WilliamVanRaemdonck/Project_Practise_Enterprise_2_Amplifier/3. Documents/WilliamVanRaemdonck_R0880147_PE2.pptx

## Practice Enterprise Electronics 2

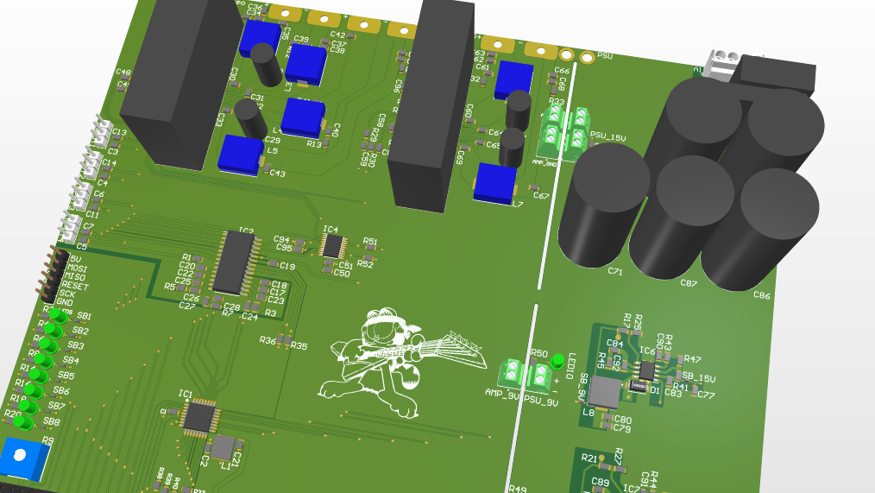
[picture p2: figure]

William Van Raemdonck

## Agenda

- Blokschema
- Componenten
- PCB
- Besluit
- Demo

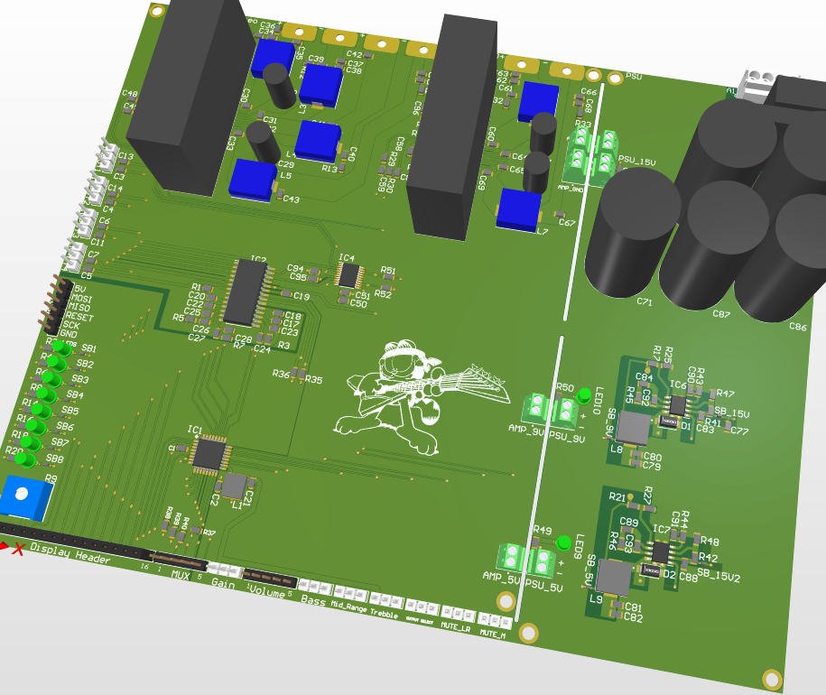
[picture p3: figure]

## Blokschema

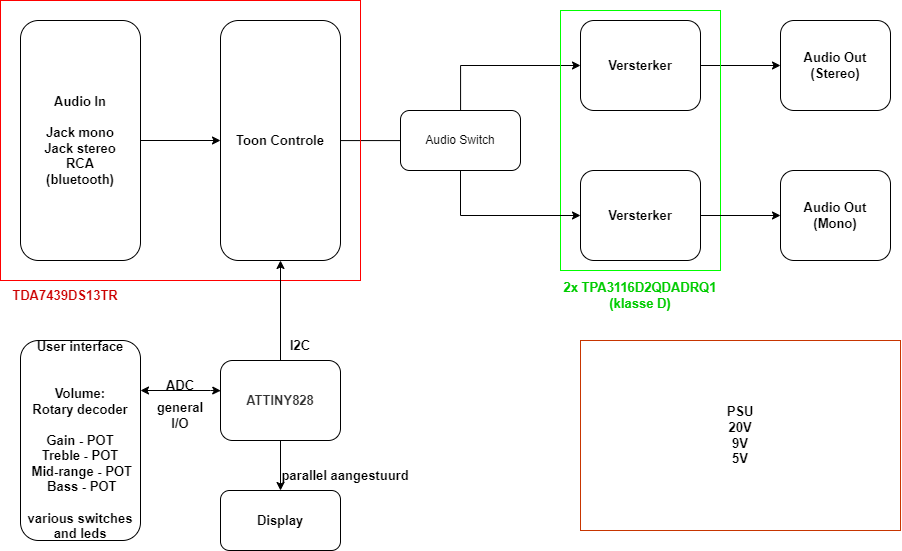
[picture p4: figure]

## Audio controle

- TDA7439DS

- MUX
- Filters
- I2C

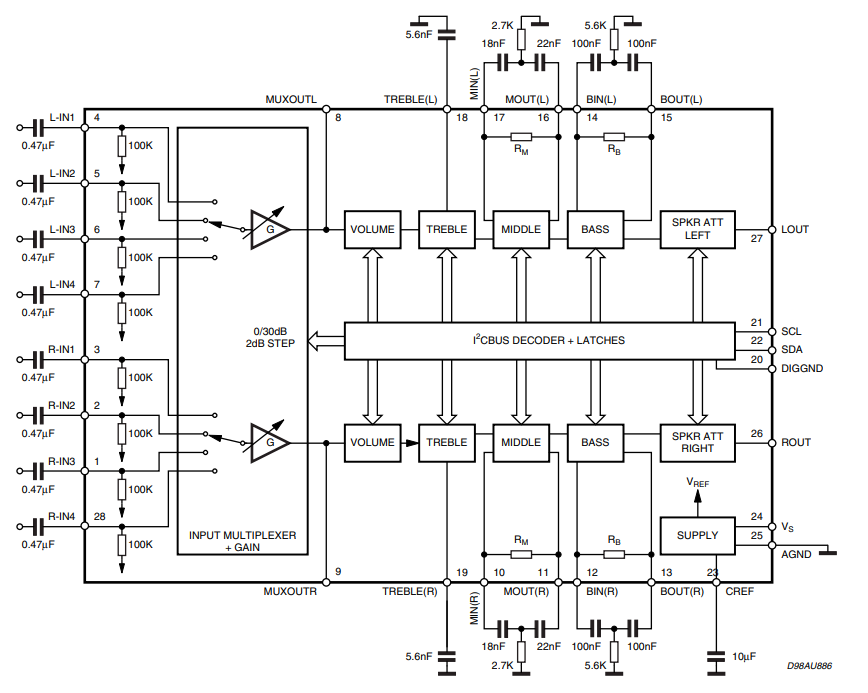
[picture p5: figure]
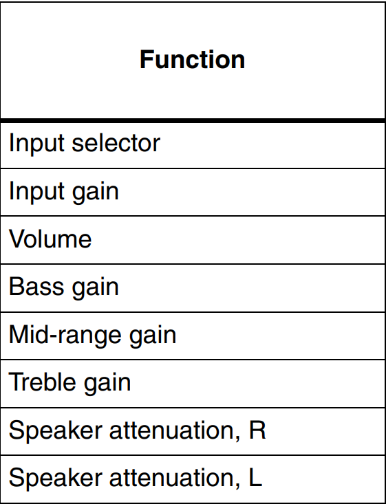
[picture p6: figure]

## Audio switch

- TMUX1134

- Stereo/Mono
- MUTE

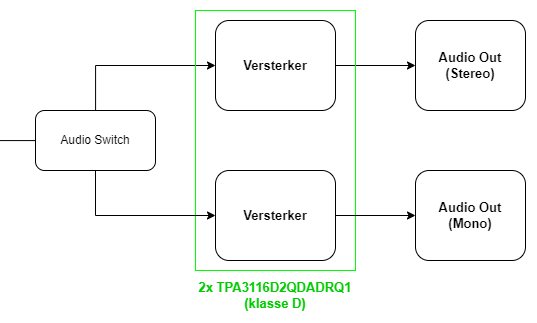
[picture p7: figure]

## Klasse D versterker

- TDA7439DS

- Klasse D
- Stereo/Mono
- Fault system

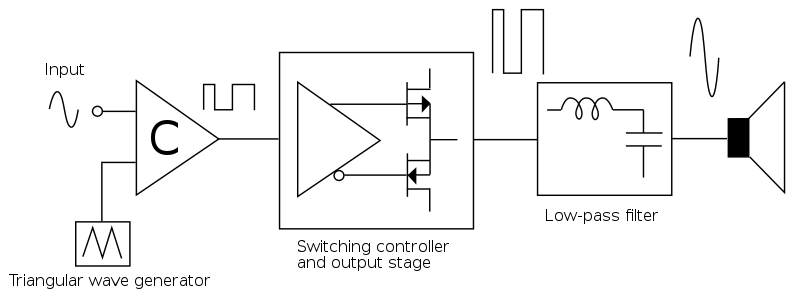
[picture p8: figure]
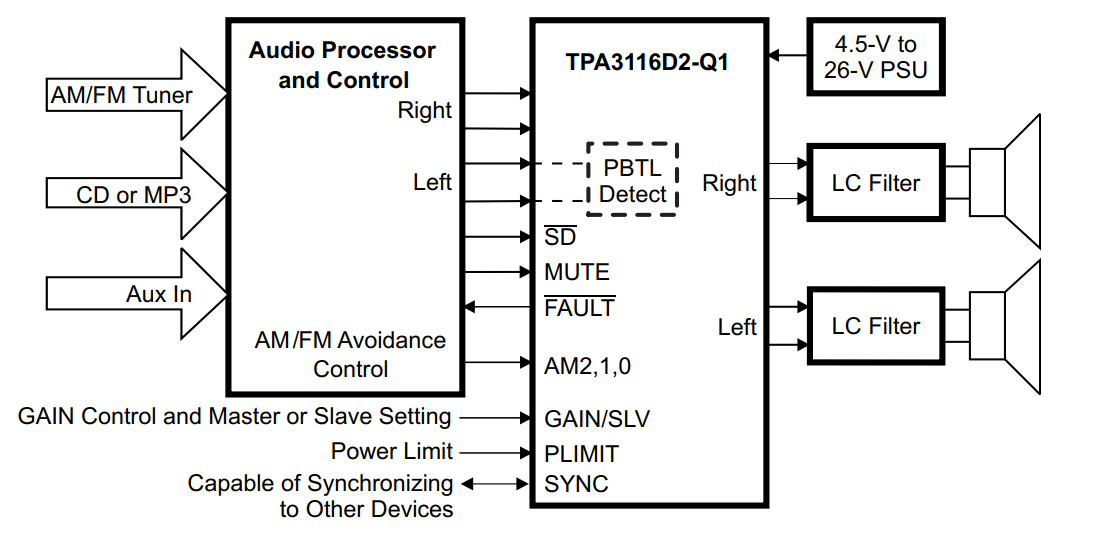
[picture p9: figure]

## Microcontroller

- ATtiny828

- 8Mhz – 8bit
- C
- XC888

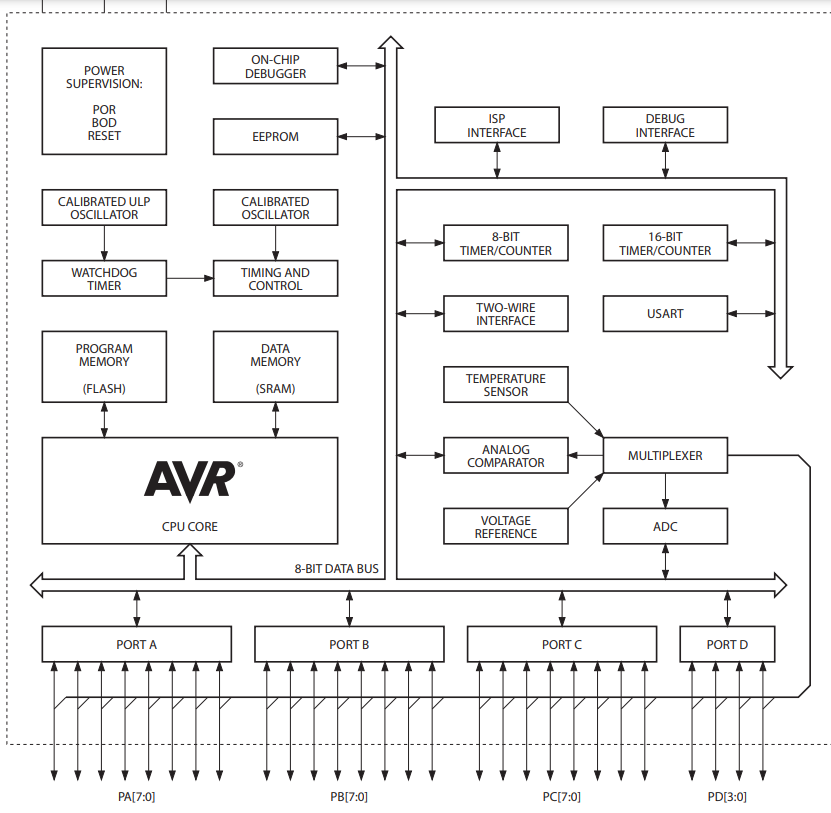
[picture p10: figure]

## Microcontroller

- Programmeren

- ICSP

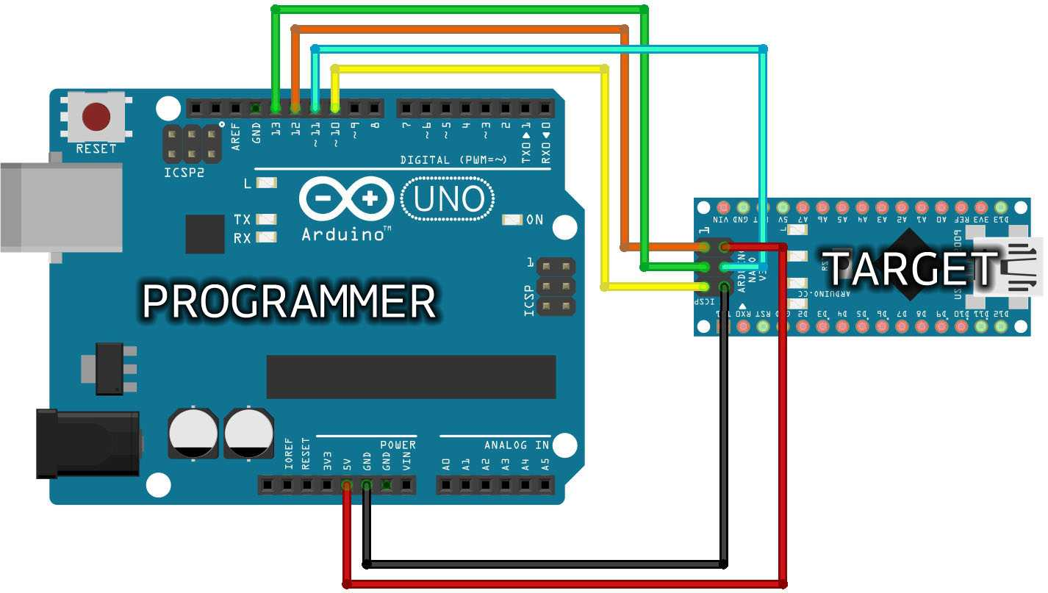
[picture p11: figure]
Arduino as ISP and Arduino Bootloaders | Arduino Documentation

## Display

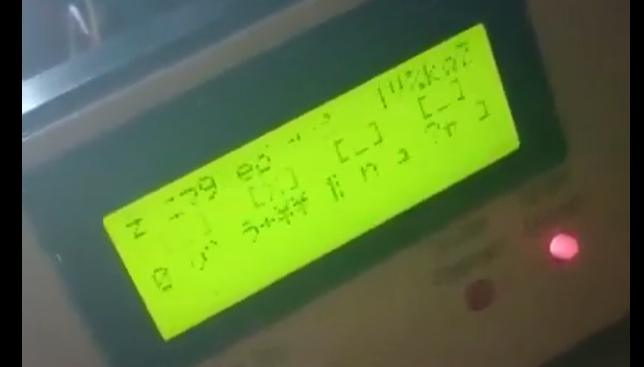
[picture p12: figure]
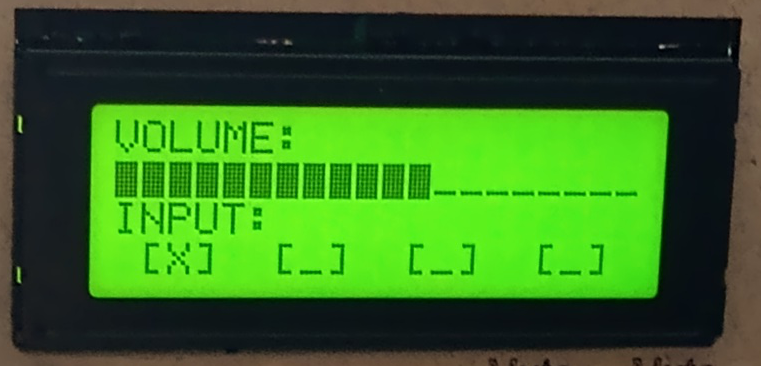
[picture p13: figure]

- 4 bit mode - Parallel
- Anomalie

## PCB

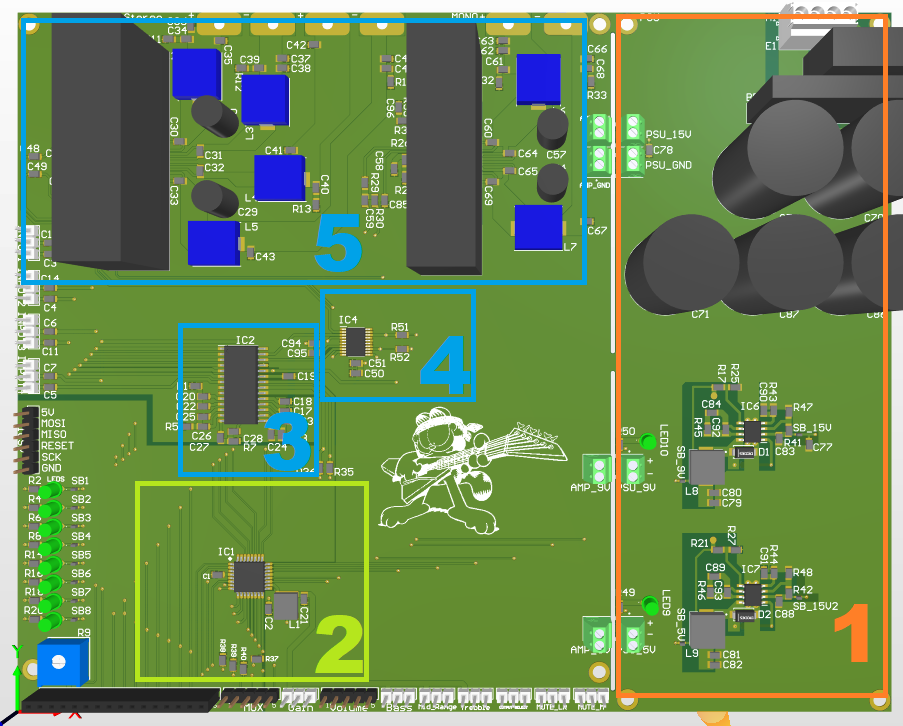
[picture p14: figure]

## Besluit

PCB redelijk groot
DSP
Nameten (want meten is weten)

## Vragen en demo moment
