WilliamVanRaemdonck/Project_Practise_Enterprise_2_Amplifier/3. Documents/Project Practise Enterprise 2 R0880147.docx

# Practice Enterprise Electronics 2

2022 – 2023

Thomas More

William Van Raemdonck

# Inleiding

Voor Project Practice Enterprise 2 heb ik een audio versterker gemaakt. Deze versterker is zodanig opgebouwd dat hij zowel een mono en stereo signaal kan versterken. Er zit ook een IC in dat tooncontrole doet. Deze wordt aangestuurd door een ATtiny828.

“I have a dream.”

Martin Luther King 1963

# Dankwoord

Dankuwel Dams.

# Blokschema

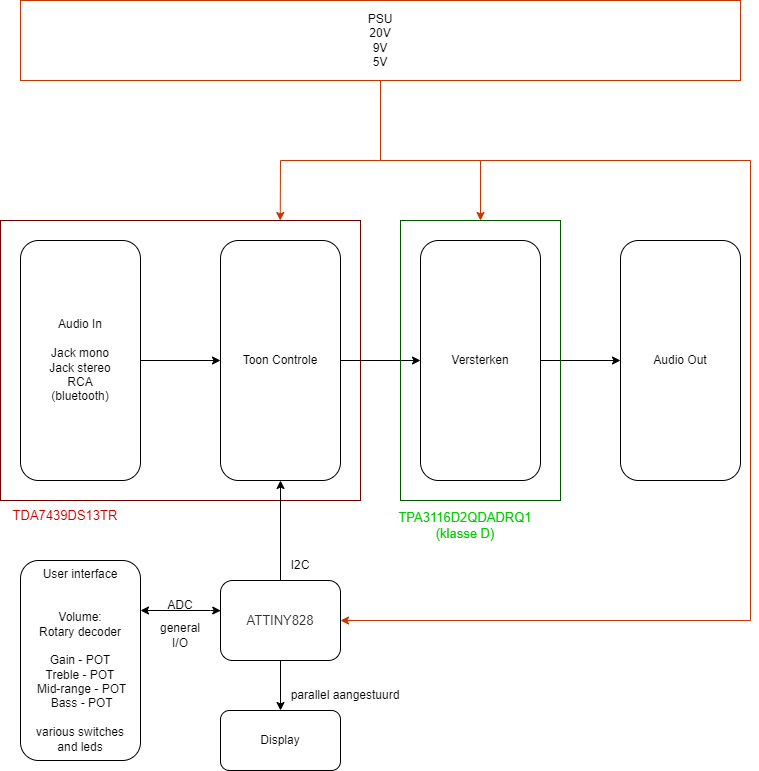
[picture p15: figure]

## Uitleg Blokschema

De power supply gaat 20V leveren voor de versterker IC’s, 9V voor de tooncontrole IC en 5V voor de microcontroller en lcd-paneel.

De tooncontrole IC wordt aangestuurd via een I2C verbinding tussen de microcontroller en deze IC.

De microcontroller gaat zijn ADC en I/O pinnen gebruiken om de gain, bass, midrange, treble, volume waardes in te lezen en door te sturen.

De display is aangestuurd via een 4 bit parallelle verbinding met de microcontroller.

# Componenten

## ATtiny828:

Dit is een 8 Bit controller die tegen 8MHz draait.

Deze IC is vergelijkbaar met de XC888 dat we vorig jaar moesten gebruiken met het belangrijk verschil dat deze gemakkelijk in C kan geprogrammeerd kan worden.

Datasheet: https://ww1.microchip.com/downloads/en/DeviceDoc/doc8371.pdf


## TDA7439DS:

Figuur 1: Registers

Deze IC gaat de audiocontrole doen, hij is aangestuurd via de ATtiny controller via een software I2C verbinding.

Er bestaan registers waarbij de waardes in de figuur hiernaast kunnen worden aangepast.

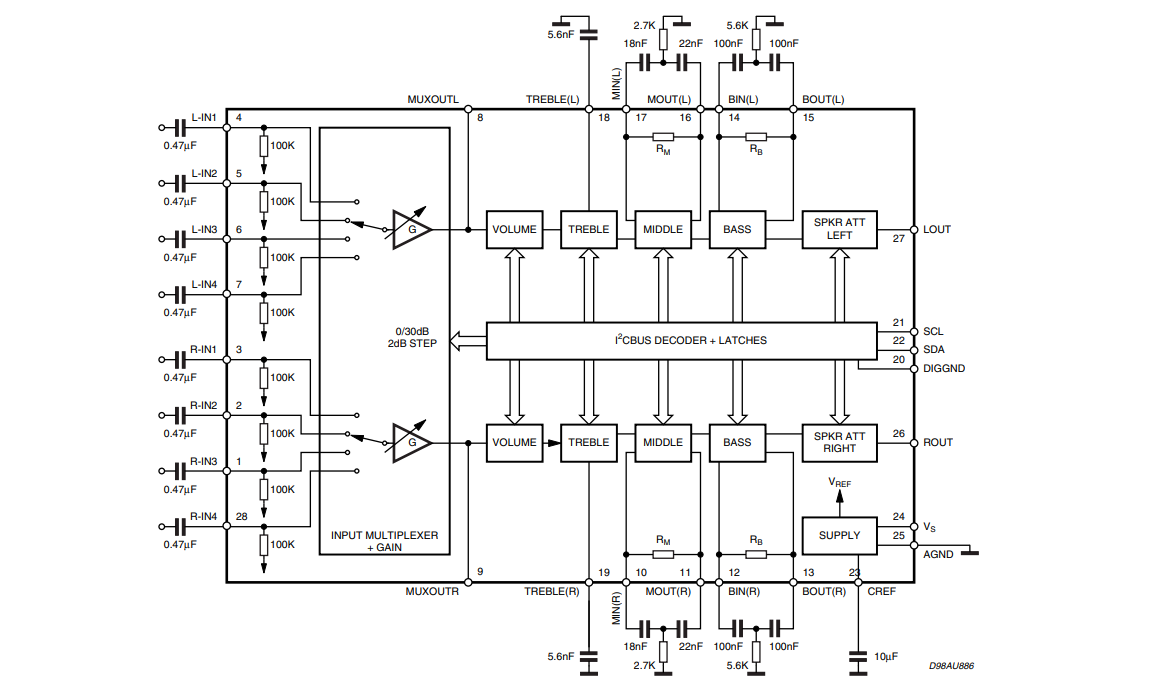
[picture p16: figure]

Figuur 2: Waardes uit datasheet

## TPA3116D2-Q1:

Twee van deze IC’s zitten in deze versterker. Één als stereo en één als mono versterker.

Deze IC heeft een systeem dat fouten detecteert. Het is aangesloten zodat fouten gecleared worden wanneer de fout verdwijnt.

Datasheet:

https://www.ti.com/lit/ds/symlink/tpa3118d2-q1.pdf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

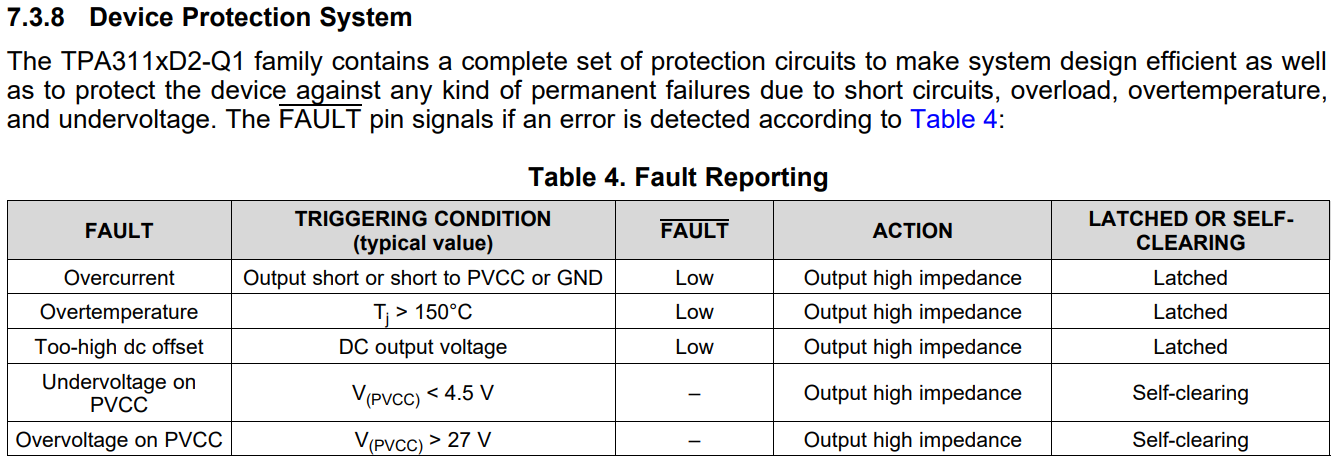
[picture p17: figure]

Gekozen instelling:

PVCC = 20V => output voltage van ongeveer 14,916V. ?? check dees

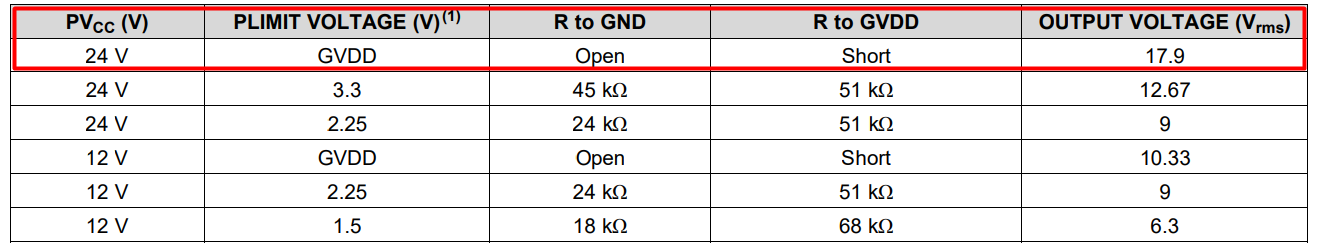
[picture p18: figure]

Gain = 26dB.

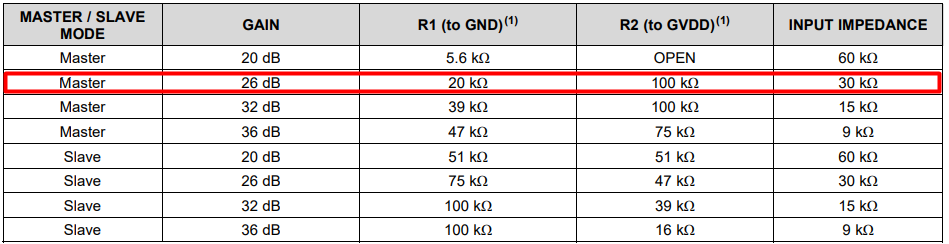
[picture p19: figure]

Input condensatoren.

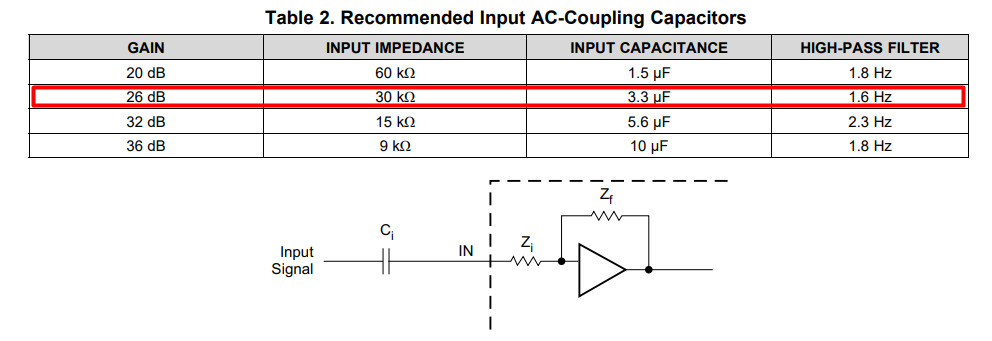
[picture p20: figure]

Oscillator frequentie.

Stroom.

Vout max = 14,916V

Rspeaker = 4Ω

Imax = 3,729A

Koeling.

De datasheet zegt dat deze koelvin moet gebruikt worden.

Datasheet:

https://www.mouser.be/ProductDetail/984-ATS-TI1OP521C1R1

## TMUX1134:

Deze IC schakelt van tussen de stereo en mono versterker door het audiosignaal van de ene versterker naar de andere te sturen. Tegelijkertijd wordt de versterker IC dat niet gebruikt wordt ook gemute zodat de uitgang tevens ook hoog impedant gaat.

Het audiosignaal heeft een 3,8V dc-offset en het mute signaal zit tussen de 0 en 5V. Dit is omdat ik zo geen extra transistor of FET moest bijplaatsen om het MUTE-signaal te kunnen regelen.

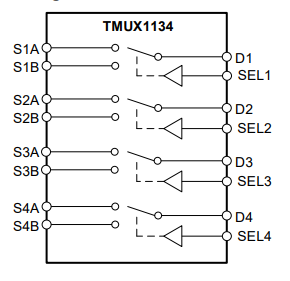
[picture p21: figure]

Figuur 3: Audio switch

## Display:

Deze display is parallel aangesloten aan de microcontroller. De 1e en 3e lijn zijn constante strings die tijdens initialisatie worden doorgestuurd.

De lijn indicator die het volume aanduidt wordt op runtime gemaakt. De string die de input aangeeft wordt geselecteerd met een look up table.

Voor de display in te stellen zijn de volgende instellingen gebruikt.

Function Set:

- 4 bit interface
- 2 lines
- Font size 8 x 5

De display heeft ook 2 andere lijnen: de enable en RS-lijn. De enable wordt gebruikt als een klok lijn om nieuwe data binnen te klokken. De RS-lijn bepaalt of je naar een data of instructie register schrijft. Verder is er ook nog de R/W lijn maar in dit geval hangt deze aan ground omdat er alleen maar geschreven moet worden.

Om bij te houden naar welke welke plaats op de display er geschreven moet worden wordt gebruik gemaakt van het DDRAM-adres. Startende van 0x80 tot 0xe7.

VOLUME: adres: 0x80

█████____________ adres: 0xc0

INPUT: adres: 0x94

[_] [_] [X] [_] adres: 0xd4


Figuur 4: Display

# PCB


Figuur 5: pcb-voorkant

Zone 1: Power Supply.

Zone 2: Microcontroller

Zone 3: Audiocontrole IC.

Zone 4: Audio switch

Zone 5: Mono/Stereo versterker.

# Schema’s

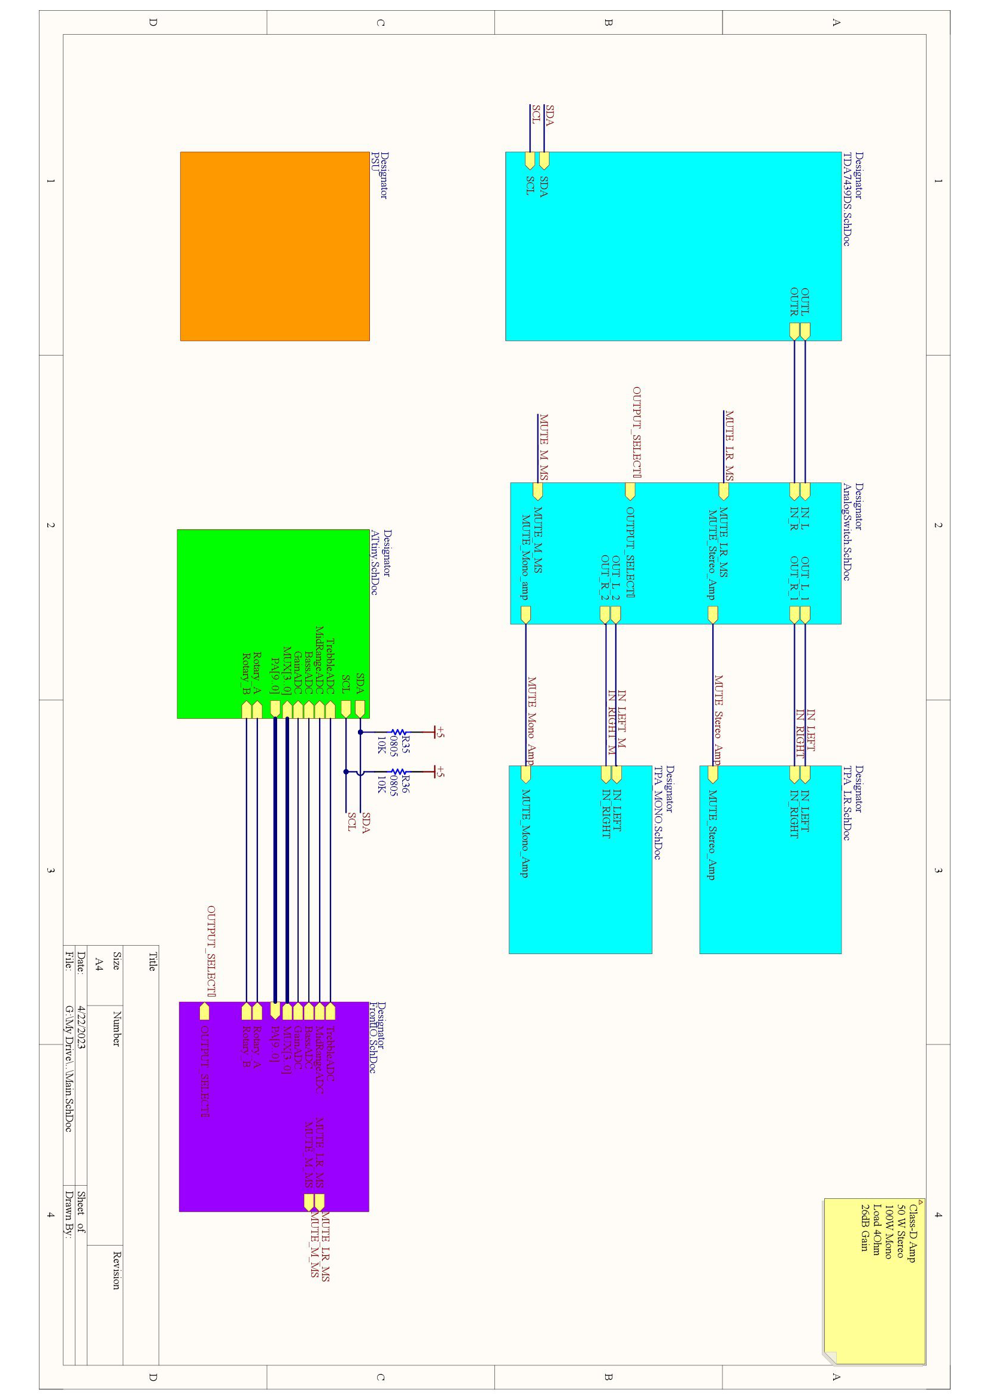
[picture p22: figure]
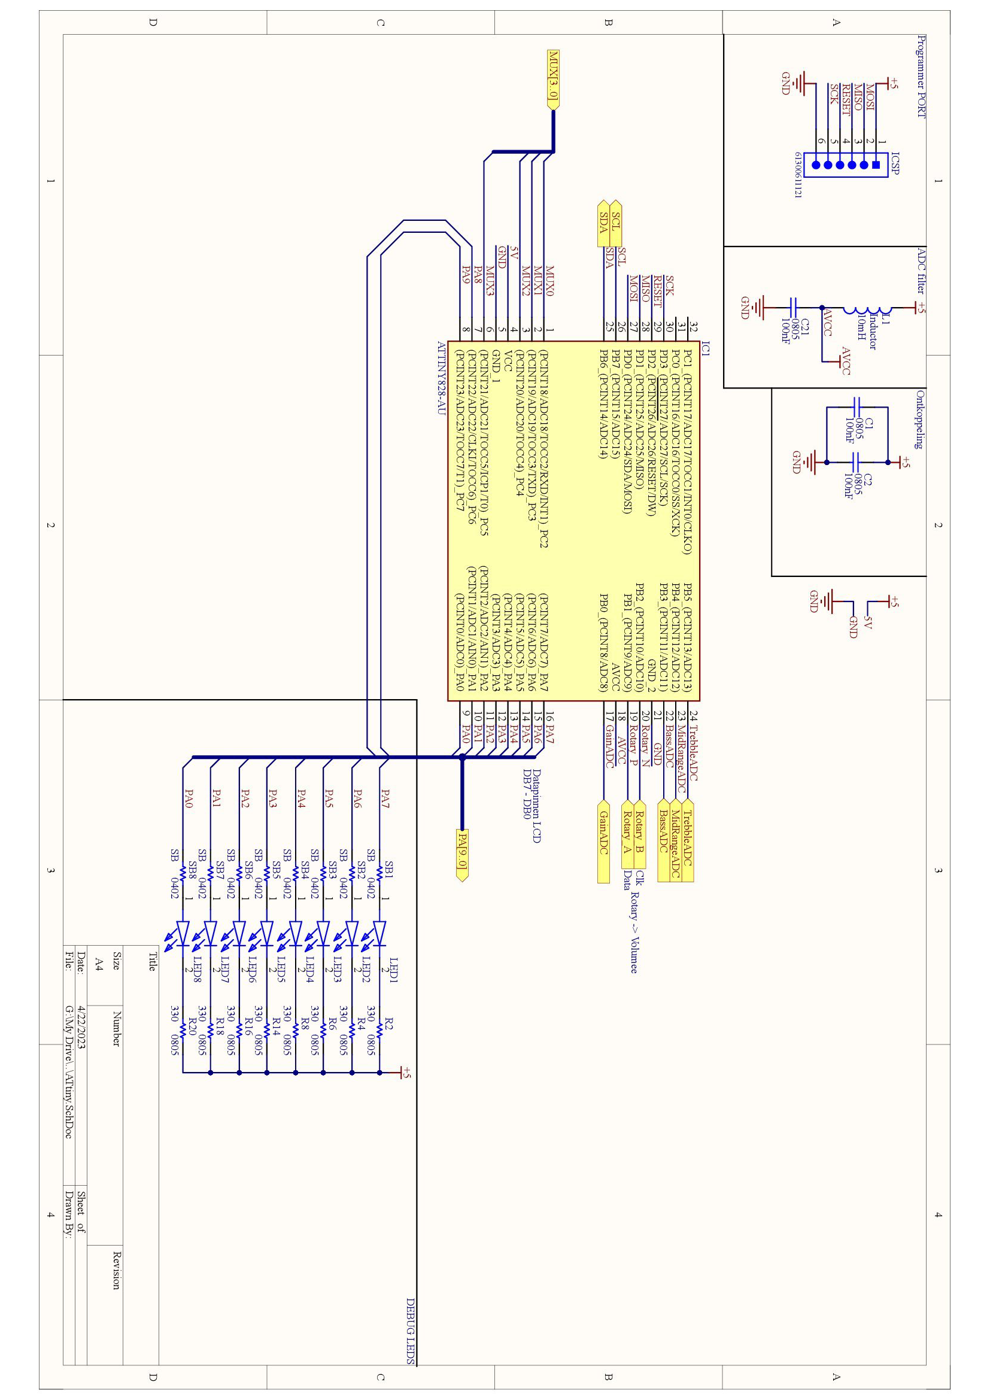
[picture p23: figure]
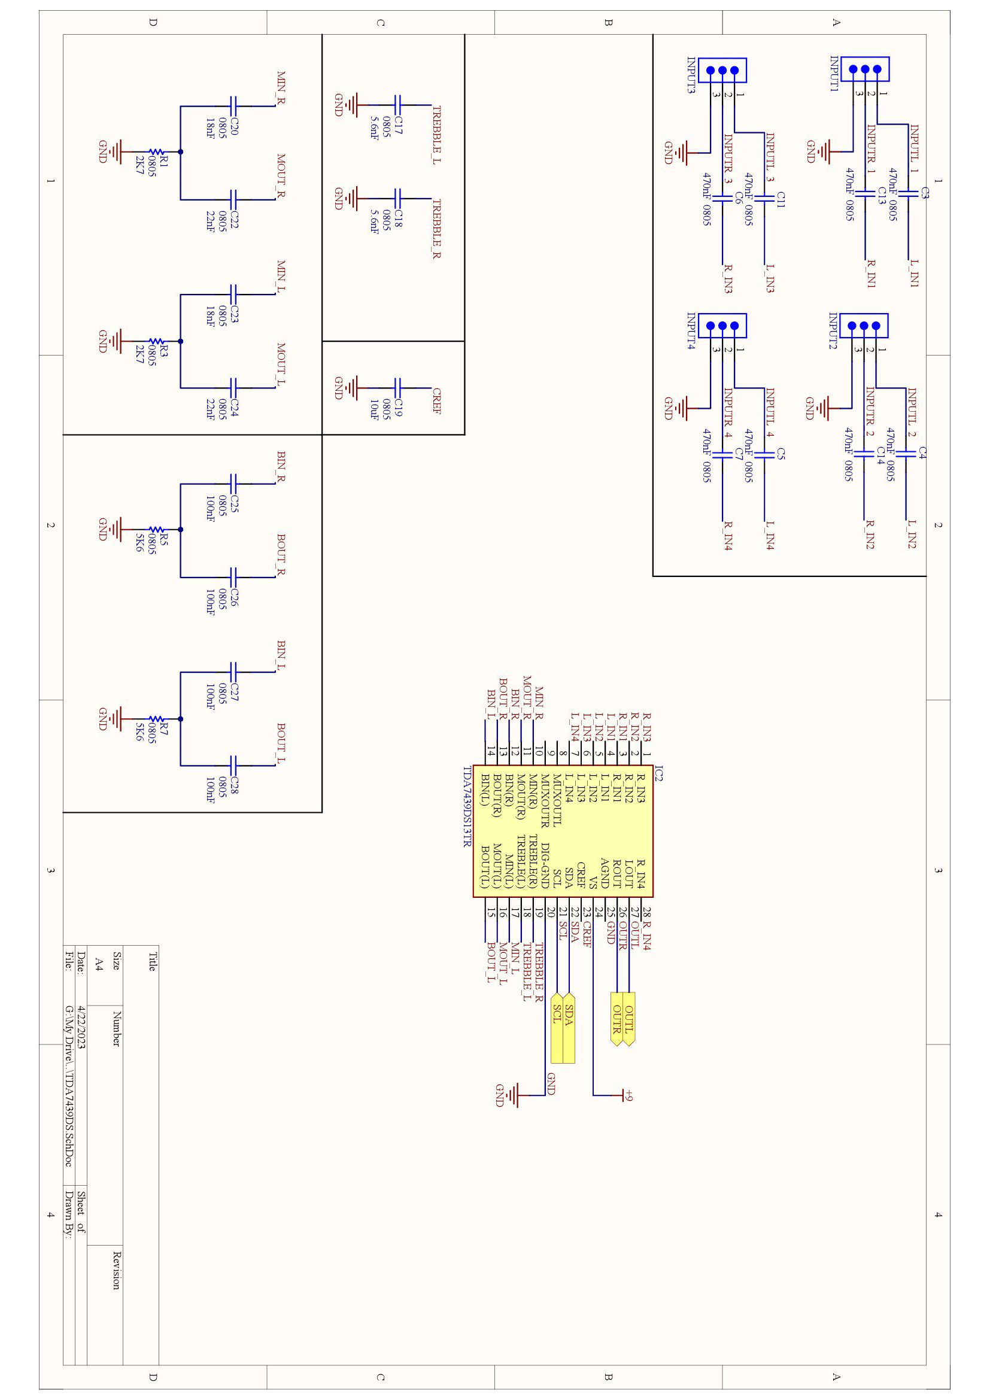
[picture p24: figure]
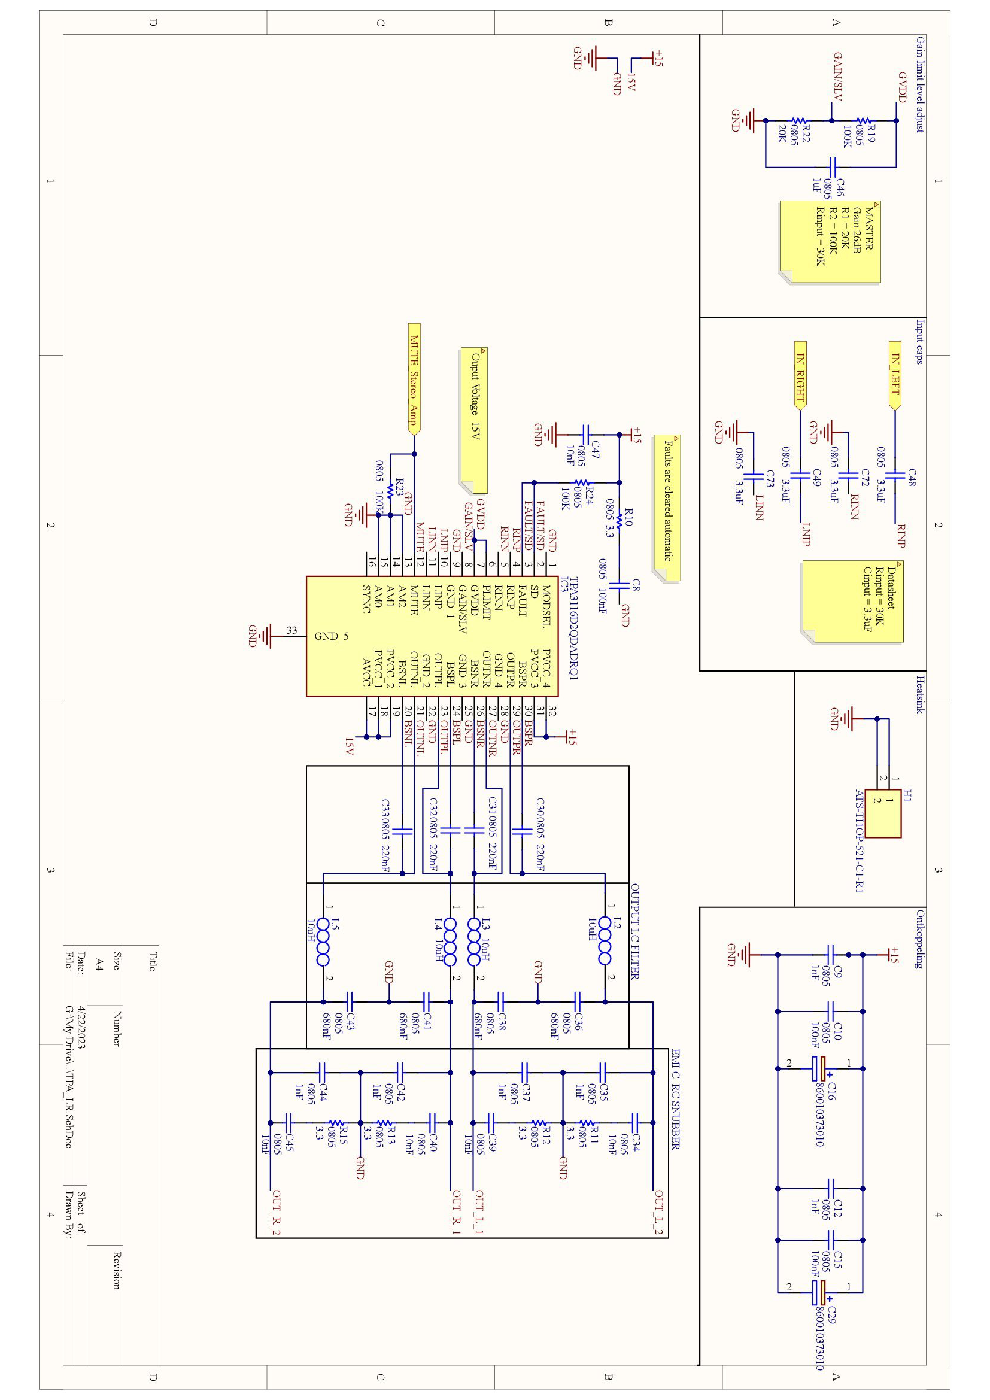
[picture p25: figure]
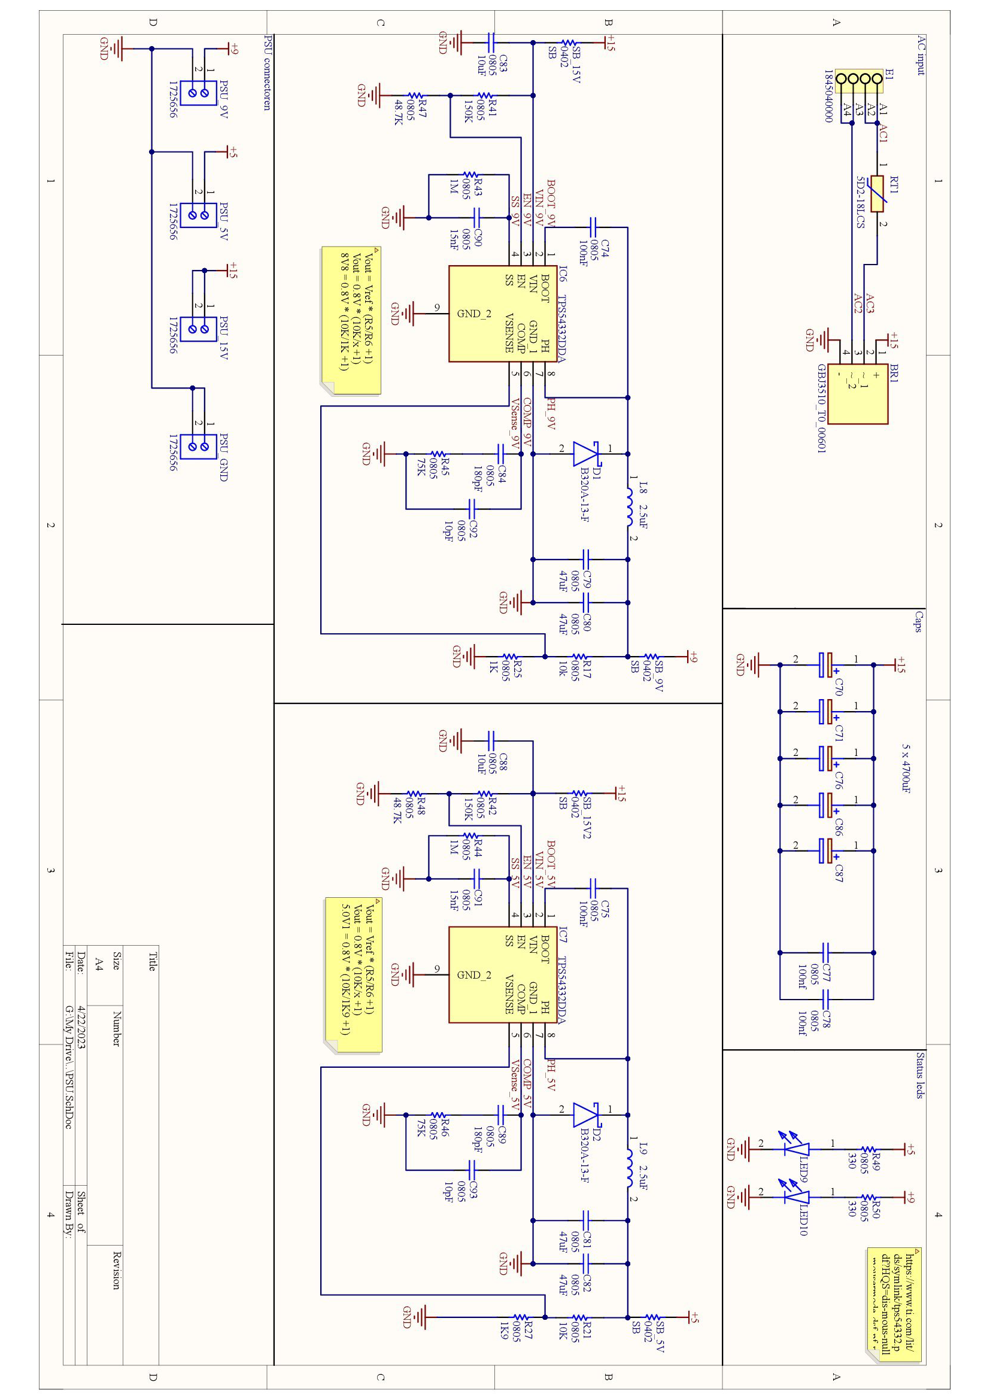
[picture p26: figure]
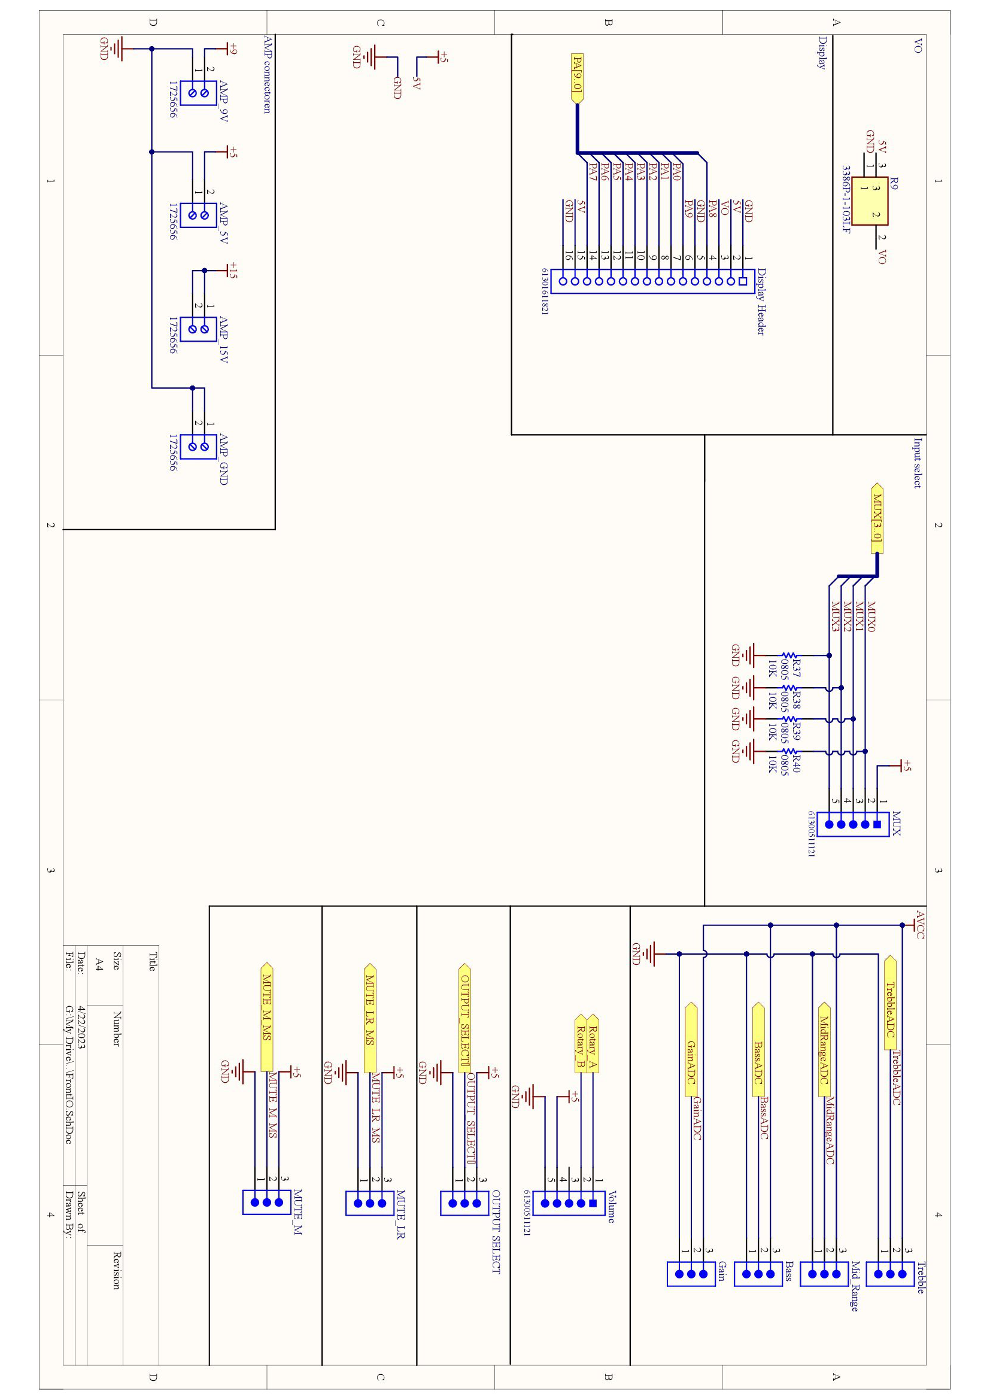
[picture p27: figure]
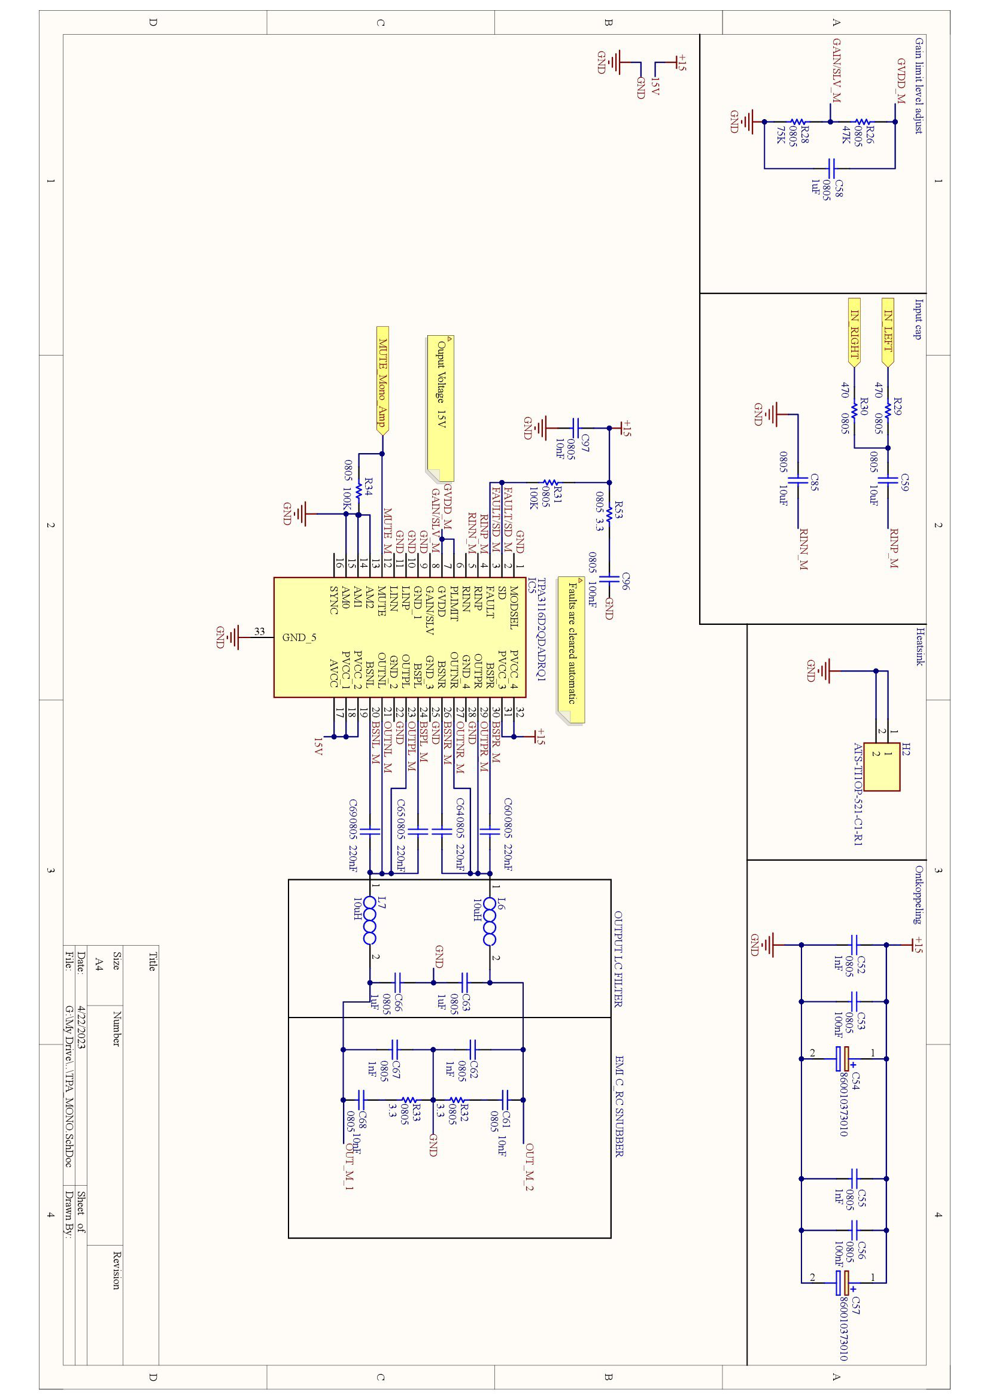
[picture p28: figure]
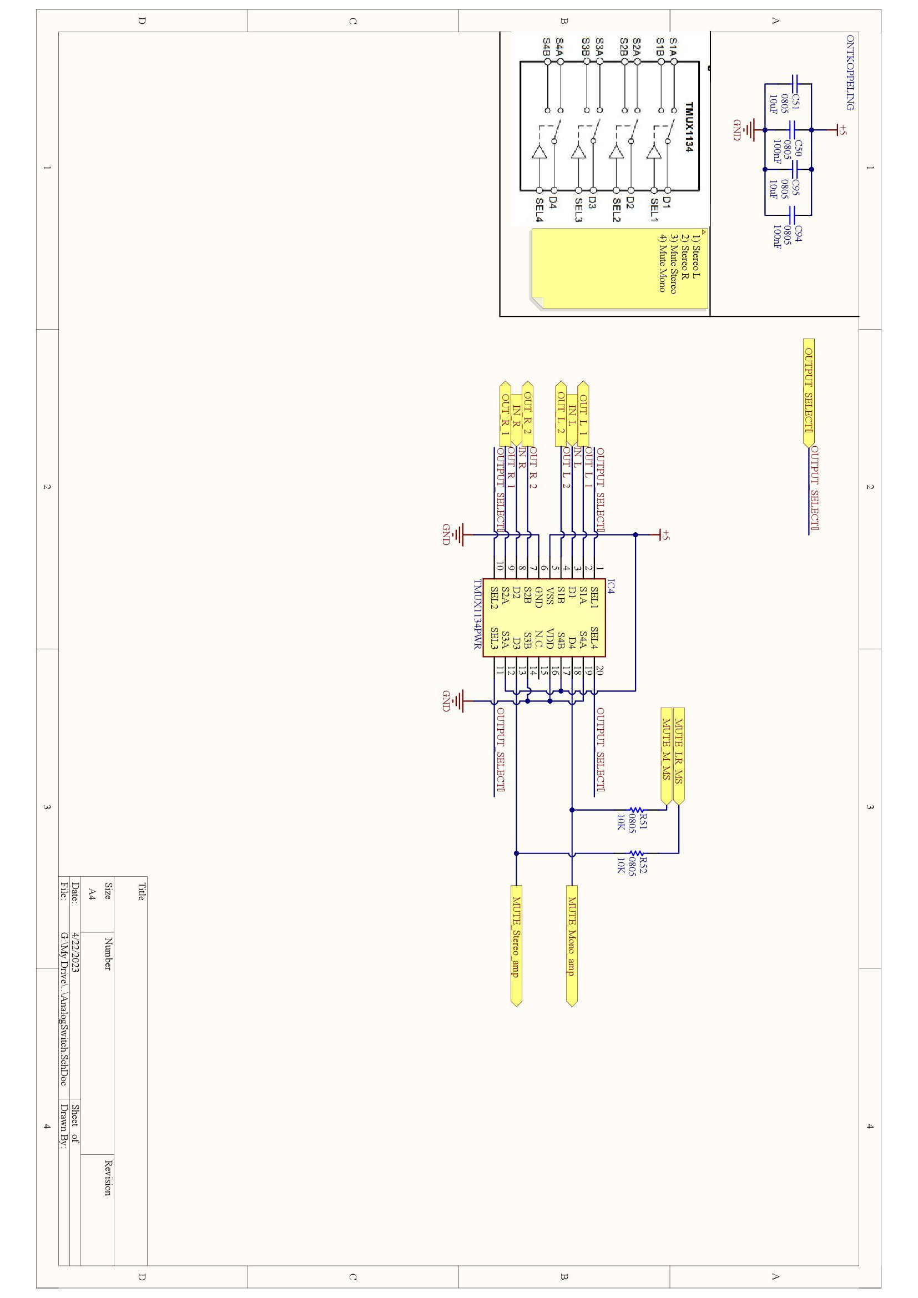
[picture p29: figure]

# Code

# BOM

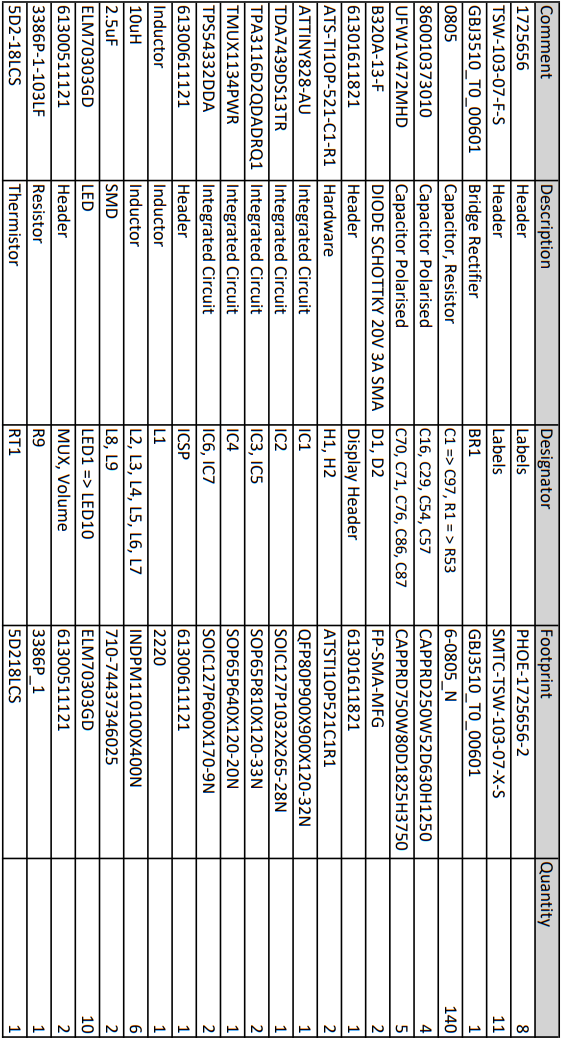
[picture p30: figure]

Figuur 6: Bom lijst

# Bibliografie

Datasheets:

ATtiny828:

https://ww1.microchip.com/downloads/en/DeviceDoc/doc8371.pdf

TPA3118d2:

https://www.ti.com/lit/ds/symlink/tpa3118d2-q1.pdf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

TDA7439DS:

https://www.mouser.be/datasheet/2/389/cd00010668-1796242.pdf

Display:

https://uk.beta-layout.com/download/rk/RK-10290_410.pdf

Code:

Reverse Bits in Byte:

https://stackoverflow.com/questions/2602823/in-c-c-whats-the-simplest-way-to-reverse-the-order-of-bits-in-a-byte

Chat.gpt:

General code optimalisatie.
