WilliamVanRaemdonck/Project_Practise_Enterprise_2_Amplifier/3. Documents/Project Practise Enterprise 2 R0880147 William Van Raemdonck.pdf

1

2022 – 2023

Thomas More
William Van Raemdonck

# Practice Enterprise Electronics 2

2

# Inleiding

Voor Project Practice Enterprise 2 heb ik een audioversterker gemaakt. Deze versterker is zodanig opgebouwd dat hij zowel een mono-en stereosignaal kan versterken. Er zit ook een IC in die tooncontrole doet, die op zijn beurt wordt aangestuurd door een microcontroller.

Verder ben ik in de zomervakantie van vorig jaar al gestart aan dit project door een development bordje te maken voor de ATtiny828. Dit heb ik vooral gedaan omdat ik niet meer met de XC888 van vorig jaar wou werken. Dit bordje heeft mij ook toegelaten om al code te schrijven voor de PCB geleverd was. De details hierover staan ook in de bijlage.

Bijlage in aparte documenten: https://github.com/WilliamVanRaemdonck/Project_Practise_Enterprise_2_Amplifier

## “Do or do not. There is no try.” Yoda - The Empire Strikes Back

3

# Dankwoord

Het maken van deze versterker tijdens het afgelopen academiejaar was een leerrijke periode. Ik had deze taak nooit zo goed afgerond zonder de hulp van een paar mensen.

Een bijzonder woord van dank gaat uit naar meneer Dams, die de tijd nam om constructieve feedback te geven. Zijn wijze raad als mentor heeft me geholpen om problemen te analyseren. Hij stelde me goeie vragen die ervoor gezorgd hebben dat ik oplossingsgericht kon werken.

Ik wil eveneens meneer De Weerdt en meneer Pelgrims bedanken voor het delen van hun kennis.

Ook mijn vrienden en familie hebben me steeds aangemoedigd zodat ik me gesteund voelde om dit project tot een goed einde te brengen.

William Van Raemdonck

4

Contents


5

# Blokschema

6

## Uitleg Blokschema

De power supply levert 20V voor de versterker IC’s, 9V voor de tooncontrole IC en 5V voor de microcontroller en het lcd-paneel.

De tooncontrole IC wordt aangestuurd door een microcontroller via een software I2C verbinding.

De microcontroller gebruikt zijn ADC en I/O pinnen om de gain, bass, midrange, treble, volume waardes in te lezen. Hij gaat hier dan omzettingen op doen om daarna door te sturen naar de audiocontrole IC.

De display is aangestuurd via een 4 bit parallelle verbinding met de microcontroller.

7

# Componenten

## ATtiny828:

Dit is een 8 Bit controller die met een klok frequentie van 8Mhz.

Deze IC is vergelijkbaar met de XC888 dat we vorig jaar moesten gebruiken met het belangrijk verschil dat deze gemakkelijk in C geprogrammeerd kan worden en iets minder I/O pinnen heeft.

De belangrijkste delen van deze microcontroller zijn:
Hardware SPI.
Hardware I2C slave.
Full Duplex USART
2 timers waarvan één 16 bit.
32 ADC kanalen (10 bit resolutie).
20MHz kloksnelheid.

De IC wordt geprogrammeerd via de ICSP pinnen van een Arduino, je kan ook een AVR programmer kopen. Ik heb deze optie gekozen omdat deze gratis was.

Om code in deze controller te krijgen staat er een condensator op de reset pin van een Arduino nadat deze zelf geprogrammeerd is als ISP programmer. Hierna zal Microchip studio zijn code sturen naar AVRDUDE om de code naar de Arduino en dus ook de ATtiny te sturen. AVRDUDE kent de ATtiny828 niet maar er is een override optie zodat deze de code toch uploadt.

## TDA7439DS:

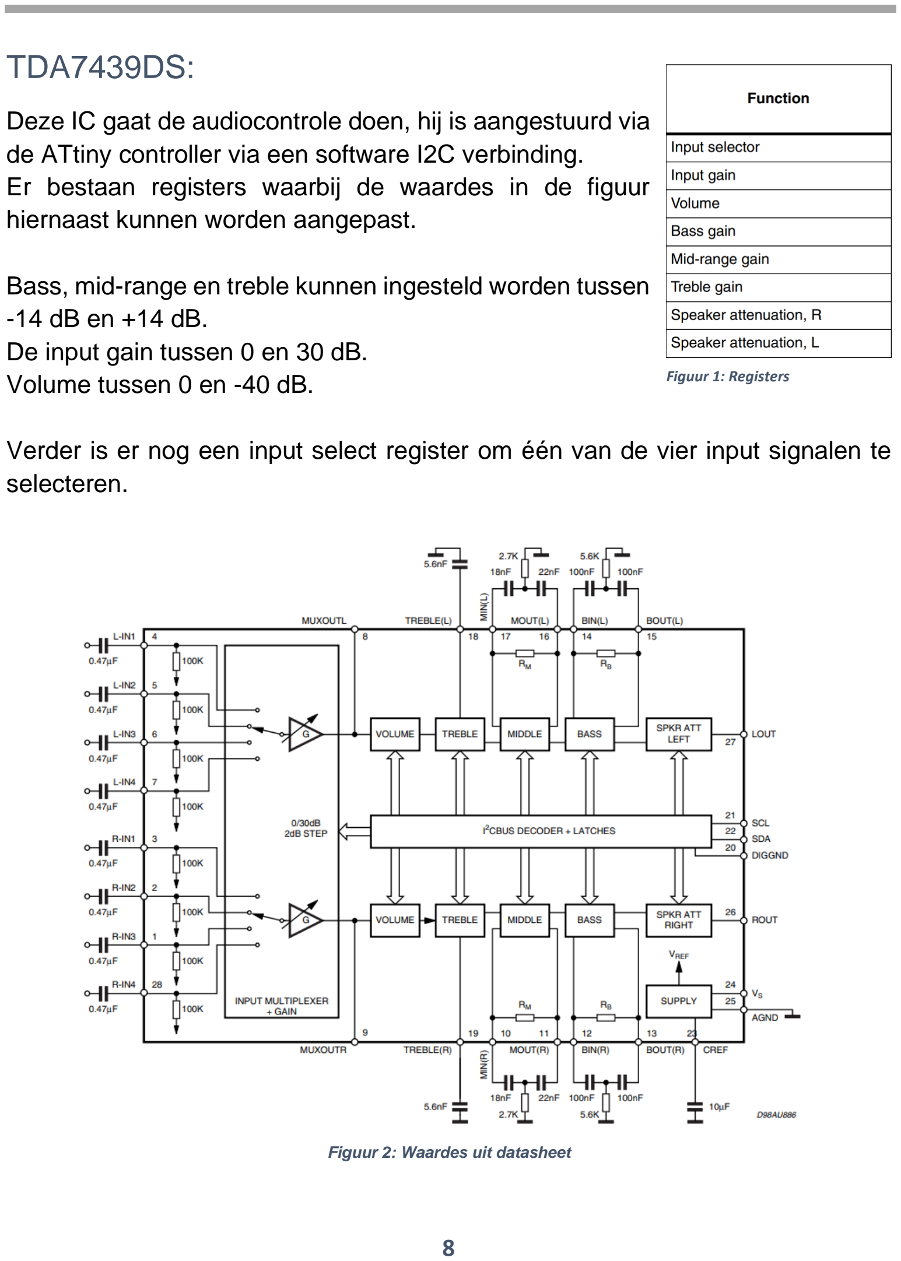
[picture p31: page 8]

8

Deze IC gaat de audiocontrole doen, hij is aangestuurd via de ATtiny controller via een software I2C verbinding.
Er bestaan registers waarbij de waardes in de figuur hiernaast kunnen worden aangepast.

Bass, mid-range en treble kunnen ingesteld worden tussen -14 dB en +14 dB.
De input gain tussen 0 en 30 dB.
Volume tussen 0 en -40 dB.

Verder is er nog een input select register om één van de vier input signalen te selecteren.

Figuur 2: Waardes uit datasheet

Figuur 1: Registers

## TPA3116D2-Q1:

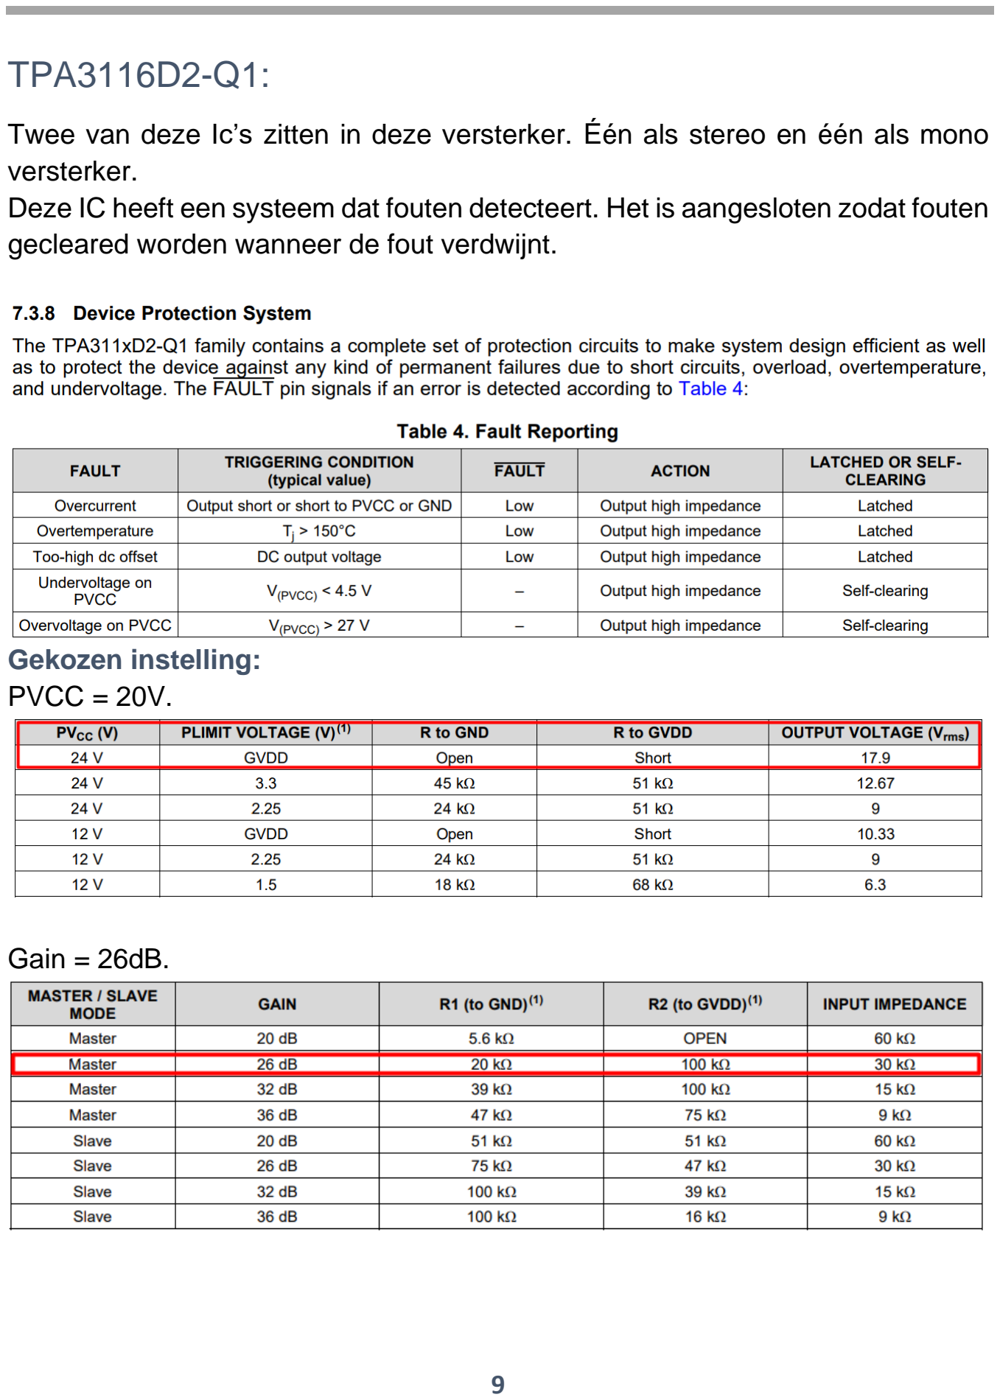
[picture p32: page 9]

9

Twee van deze Ic’s zitten in deze versterker. Één als stereo en één als mono versterker.
Deze IC heeft een systeem dat fouten detecteert. Het is aangesloten zodat fouten gecleared worden wanneer de fout verdwijnt.

Gekozen instelling:
PVCC = 20V.

Gain = 26dB.

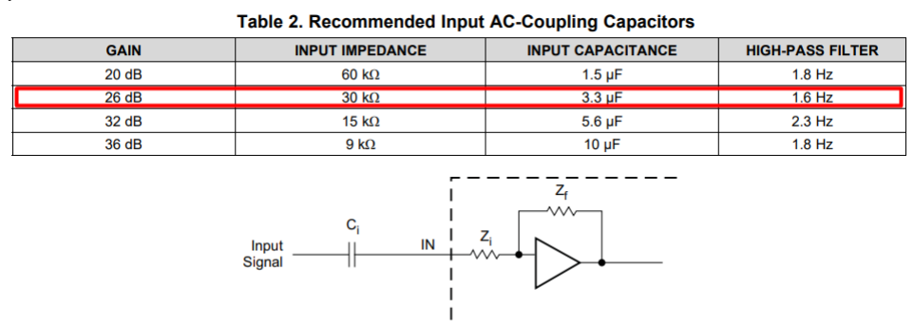
[picture p33: figure]

10

Input condensatoren.

Oscillator frequentie.

Belangrijke waardes.

Vout ~ = 14,916V.
Rspeaker = 4Ω.
Imax = 3,729A.
Gain = 26dB.

Koeling.

De datasheet zegt dat deze koelvin moet gebruikt worden. Datasheet:
https://www.mouser.be/ProductDetail/984-ATS-TI1OP521C1R1

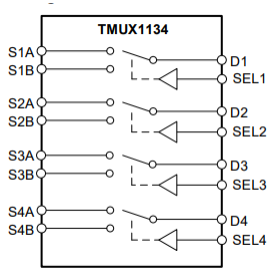
[picture p34: figure]

11

## TMUX1134:

Deze IC schakelt van tussen de stereo-en mono versterker door het audiosignaal van de ene versterker naar de andere te sturen. Tegelijkertijd wordt de versterker IC die niet gebruikt wordt ook gemuted zodat de uitgang tevens ook hoog impedant gaat.

Het audiosignaal heeft een 3,8V dc-offset en het mute signaal zit tussen de 0 en 5V. Dus deze IC kan dit perfect aan. Verder gebruik ik deze IC ook omdat ik zo geen extra transistor of FET moest bijplaatsen om het MUTE-signaal te kunnen regelen.

Figuur 3: Audio switch

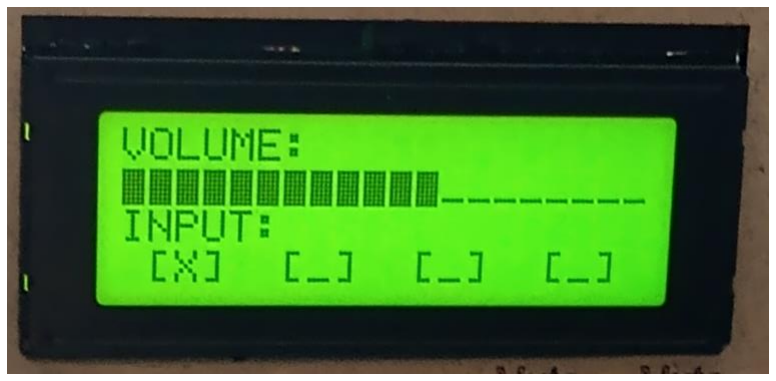
[picture p35: figure]

12

## Display:

Deze display is parallel aangesloten aan de microcontroller. De 1e en 3e lijn zijn constante strings die tijdens initialisatie worden doorgestuurd.
De lijnindicator die het volume aanduidt wordt op runtime gemaakt. De string die de input aangeeft wordt geselecteerd met een look up table.
Voor de display in te stellen zijn de volgende instellingen gebruikt.
Function Set:
- 4 bit interface
- 2 lines
- Font size 8 x 5

De display heeft ook 2 andere lijnen: de enable en RS-lijn. De enable wordt gebruikt als een kloklijn om nieuwe data binnen te klokken. De RS-lijn bepaalt of je naar een data-of instructieregister schrijft. Verder is er ook nog de R/W lijn maar in dit geval hangt deze aan ground omdat er alleen maar geschreven moet worden.

Om bij te houden naar welke plaats op de display er geschreven moet worden wordt gebruik gemaakt van het DDRAM-adres. Startende van 0x80 tot 0xe7.

Figuur 4: Display

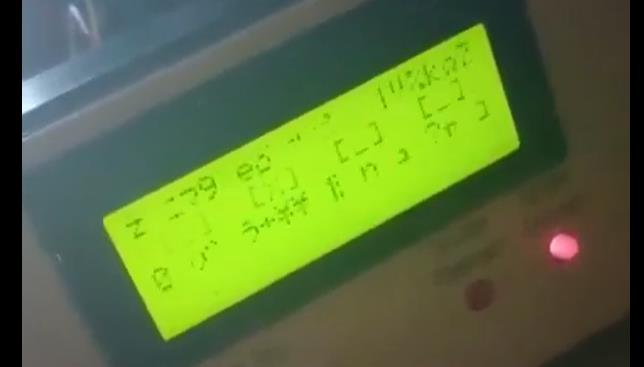
[picture p36: figure]

13

Problemen Display:
Tijdens het testen van de versterker is deze display wat onverklaarbaar gedrag beginnen vertonen. Hij begint willekeurige karakters op het scherm te tonen. Dit gebeurt soms als de spanning heel snel op en afgezet wordt. Verder heb ik dit ook één keer zien gebeuren wanneer ik een audio input aansloot.

Om dit te verhelpen heb ik meer condensatoren bijgezet op de voedingslijnen van de display en power supply.

Verder dacht ik ook dat het misschien te maken had met de power supply die niet snel genoeg zijn spanning liet wegvallen. Ik had een extra load weerstand bijgezet op de 5V maar dit hielp niet. Verder zou dit ook willen zeggen dat de schakelende voeding ook geen nut meer heeft aangezien er toch vermogen verloren wordt door deze weerstand.

De laatste hypothese die ik heb is dat ik deze display in mijn eerste jaar elke dag mee naar school heb genomen. Ik fiets elke dag 1u over soms niet ideale wegen. Misschien is de display ergens kapot vanbinnen door deze constante schokken. Dit lijkt mij wel een beetje vergezocht.

Figuur 5: Foto anomalie

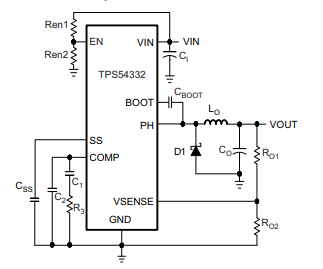
[picture p37: figure]

14

## Power supply:

De power supply voorziet 20V, 9V en 5V voorzien. Voor de 5V en 9V zijn er schakelende spanningsregelaars.
Deze voeding is zodanig ontworpen dat deze ook andere spanningen kan leveren. De spanningsregelaars werken met een feedbacksysteem waarmee de uitgangsspanning kan worden ingesteld.
Verder kan de print ook afgebroken worden van de versterker PCB zodat deze in andere projecten kan worden gestoken.
De schakelende regelaar is de TPS54332DDA.

Figuur 6: Schema regelaar

15

# Besluit

Dit was een zeer leerzaam project, vooral omdat ik niet veel van audioversterkers afwist voor ik aan dit project begon. Verder heb ik wel een paar puntjes dat ik anders zou doen naar de toekomst toe.

De PCB is redelijk groot en ik denk dat de Pcb’s nog steeds modulair hadden kunnen zijn op een kleinere oppervlakte. De 8 debug-leds waren ook een beetje overbodig en zijn tijdens het maken van het project eigenlijk nooit gebruikt.

Voor de microcontroller en audiocontrole denk ik dat het ook handiger had geweest mocht er gebruikt zijn gemaakt van een DSP en een STM-controller. Dit had ook geholpen met een kleinere PCB en had uploaden van code iets gemakkelijker gemaakt.
De audiocontrole IC die ik gebruik is namelijk al 16 jaar oud.

Bij het begin van dit project had ik ook de beslissing gemaakt om thuis eerst eens te kijken wat ik nog had liggen zodat ik niet alles nieuw moest bestellen. Wat ik hieruit ook geleerd heb is dat je best alle componenten die je hergebruikt eens nameet en test voordat je ze in een project steekt. Dit helpt ook om mogelijke fouten in het debug stadium van het project rapper op te sporen.

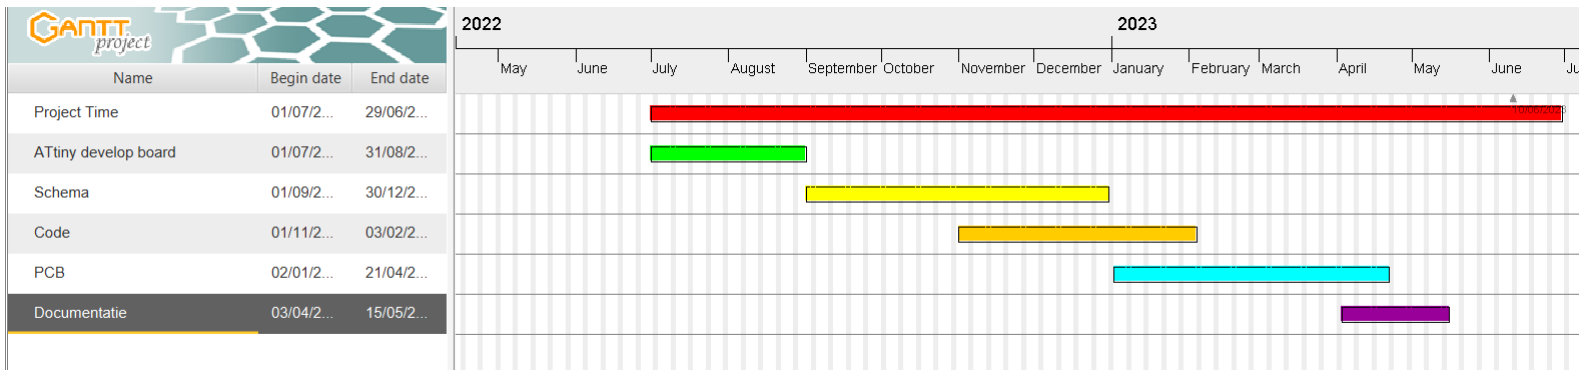
[picture p38: figure]

16

# Gantt Chart

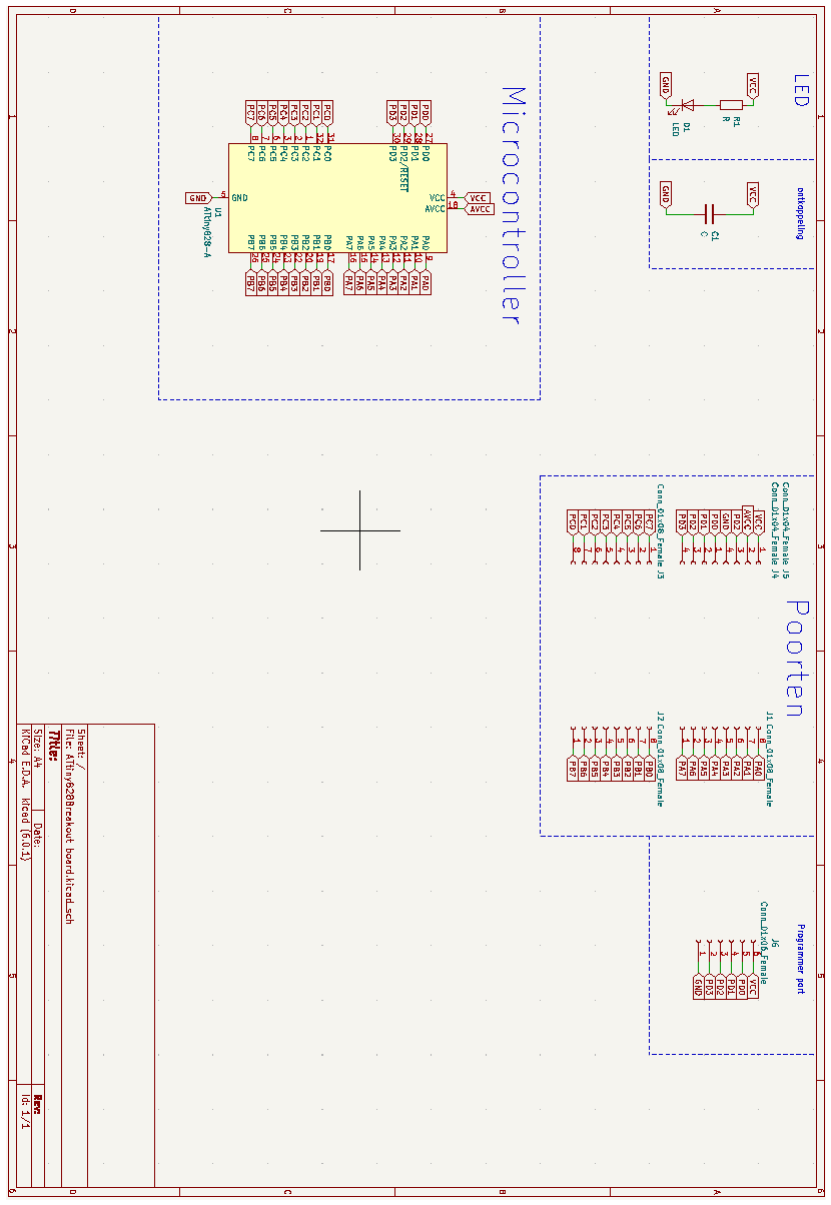
[picture p39: figure]

17

# Test bord

## Schema:

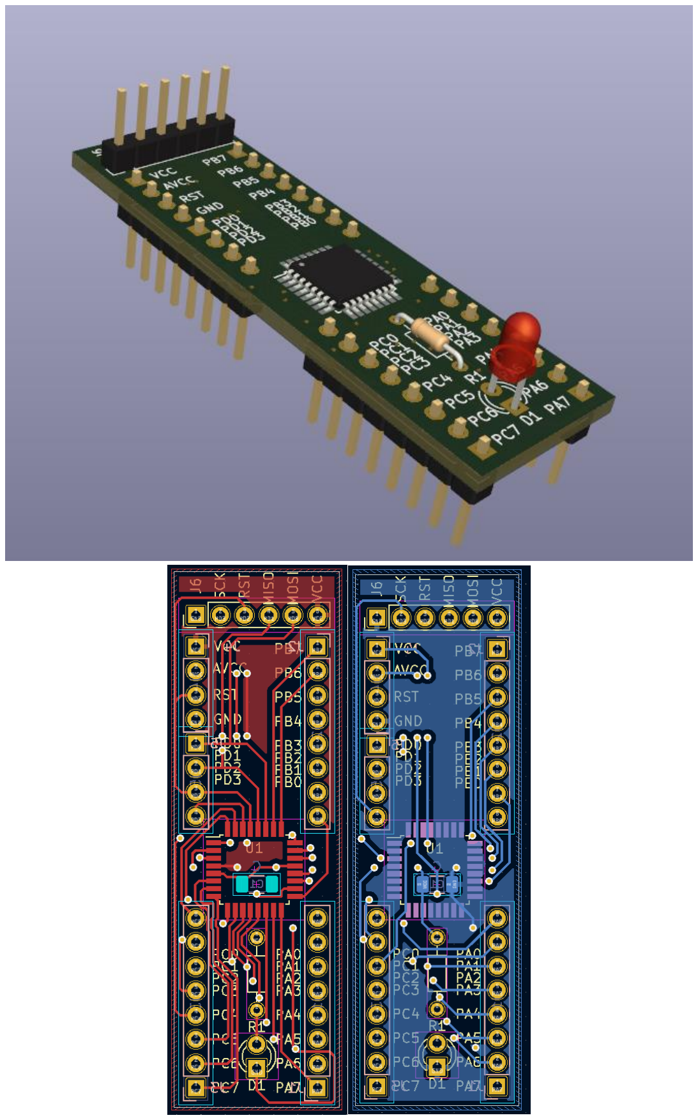
[picture p40: figure]

18

## Pcb:

19

# Code

## Main.c

/*
* Created: 25/10/2022 11:19:27 * Author : William VR
*/
/*includes*/
#include "main.h"

#include <avr/io.h>

#include <util/delay.h>

#include <avr/interrupt.h> #include <avr/wdt.h>

#include <math.h>

#include "I2C/I2C.h"

#include "TDA/TDA.h"

#include "Display/Display.h" #include "EEPROM/EEPROM.h"

//variables | input values
volatile uint8_t volume = 0x00; uint8_t mux = 0x00;
uint8_t gain = 0x00;
uint8_t bass = 0x00;
uint8_t midRange = 0x00;
uint8_t treble = 0x00;
uint8_t muteLeds = 0x00;

int main(void)
{
//clk
initclk();

//IO
initIO();

//ADC
initADC();

//TIMER1
initTimer1();

//I2C
initI2C();

//DISPLAY
initDisplay();

//ENABLE INTERRUPTS
sei();

//read volume value
volume = EEPROM_read(0x00);

//unmute TDA IC
setTDAValue(CHIP_ADDRESS, SubAdr_Speaker_attenuation_L, 0x00); setTDAValue(CHIP_ADDRESS, SubAdr_Speaker_attenuation_R, 0x00);

20

setTDAValue(CHIP_ADDRESS, SubAdr_Volume, 0x00);

loadingScreen();

while (1)
{
//read inputs
gain = ReadADCPinValue(0b00001000); | //PB0
bass = ReadADCPinValue(0b00001011); | //PB3
midRange = ReadADCPinValue(0b00001100); | //PB4
treble = 255 - ReadADCPinValue(0b00001101); | //PB5

//mux PC2 PC3 PC4 PC5
mux = 0;
if (PINC & (1 << PINC3)) mux = 1; if (PINC & (1 << PINC4)) mux = 2; if (PINC & (1 << PINC5)) mux = 3;

//TDA update
setTDAValue(CHIP_ADDRESS, SubAdr_Input_selector, mux); setTDAValue(CHIP_ADDRESS, SubAdr_Input_gain, ((gain >> 4) & 0b00001111)); setTDAValue(CHIP_ADDRESS, SubAdr_Volume, convert6bits((255 - volume))); setTDAValue(CHIP_ADDRESS, SubAdr_Bass_gain, convert4bits(bass)); setTDAValue(CHIP_ADDRESS, SubAdr_Mid_range_gain, convert4bits(midRange)); setTDAValue(CHIP_ADDRESS, SubAdr_Treble_gain, convert4bits(treble));

//Display update -> parallel
updateDisplay(volume, mux);

//write to EEPROM
EEPROM_write(0x00, volume); }
}

//----------------------------------------------------------------------------------------- IO void initIO(){
//PORT A
DDRA = 0xff; | //output
PUEA = 0xff; | //Set pull ups
PORTA = 0x00; | //write zero
//PORT B
DDRB = 0b11000000; | //output
PUEB = 0xff; | //Set pull ups
PORTB = 0b00000000; | //write zero
//PORT C
DDRC = 0b11000000; | //output
PUEC = 0xff; | //Set pull ups
PORTC = 0b00000000; | //write zero
}

//----------------------------------------------------------------------------------------- ADC
void initADC(){
PRR | &= 0b11111110; | //turn power saving off
ADCSRA |= 0b10000000; | //turn ADEN on
ADMUXB &= 0b00000000; | //Voltage reference VCC
ADCSRA |= 0b00000100; | //set Scaler 0100 => /16
ADCSRB |= 0b00001000; | //left adjusted
}

uint8_t ReadADCPinValue(uint8_t ADCReadPin){
ADMUXA = ADCReadPin;

21

// Start ADC conversion
ADCSRA |= (1 << ADSC);

// Wait for ADC conversion to complete while (ADCSRA & (1 << ADSC));

// Return ADC result
return ADCH;
}

//----------------------------------------------------------------------------------------- Timer1
void initTimer1(void){
PRR | &= 0b11110111; | //power saving off
TCCR1B |= (1 << WGM12 ); | // Configure timer 1 for CTC mode
OCR1A = 0;
TIMSK1 |= (1 << OCIE1A ); | // Enable CTC interrupt
TCCR1B |= (1 << CS11 ) | (1 << CS10 ); | // prescaler of 64
//TCCR1B |= (1 << CS00 ); | // no prescaling
}

//----------------------------------------------------------------------------------------- MISC
// src: https://stackoverflow.com/questions/2602823/in-c-c-whats-the-simplest-way-to-reverse-the-order-of-bits-in-a-byteuint8_t reverse(uint8_t b) {
b = (b & 0xF0) >> 4 | (b & 0x0F) << 4;
b = (b & 0xCC) >> 2 | (b & 0x33) << 2;
b = (b & 0xAA) >> 1 | (b & 0x55) << 1;
return b;
}

void initclk(void){
//Set prescaler to 1;
CCP = 0xD8;
CLKPR = 0x00;
}

//----------------------------------------------------------------------------------------- ISR ISR(TIMER1_COMPA_vect, ISR_BLOCK){
static uint8_t volumeSwitchState = 0x00;

/*
0x00 | READ
0x01 | IDLE | */

//rotary encoder
switch (volumeSwitchState)
{
case 0x00:
if(PINB & (1<<PINB2)){ | // clk = 0?
if(PINB & (1<<PINB1)){ | // data = 0
if(volume >= 5){
volume -= 5;
}
volumeSwitchState = 0x01;
}
else{ | // data = 1
if(volume <= 250){
volume += 5;
}

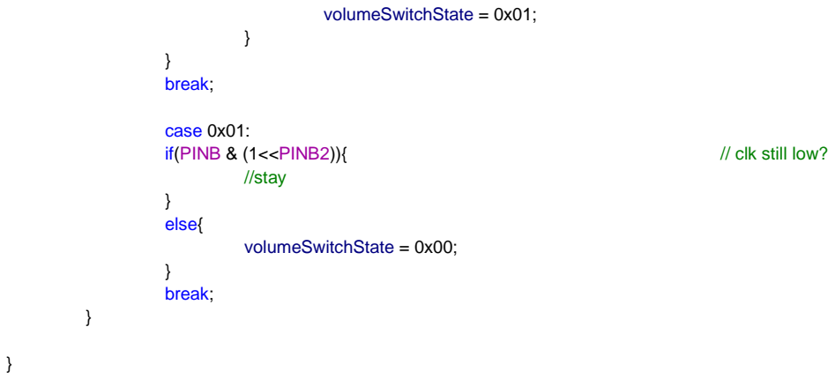
[picture p41: figure]
volumeSwitchState = 0x01;; } break;; case 0x01:; //stay; } else{; volumeSwitchState = 0x00;

22

if(PINB & (1<<PINB2)){ | // clk still low?

23

## Main.h

/*
* Main.h
* Created: 03/03/2023 12:22:17 * Author: William VR
*/

#ifndef MAIN_H_

#define MAIN_H_

/*defines*/
#define F_CPU 8000000UL

#define CHIP_ADDRESS 0x88

#include <avr/io.h>

#include <util/delay.h>

/*functions*/

//MISC
void initIO();
void initclk(void);
uint8_t reverse(uint8_t);

//ADC
void initADC();
uint8_t ReadADCPinValue(uint8_t);

//TIMER0
void initTimer1(void);

#endif /* MAIN_H_ */

24

## Display.c

/*
* Display.c
*
* Created: 03/03/2023 12:40:01
* Author: William VR
* | https://www.farnell.com/datasheets/50586.pdf
* | pg 48
*
* pin 4 RS | - | PINC6
* 0 instruction register
* 1 data register
*
* pin 5 always 0
* 0 writing
*
* pin 6 enable | - | PINC7
* X/0 enable writing
* X/1 enable reading
*/

#include "../main.h"

#include "Display.h"

#include <string.h>

#include <stdio.h>

//vars
char inpStrText[] = "INPUT: | ";
char volStrText[] = "VOLUME:";
char loadingStrText[] = " | Loading | ";
char emptyStrText[] = " | ";
char fullbarStrText[] = "YYYYYYYYYYYYYYYYYYY_";

char* muxTable[4] = {
" [X] [_] [_] [_] ",
" [_] [X] [_] [_] ",
" [_] [_] [X] [_] ",
" [_] [_] [_] [X] "
};

char barStr[20];
char* muxStr;

uint8_t bars = 0x00;
uint8_t blanks = 0x00;
uint8_t first = 0x00;

void initDisplay(void){
//init
setRS();
setEnable();
PORTA = 0x00;
//power on delay
_delay_ms(500);

clearEnable();
clearRS();
_delay_ms(500);

25

//send function set 3 times
sendByteByNibble(FUNCTION_SET); | //Function set
_delay_ms(15); | //>4.1
sendByteByNibble(FUNCTION_SET); | //Function set
_delay_ms(5); | //>1.67ms
sendByteByNibble(FUNCTION_SET); | //Function set
_delay_ms(2); | //>1.67ms
sendByteByNibble(FUNCTION_SET_4BIT); | //Function set | - 4bit mode
_delay_ms(2); | //>1.67ms
sendByteByNibble(CURSOR_ON_BLINK); | // display on, cursor on, blink on
_delay_ms(2); | //>1.67ms
sendByteByNibble(ENTRY_MODE); | // ready to write
_delay_ms(2); | //>1.67ms

sendByteByNibble(RETURN_HOME); // return home _delay_ms(2); //>1.67ms

clearLCD();
}

void updateDisplay(uint8_t displayValueF, uint8_t mux){
//1 VOLUME: | address: 0x80
//2 ??????_______________ address: 0xc0
//3 INPUT: | address: 0x94
//4 [] [] [?] [] | address: 0xd4

// volume string
bars = displayValueF / 12; // 0 - 255 => 0 - 20 => / 12.75 ~ 12 blanks = 20 - bars;

//assemble string
strcpy(barStr, "");
for(uint8_t i = 0; i < bars; i++){ strcat(barStr, "Y");
}
for(uint8_t i = 0; i < blanks; i++){ strcat(barStr, "_");
}

//mux string
muxStr = muxTable[mux];

cursorHome();

writeToDisplay(volStrText, strlen(volStrText), 0x80);

// write entire bar on reset
if(first == 0x00){
writeToDisplay(fullbarStrText, strlen(fullbarStrText), 0xc0); first = 0x01;
}
else{
writeToDisplay(barStr, strlen(barStr), 0xc0); }

writeToDisplay(inpStrText, strlen(inpStrText), 0x94); writeToDisplay(muxStr, strlen(muxStr), 0xd4);
}

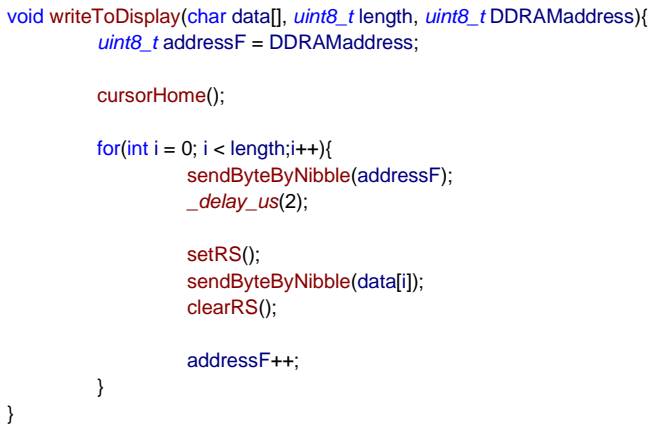
[picture p42: figure]
uint8_t addressF = DDRAMaddress;; cursorHome();; for(int i = 0; i < length;i++){ sendByteByNibble(addressF); _delay_us(2);; setRS(); sendByteByNibble(data[i]); clearRS();; addressF++;
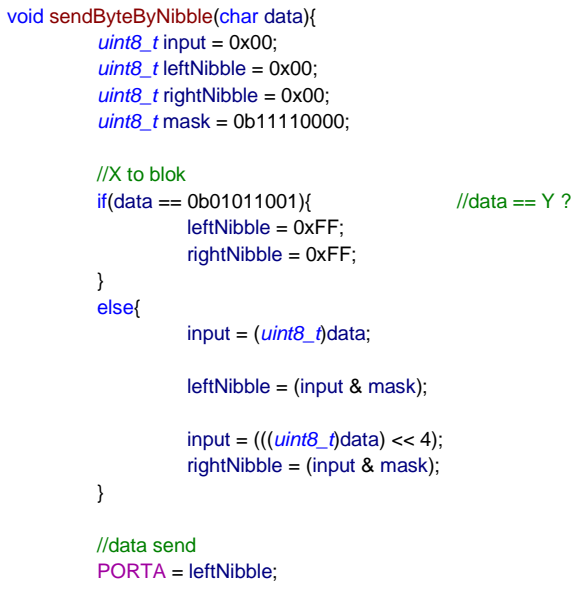
[picture p43: figure]
void sendByteByNibble(char data){ uint8_t input = 0x00; uint8_t leftNibble = 0x00; uint8_t rightNibble = 0x00; uint8_t mask = 0b11110000;; //X to blok; if(data == 0b01011001){; //data == Y ?; leftNibble = 0xFF; rightNibble = 0xFF;; } else{; input = (uint8_t)data;; leftNibble = (input & mask);; input = (((uint8_t)data) << 4); rightNibble = (input & mask);; //data send PORTA = leftNibble;

26

void writeToDisplay(char data[], uint8_t length, uint8_t DDRAMaddress){

void loadingScreen(void){
sendByteByNibble(CURSOR_ON_BLINK); | // display on, cursor on, blink on
_delay_ms(2); | //>1.67ms
sendByteByNibble(ENTRY_MODE); | // ready to write
_delay_ms(2); | //>1.67ms

clearLCD();
cursorHome();

writeToDisplay(emptyStrText, strlen(emptyStrText), 0x80); writeToDisplay(loadingStrText, strlen(loadingStrText), 0xc0);

for(uint8_t i = 0; i < 20; i++){
strcat(barStr, "Y");
writeToDisplay(barStr, strlen(barStr), 0x94); }

clearLCD();
cursorHome();
}

27

//pulse
setEnable();
_delay_us(50);
clearEnable();
_delay_us(50);

//data send
PORTA = rightNibble;

//pulse
setEnable();
_delay_us(50);
clearEnable();
_delay_us(50);

//default position
clearEnable();
clearRS();
PORTA = 0x00;
}

void clearLCD(void){
sendByteByNibble(CLEAR_DISPLAY); // clear display _delay_ms(2); //>1.67ms
}

void cursorHome(void){
sendByteByNibble(RETURN_HOME); // return home _delay_ms(2); //>1.67ms
}

void setRS(void){
PORTC |= 0b01000000;
}

void clearRS(void){
PORTC &= 0b10111111;
}

void setEnable(void){
PORTC |= 0b10000000;
}

void clearEnable(void){
PORTC &= 0b01111111;
}

28

## Display.h

/*
* display.h
* Created: 03/03/2023 12:40:13 * Author: William VR
*/
#ifndef DISPLAY_H_

#define DISPLAY_H_

//port A DATA pins
//port C
//PA8 pin - 4 PC6 | RS
//PA9 pin -6 PC7 ENABLE
/*
1. Display clear
2. Function set:
DL = 1; 8-bit interface data N = 0; 1-line display
F = 0; 5x8 dot character font
3. Display on/off control:
D = 0; Display off
C = 0; Cursor off
B = 0; Blinking off
4. Entry mode set:
I/D = 1; Increment by 1
S = 0; No shift
*/
#define FUNCTION_SET | 0b00110000

#define FUNCTION_SET_4BIT | 0b00100000

#define CURSOR_ON_BLINK | 0b00001100

#define DISPLAY_ON | 0b00000001

#define ENTRY_MODE | 0b00000110

#define RETURN_HOME | 0b00000010

#define CLEAR_DISPLAY | 0b00000001

#define SET_DDRAM_ADDRESS0b10000000

void initDisplay(void);
void updateDisplay(uint8_t, uint8_t);
void writeToDisplay(char[], uint8_t, uint8_t); // data; length, DDRAM address void loadingScreen(void);
void clearLCD(void);
void cursorHome(void);
void sendByteByNibble(char); void setRS(void);
void clearRS(void);
void setEnable(void);
void clearEnable(void);
#endif /* DISPLAY_H_ */

29

## EEPROM.c

/*
* EEPROM.c
*
* Created: 17/04/2023 11:12:38 * Author: William VR
*/

#include "../main.h"

#include "EEPROM.h"

#include <avr/interrupt.h>

void EEPROM_write(uint8_t ucAddress, uint8_t ucData) {
cli();
/* Wait for completion of previous write */ while(EECR & (1<<EEPE));
/* Set Programming mode */
EECR = (0<<EEPM1)|(0<<EEPM0); /* Set up address and data registers */ EEAR = ucAddress;
EEDR = ucData;
/* Write logical one to EEMPE */
EECR |= (1<<EEMPE);
/* Start eeprom write by setting EEPE */ EECR |= (1<<EEPE);
sei();
}

uint8_t EEPROM_read(uint8_t ucAddress)
{
cli();
/* Wait for completion of previous write */ while(EECR & (1<<EEPE));
/* Set up address register */
EEAR = ucAddress;
/* Start eeprom read by writing EERE */ EECR |= (1<<EERE);
/* Return data from data register */ sei();
return EEDR;
}

30

## EEPROM.h

/*
* EEPROM.h
* Created: 17/04/2023 11:12:51 * Author: William VR
*/
#ifndef EEPROM_H_

#define EEPROM_H_

void EEPROM_write(uint8_t ucAddress, uint8_t ucData); uint8_t EEPROM_read(uint8_t ucAddress);

#endif /* EEPROM_H_ */

## I2C.c

/*
* I2C.c
*
* Created: 03/03/2023 12:39:19 * Author: William VR
*/

#include "../main.h"

#include "I2C.h"

void initI2C(){
sdaHigh();
clkHigh();
_delay_us(I2CSpeed);
}

void setTDAValue(uint8_t chipAddress, uint8_t subAddress, uint8_t data){ startCom();
sendI2C(chipAddress);
sendI2C(subAddress);
sendI2C(data);
finishCom();
}

void sendI2C(uint8_t input){
uint8_t shift = 0x00;
uint8_t mask = 0b00000001; uint8_t result = 0x00;

//send input
shift = reverse(input);
for(uint8_t index = 0; index < 8; index++){ result = shift & mask;
if(result == 0x01){

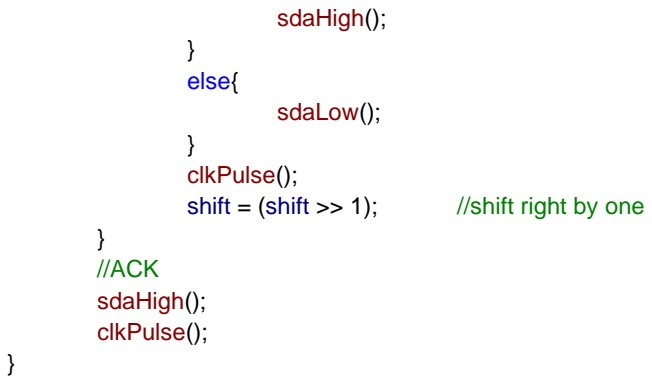
[picture p44: figure]
sdaHigh();; } else{; sdaLow();; } clkPulse();; } //ACK sdaHigh(); clkPulse();

31

shift = (shift >> 1); | //shift right by one

void startCom(void){
//start condition
sdaLow();
_delay_us(I2CSpeed);
clkLow();
_delay_us(I2CSpeed);
}

void finishCom(){
// finish communication
clkHigh();
_delay_us(I2CSpeed);
sdaHigh();
_delay_us(I2CSpeed);
}

void clkPulse(void){
clkHigh();
_delay_us(I2CSpeed);
clkLow();
_delay_us(I2CSpeed);
}

void clkLow(void){
PORTB &= 0b01111111;
}

void clkHigh(void){
PORTB |= 0b10000000;
}

void sdaLow(void){
PORTB &= 0b10111111;
}

void sdaHigh(void){
PORTB |= 0b01000000;
}

32

## I2C.h

/*
* I2C.h
* Created: 09/01/2023 15:32:19 * Author: William VR
*/

#ifndef I2C_H_

#define I2C_H_

#define I2CSpeed 52 //BAUDRATE = 9600

/*function declaration*/
void | initI2C();
void | setTDAValue(uint8_t, uint8_t, uint8_t); //chip address, sub address, data
void | sendI2C(uint8_t);

void startCom(void);
void | finishCom(void);
void | clkLow(void);
void | clkHigh(void);
void | sdaLow(void);
void | sdaHigh(void);
void | clkPulse(void);

#endif /* I2C_H_ */

33

## TDA.c

/*
* TDA.c
* Created: 03/03/2023 12:39:33 * Author: William VR
*/

#include "../main.h"

#include "TDA.h"

/*
input = 0 -> 255

1111 1111 => XXXX 1111 shift 4 1111 1111 => XX11 1111 shift 6

*/

uint8_t steps[15] = { 0b00000000, 0b00000001, 0b00000010, 0b00000011, 0b00000100, 0b00000101, 0b00000110, 0b00000111, 0b00001110, 0b00001101, 0b00001100, 0b00001011, 0b00001010, 0b00001001, 0b00001000};

uint8_t convert4bits(uint8_t input) {
uint8_t shift = ((input >> 4) & 0b00001111);

return steps[shift] ;
}

uint8_t convert6bits(uint8_t input) {
uint8_t shift = ((input >> 2) & 0x3F);

if(shift > 0b00101000){
shift = 0b00111000; //mute }

return shift;
}

34

## TDA.h

/*
* TDA.h
* | Created: 15/12/2022 16:21:01
* Author: William VR
*/

#ifndef TDA_H_

#define TDA_H_

#define CHIP_ADDRESS 0x88

//Sub-address byte
#define SubAdr_Input_selector | 0x00

#define SubAdr_Input_gain | 0x01

#define SubAdr_Volume | 0x02

#define SubAdr_Bass_gain | 0x03

#define SubAdr_Mid_range_gain | 0x04

#define SubAdr_Treble_gain | 0x05

#define SubAdr_Speaker_attenuation_L 0x06

#define SubAdr_Speaker_attenuation_R 0x07

#define AUTO_INCREMENT | 0b00001000

uint8_t convert4bits(uint8_t);
uint8_t convert6bits(uint8_t);

#endif /* TDA_H_ */

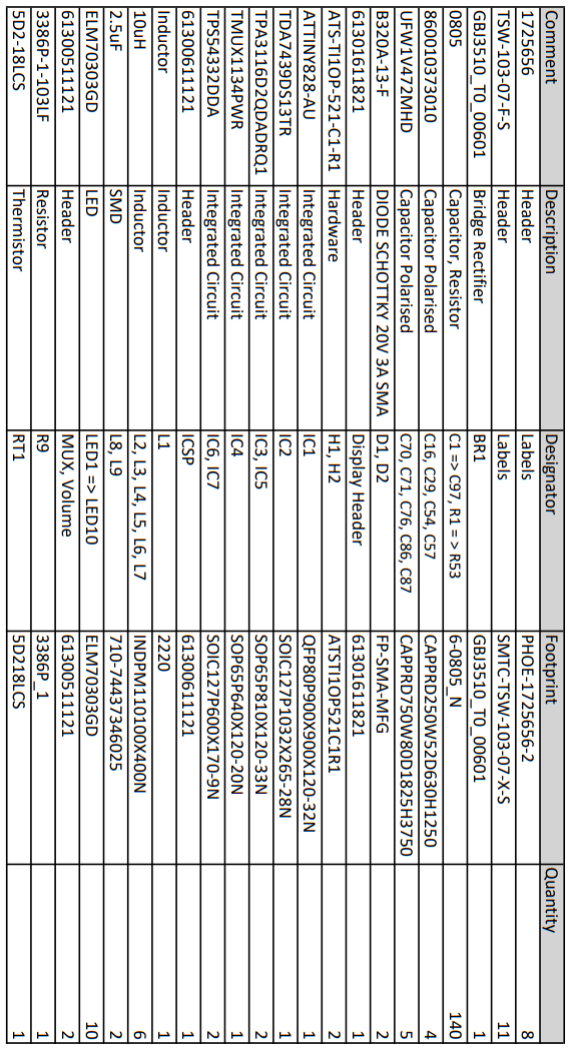
[picture p45: figure]

35

# BOM

Figuur 7: Bom lijst

36

# Bibliografie

Github:
https://github.com/WilliamVanRaemdonck/Project_Practise_Enterprise_2_Ampli fier (https://github.com/WilliamVanRaemdonck/Project_Practise_Enterprise_2_Amplifier)

Datasheets:
ATtiny828:
https://ww1.microchip.com/downloads/en/DeviceDoc/doc8371.pdf

TPA3118d2:
https://www.ti.com/lit/ds/symlink/tpa3118d2-q1.pdf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 (https://www.ti.com/lit/ds/symlink/tpa3118d2-q1.pdf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)

TDA7439DS:
https://www.mouser.be/datasheet/2/389/cd00010668-1796242.pdf

Display:
https://uk.beta-layout.com/download/rk/RK-10290_410.pdf

Spanningsregelaar:
https://www.mouser.be/ProductDetail/595-TPS54332DDA

Code:
Reverse bits in byte:
https://stackoverflow.com/questions/2602823/in-c-c-whats-the-simplest-way-to-reverse-the-order-of-bits-in-a-byte (https://stackoverflow.com/questions/2602823/in-c-c-whats-the-simplest-way-to-reverse-the-order-of-bits-in-a-byte)

Chat.gpt:
Algemene code optimalisatie.


37

# Schema & PCB

Figuur 8: pcb-voorkant
Zone 1: Power Supply.

Zone 2: Microcontroller

Zone 3: Audiocontrole IC.

Zone 4: Audio switch

Zone 5: Mono/Stereo versterker.

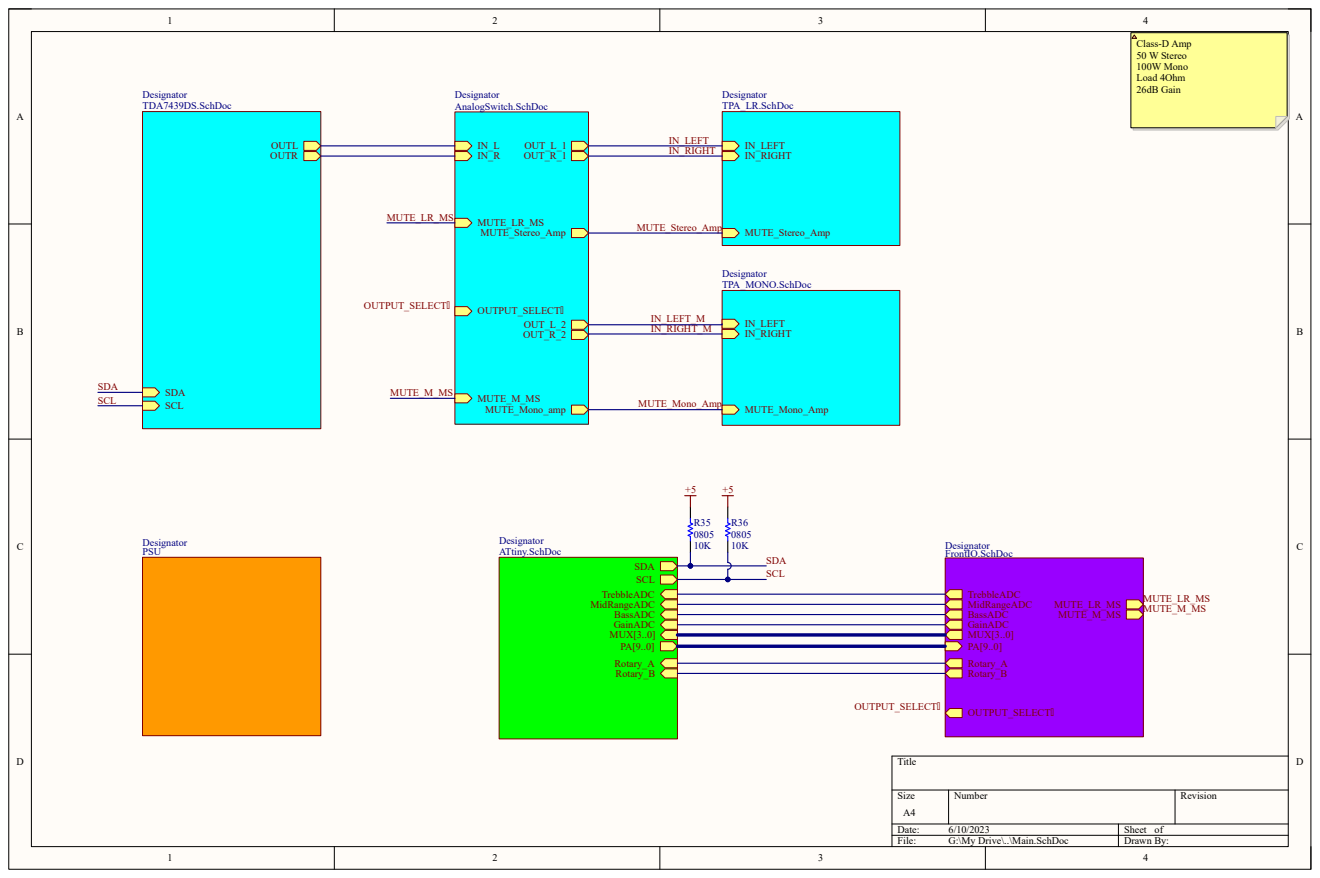
[picture p46: page 38]
Title; Size; Number; Revision; Date:; Sheet of; File:; G:\My Drive\..\Main.SchDoc; Drawn By:; SDA SCL TrebbleADC MidRangeADC BassADC GainADC; Rotary_A Rotary_B; MUX[3..0]; Designator ATtiny.SchDoc; SDA SCL; OUTL OUTR; Designator TDA7439DS.SchDoc; IN_LEFT IN_RIGHT; MUTE_Stereo_Amp; Designator TPA_LR.SchDoc; Designator PSU; MidRangeADC; TrebbleADC; BassADC GainADC; MUTE_LR_MS MUTE_M_MS; OUTPUT_SELECT; Designator FrontIO.SchDoc; MUTE_Mono_Amp; Designator TPA_MONO.SchDoc; OUT_L_1; OUT_L_2; OUT_R_1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

# Microcontroller - ATtiny828

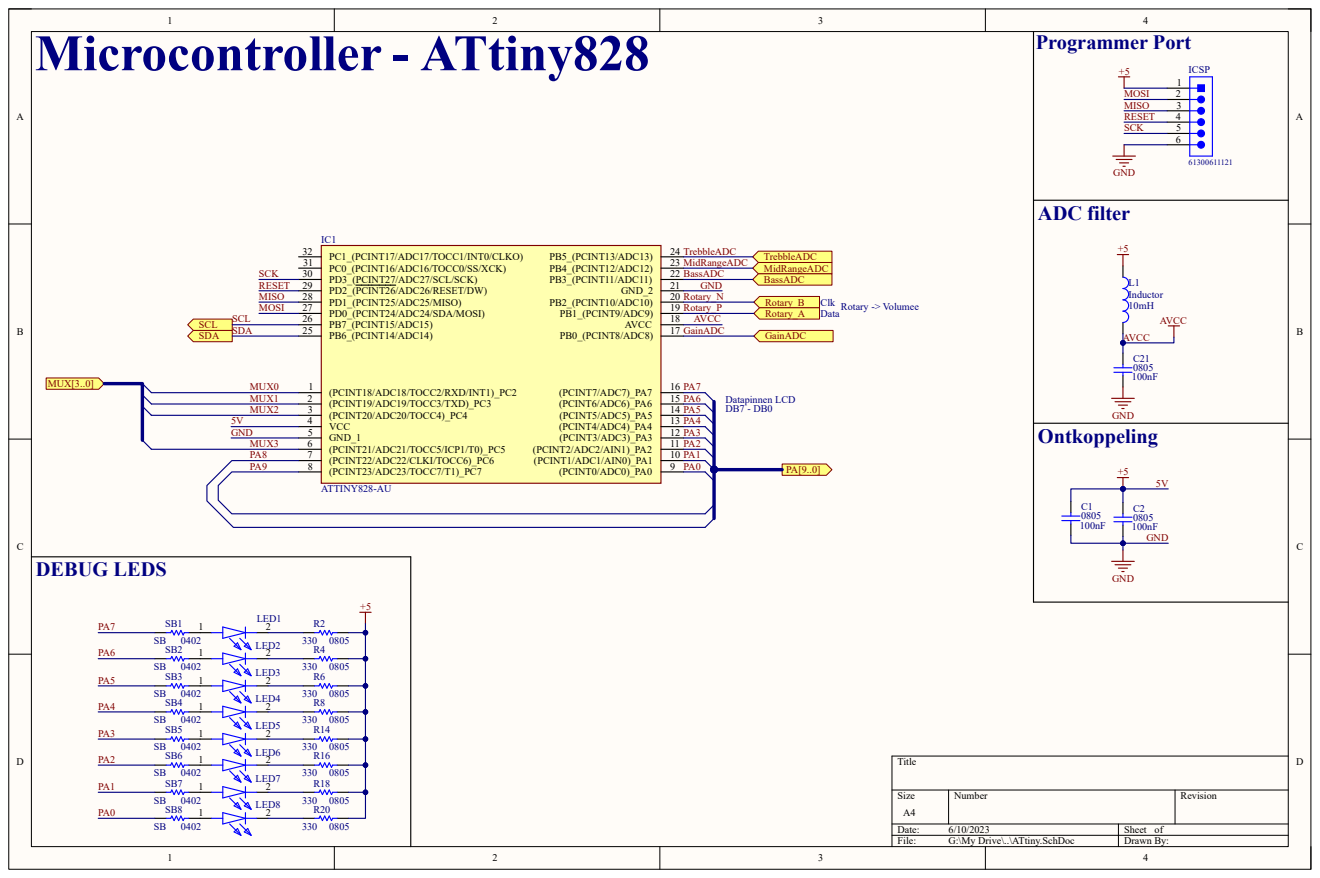
[picture p47: page 39]

Audio controle | Input

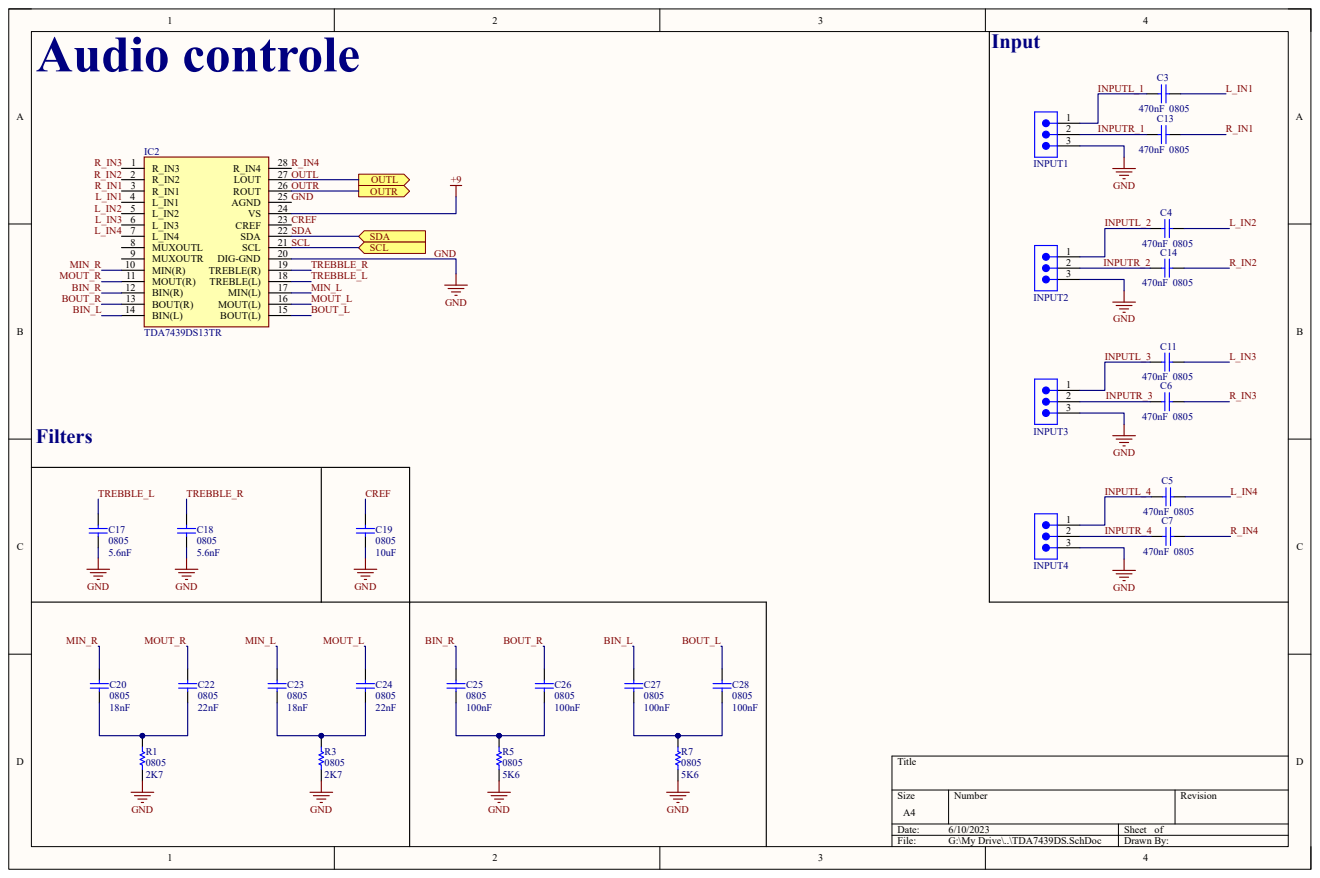
[picture p48: page 40]

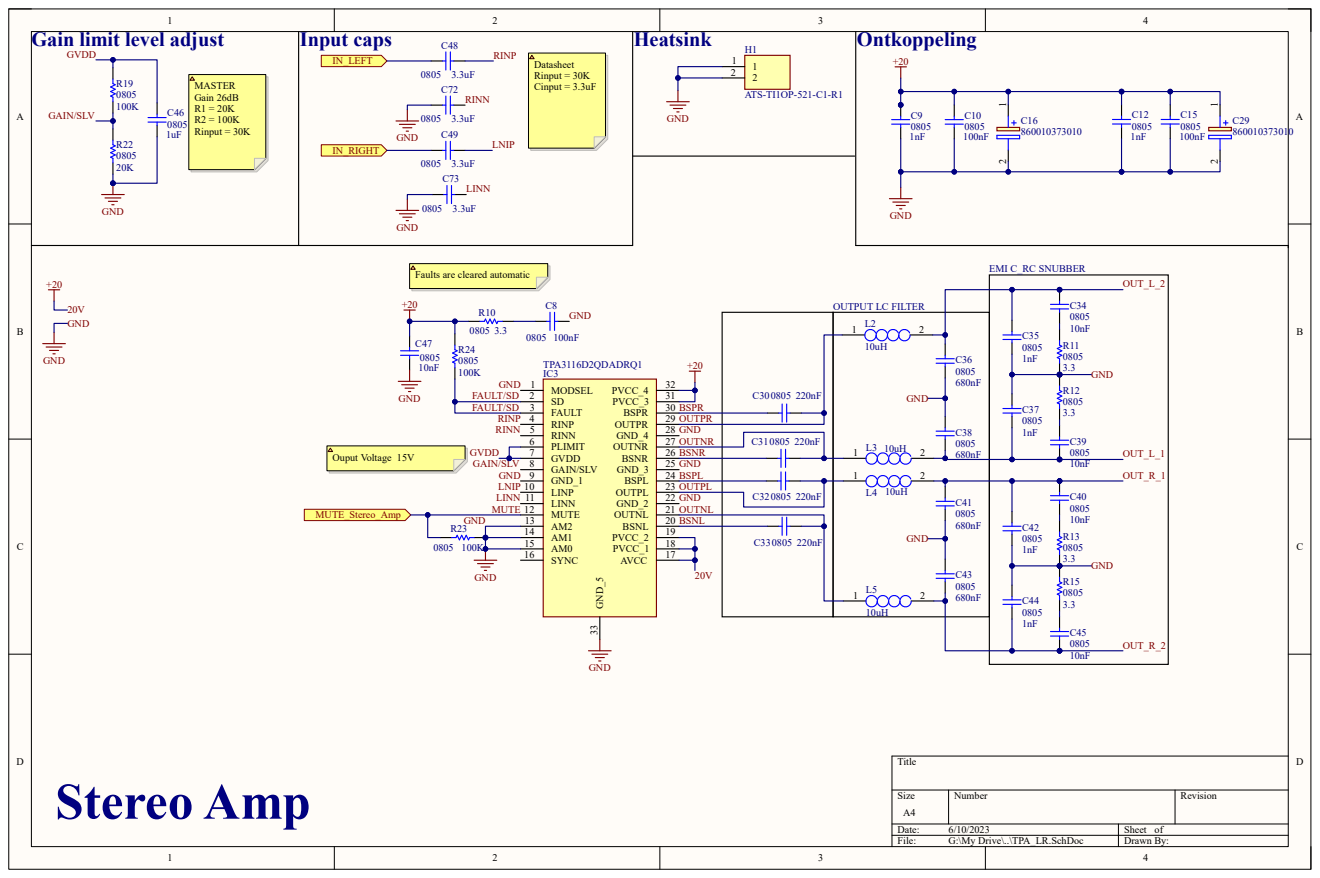
[picture p49: page 41]

Gain limit level adjust

Faults are cleared automatic

C86 ¹ 2

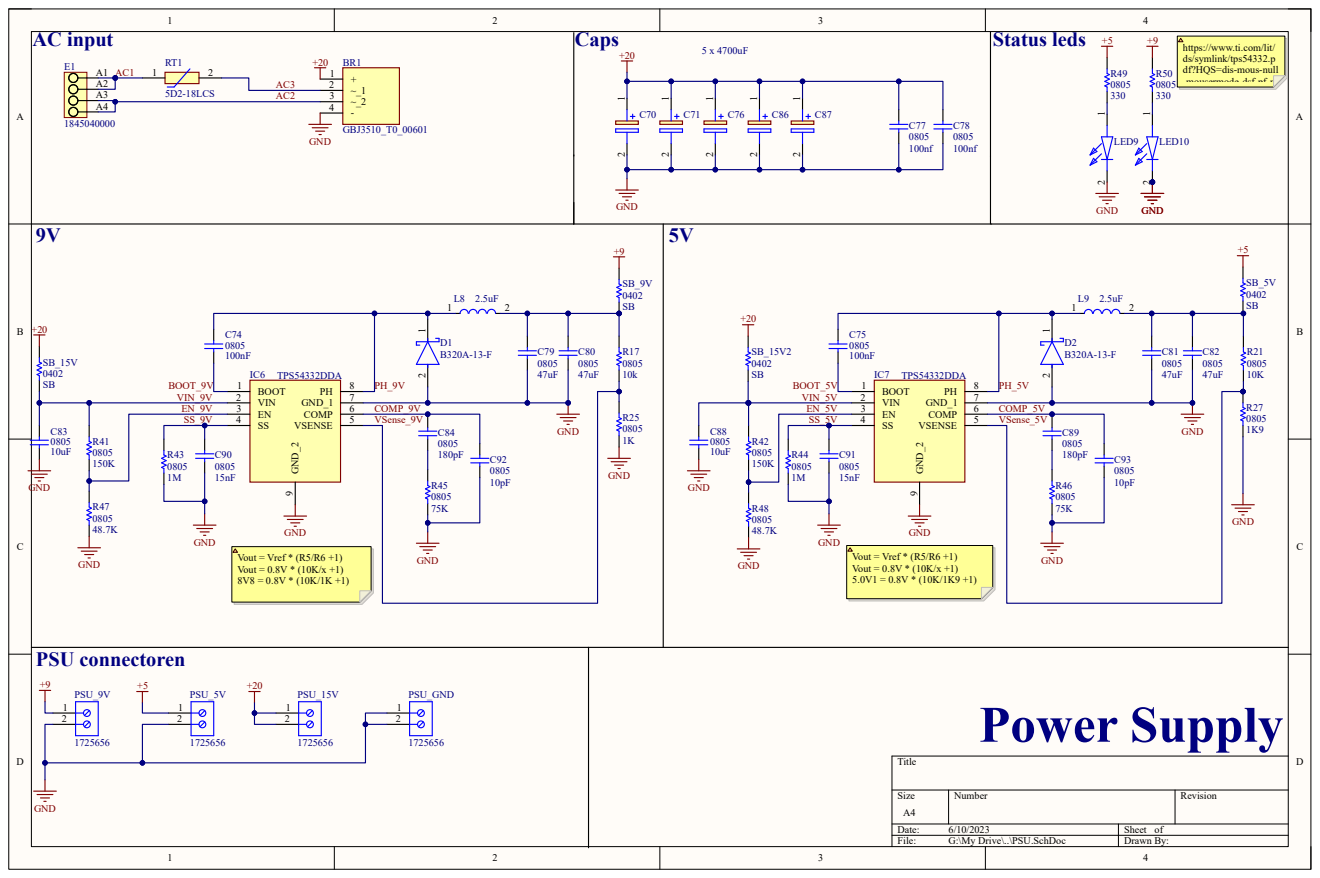
[picture p50: page 42]

https://www.ti.com/lit/
ds/symlink/tps54332.p
df?HQS=dis-mous-null
-mousermode-dsf-pf-n

I/O | POT

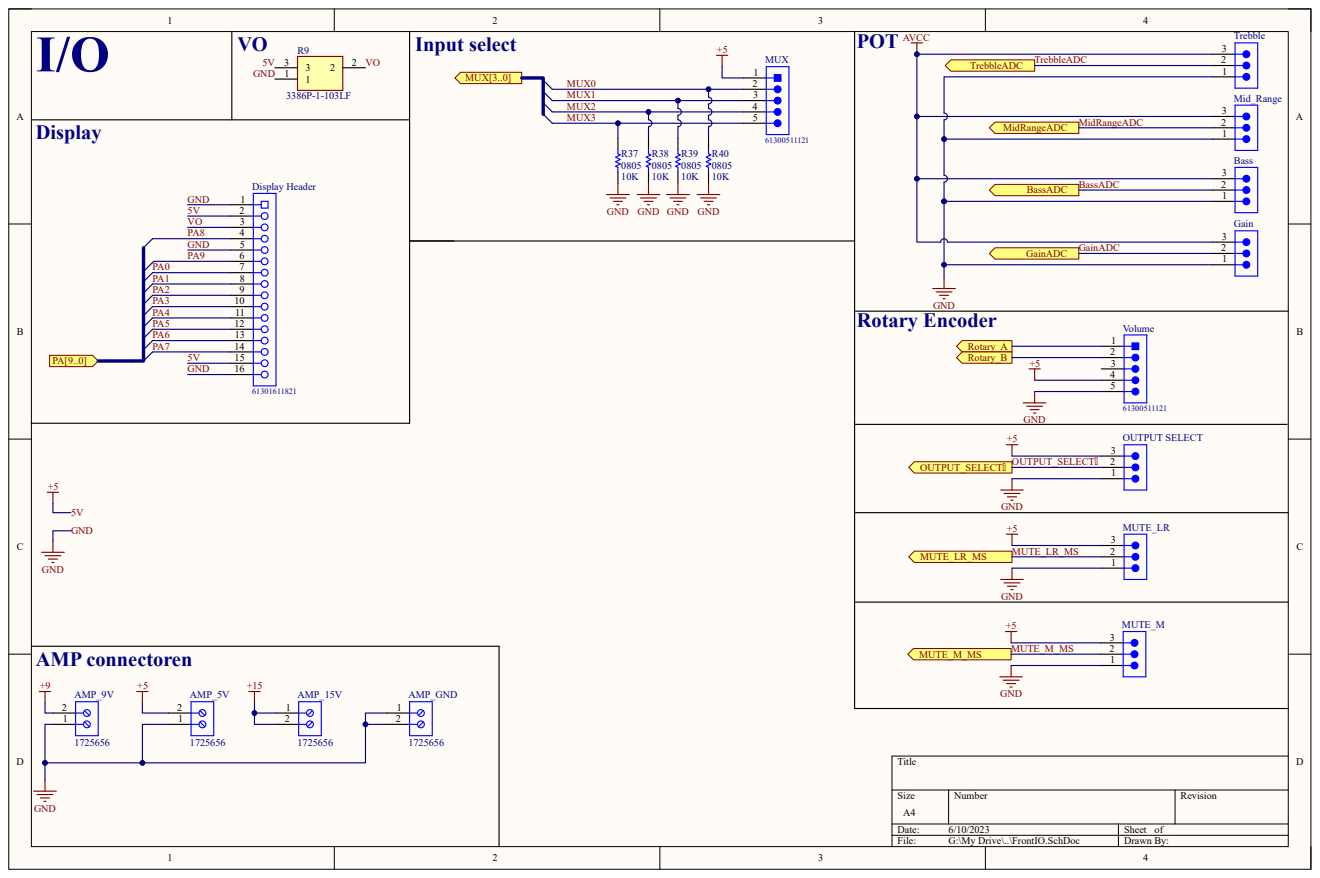
[picture p51: page 43]
Title; Size; Number; Revision; Date:; Sheet of; File:; G:\My Drive\..\FrontIO.SchDoc; Drawn By:; Trebble; Mid_Range; Bass; TrebbleADC; MidRangeADC; BassADC; GainADC GainADC; Gain; Rotary_A Rotary_B PA[9..0]; Volume; MUX[3..0]; Display Header; 5V GND; GND 5V VO; Display; PA8 GND; OUTPUT SELECT; OUTPUT_SELECT; MUTE_LR; MUTE_LR_MS; MUTE_M; MUTE_M_MS; GND; MUX0 MUX1 MUX2 MUX3; MUX; Input select; AMP_5V; AMP_9V; AMP_15V; AMP_GND; AVCC; AMP connectoren; Rotary Encoder

GND GND

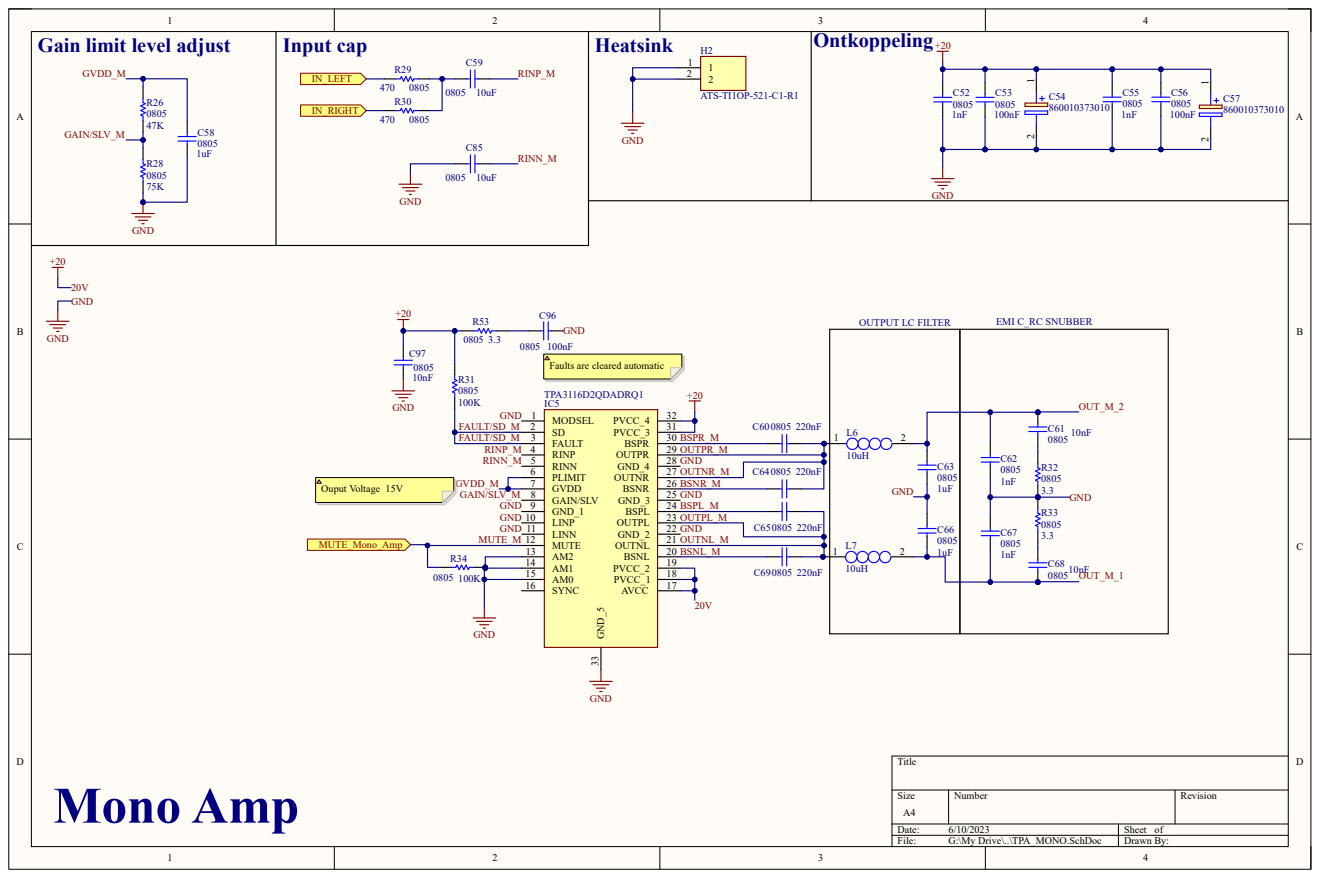
[picture p52: page 44]

Gain limit level adjust

# Audio Switch

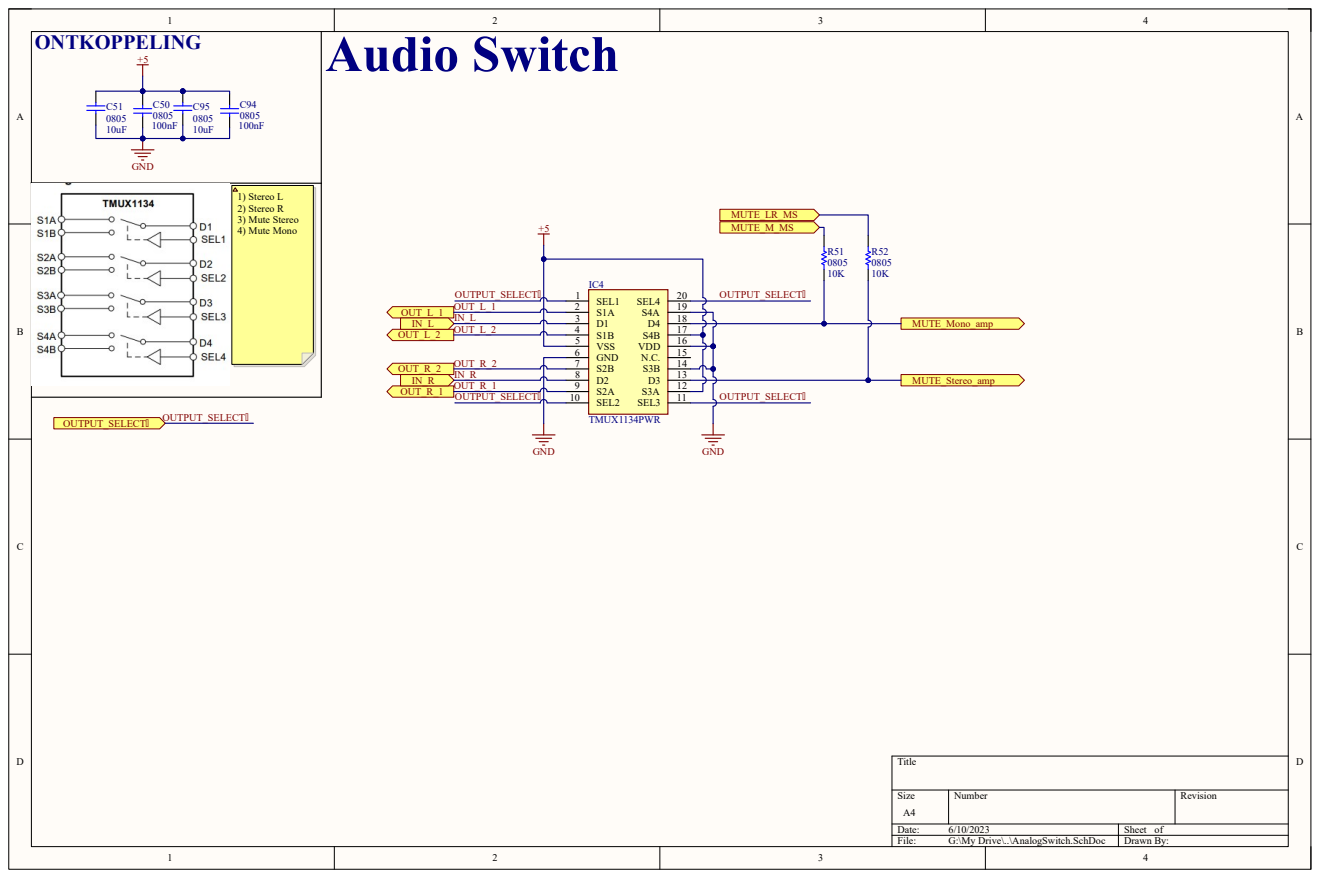
[picture p53: page 45]

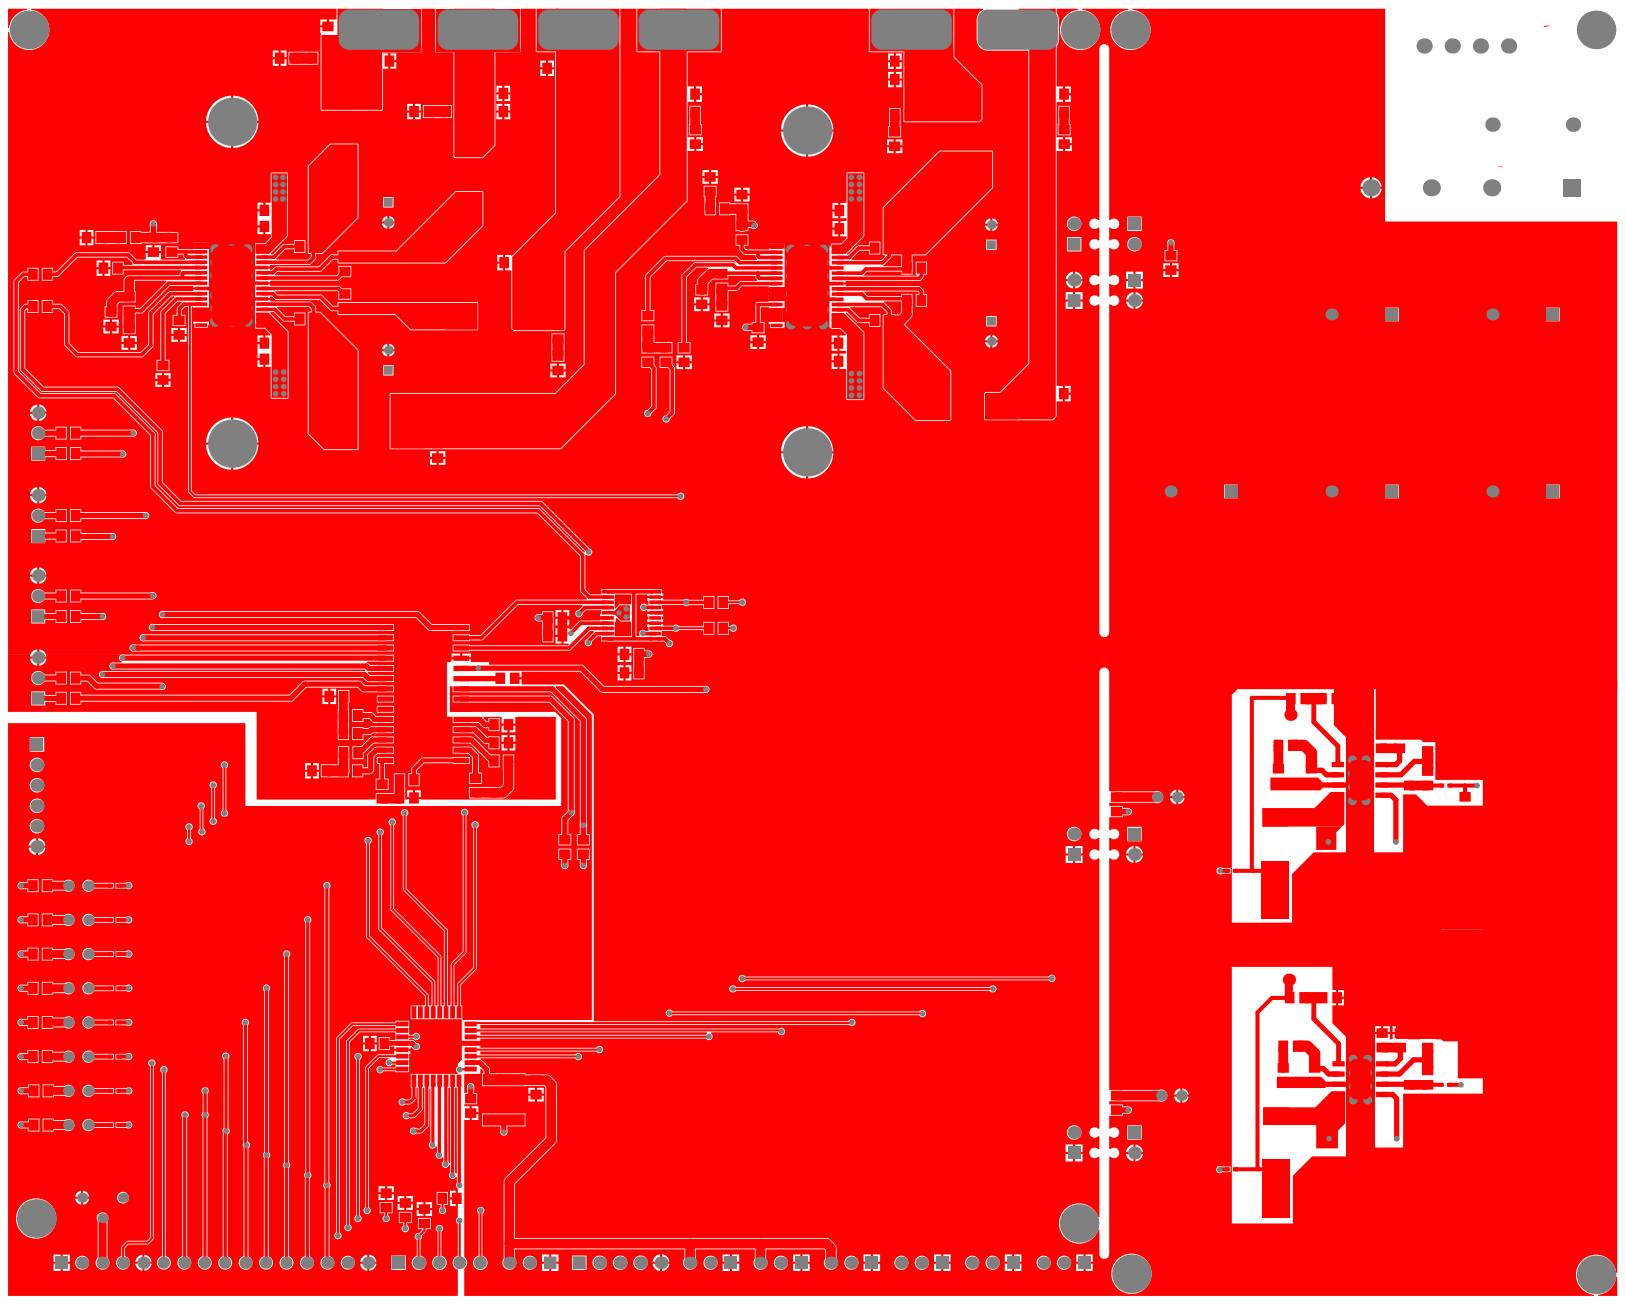
[picture p54: page 46]

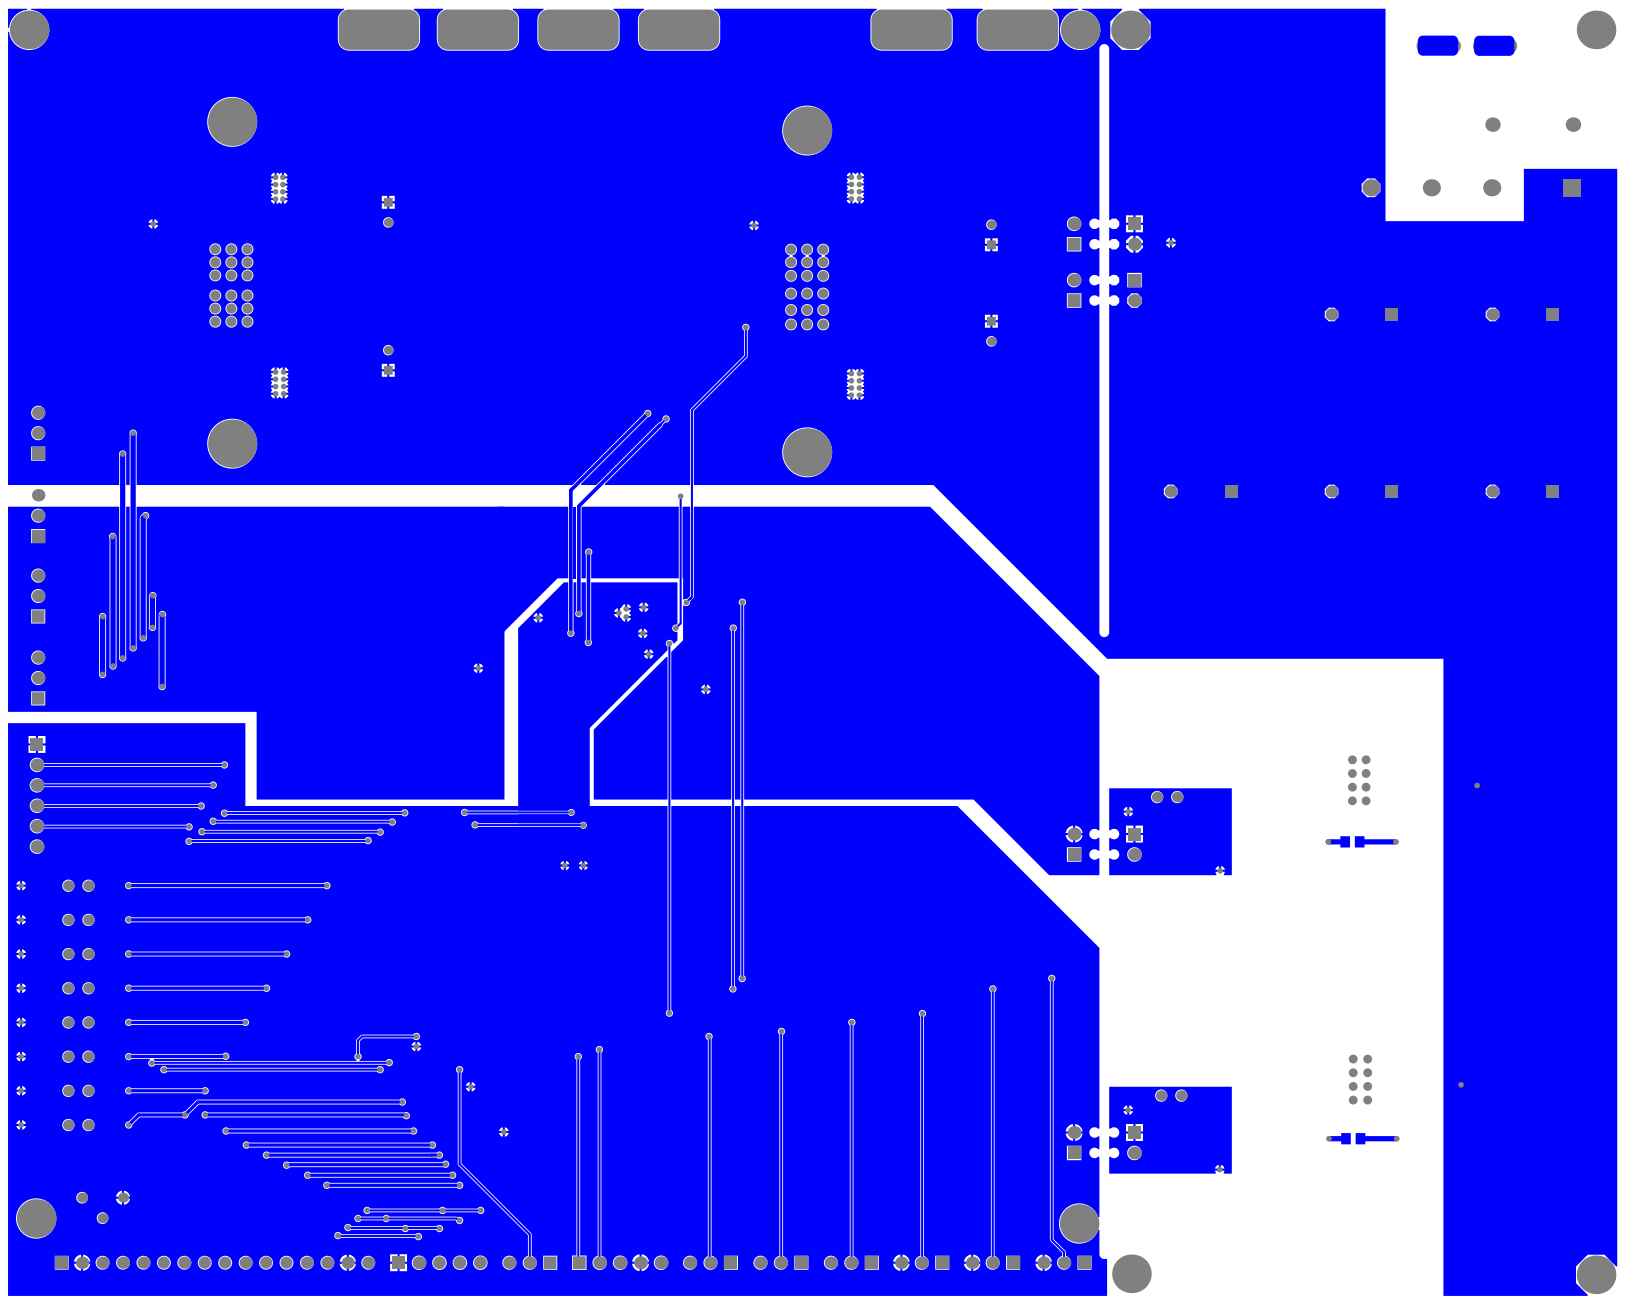
[picture p55: page 47]

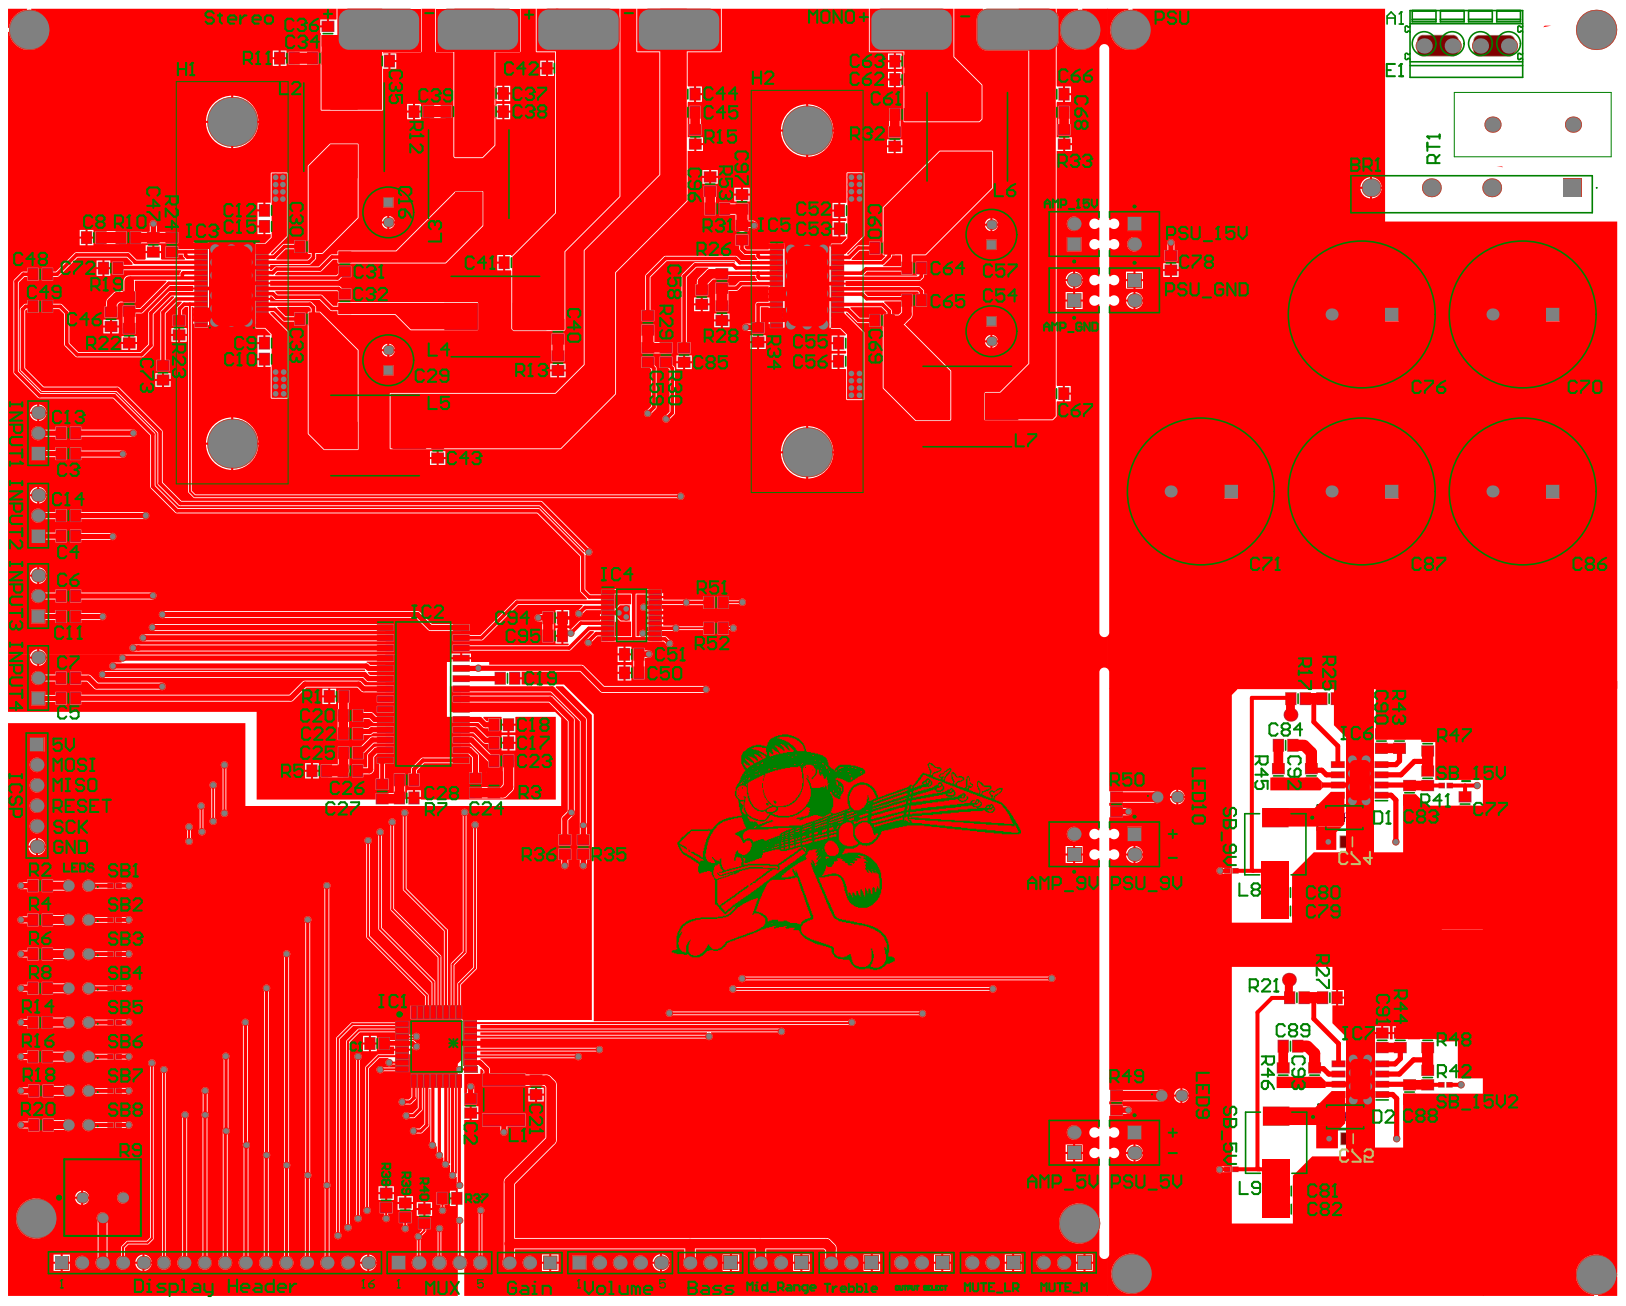
[picture p56: page 48]

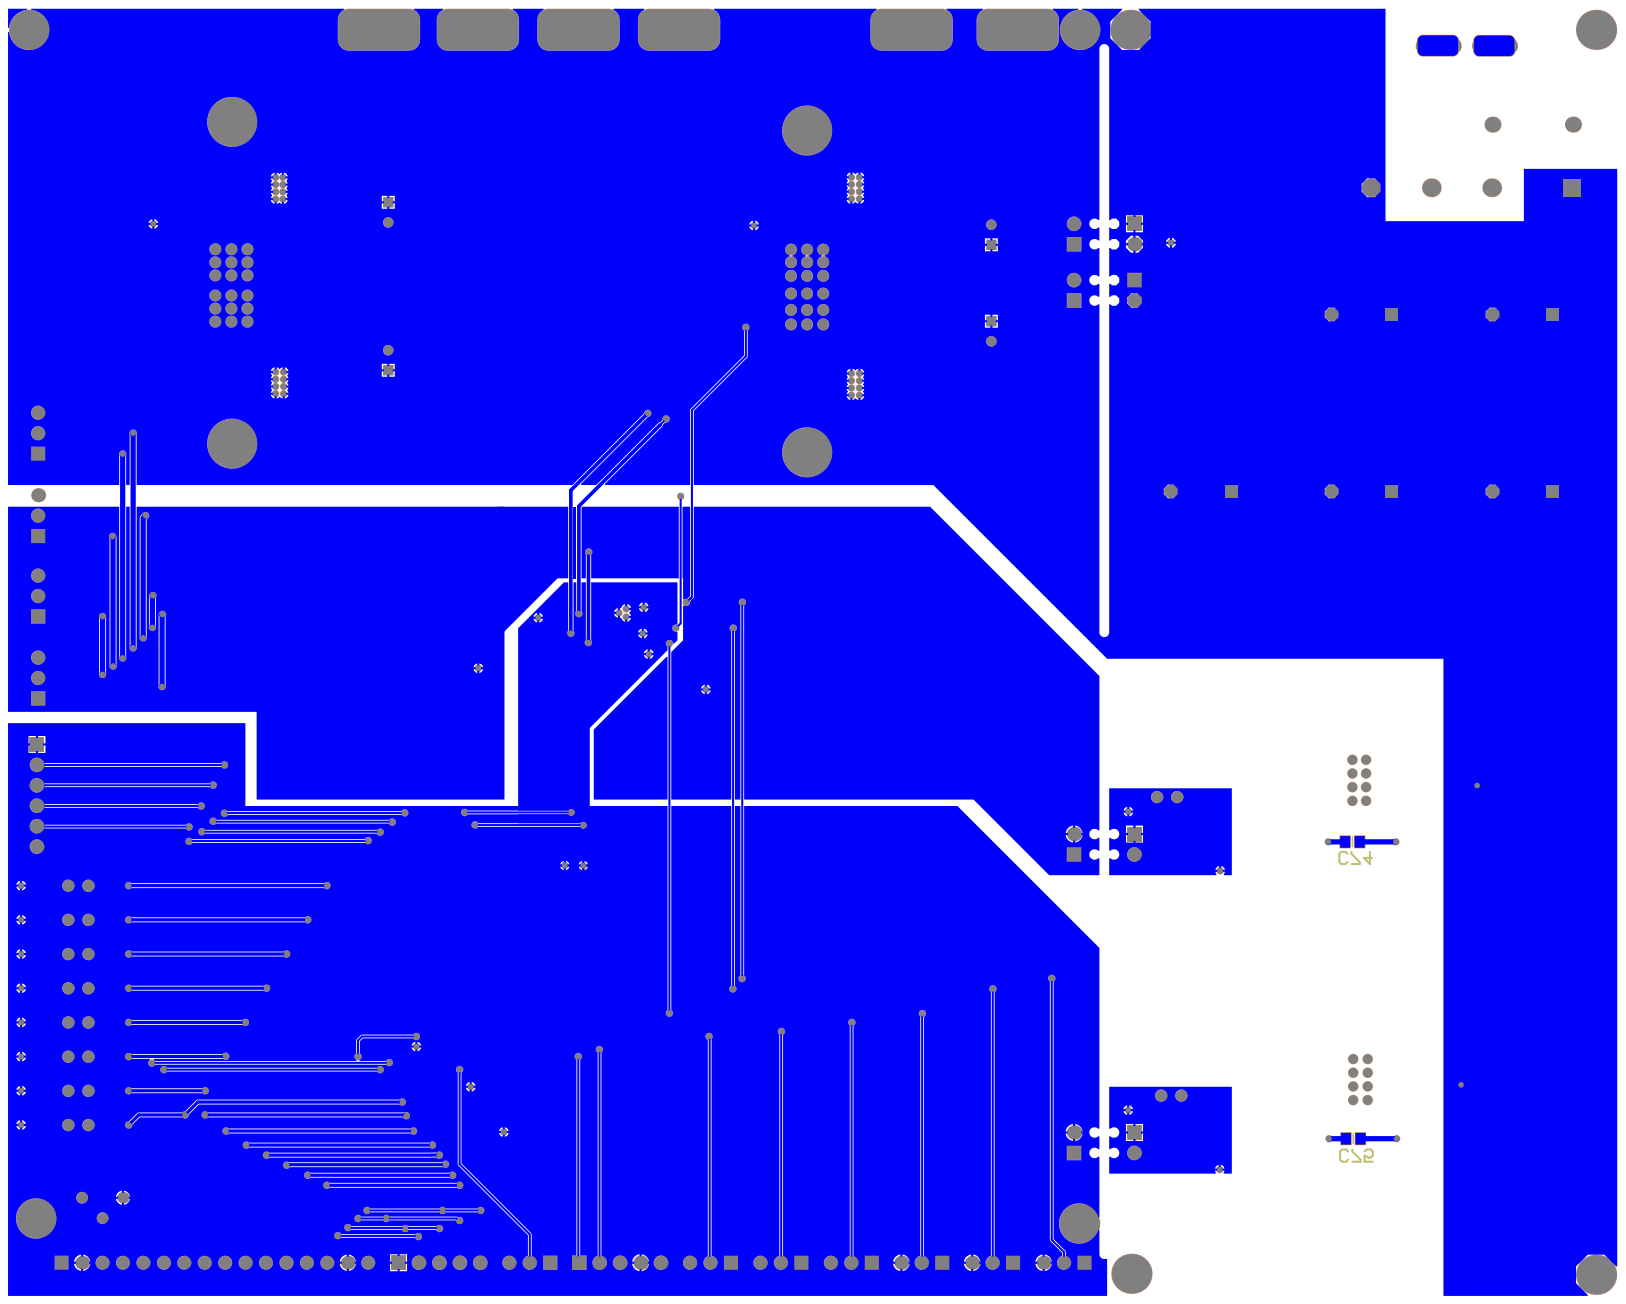
[picture p57: page 49]
