WilliamVanRaemdonck/Project_Practise_Enterprise_2_Amplifier/3. Documents/Programmer/layer1.png

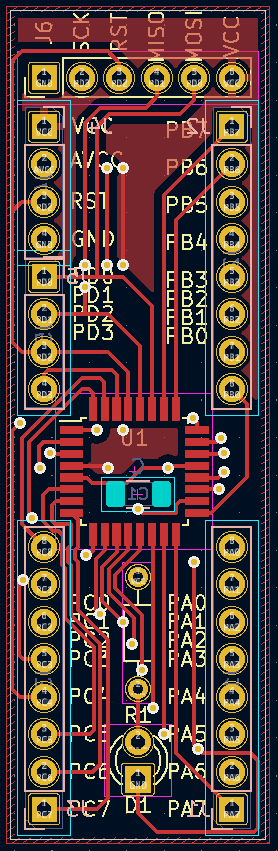
3. Documents/Programmer/layer1.png
