WilliamVanRaemdonck/Project_Practise_Enterprise_2_Amplifier/3. Documents/Programmer/layer2.png

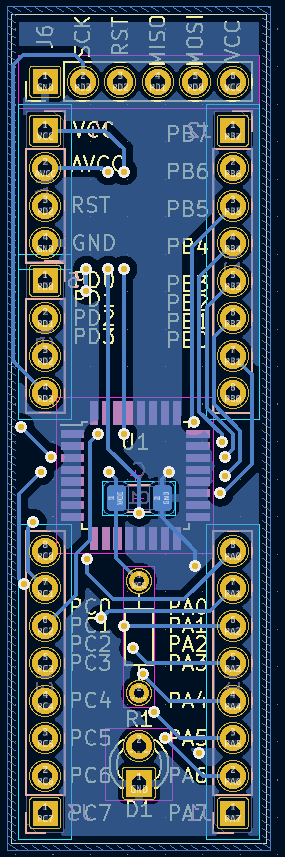
3. Documents/Programmer/layer2.png
