WilliamVanRaemdonck/Project_Practise_Enterprise_2_Amplifier/3. Documents/Programmer/schema.png

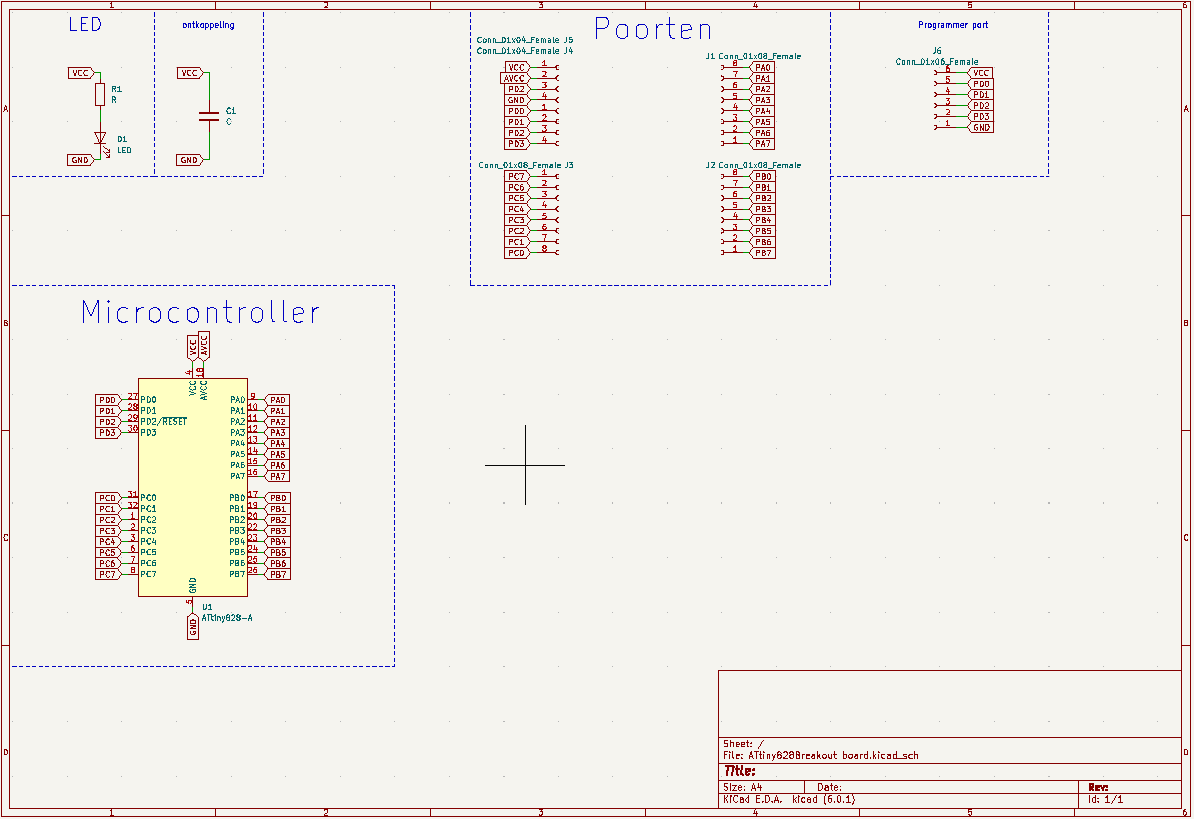
3. Documents/Programmer/schema.png
