WilliamVanRaemdonck/Project_Practise_Enterprise_2_Amplifier/1. Hardware/PPE2/Project Outputs for PPE2/PPE2.xlsx

Comment | Description | Designator | Footprint | LibRef | Quantity
1725656 | Male Header, Pitch 2.54 mm, 1 x 2 Position, Height 9 mm, Tail Length 3.5 mm | AMP_5V, AMP_9V, AMP_15V, AMP_GND, PSU_5V, PSU_9V, PSU_15V, PSU_GND | PHOE-1725656-2 | CMP-2000-05299-1 | 8
TSW-103-07-F-S | 0.025" SQ Post Header, Through-hole, Vertical, -55 to 125 degC, 2.54 mm Pitch, 3-Pin, Male, RoHS | Bass, Gain, INPUT1, INPUT2, INPUT3, INPUT4, Mid_Range, MUTE_LR, MUTE_M, OUTPUT SELECT, Trebble | SMTC-TSW-103-07-X-S | CMP-1024-00331-1 | 11
GBJ3510_T0_00601 | Bridge Rectifier | BR1 | GBJ3510_T0_00601 | GBJ3510_T0_00601 | 1
0805 | Capacitor, Resistor | C1, C2, C3, C4, C5, C6, C7, C8, C9, C10, C11, C12, C13, C14, C15, C17, C18, C19, C20, C21, C22, C23, C24, C25, C26, C27, C28, C30, C31, C32, C33, C34, C35, C36, C37, C38, C39, C40, C41, C42, C43, C44, C45, C46, C47, C48, C49, C50, C51, C52, C53, C55, C56, C58, C59, C60, C61, C62, C63, C64, C65, C66, C67, C68, C69, C72, C73, C74, C75, C77, C78, C79, C80, C81, C82, C83, C84, C85, C88, C89, C90, C91, C92, C93, C94, C95, C96, C97, R1, R2, R3, R4, R5, R6, R7, R8, R10, R11, R12, R13, R14, R15, R16, R17, R18, R19, R20, R21, R22, R23, R24, R25, R26, R27, R28, R29, R30, R31, R32, R33, R34, R35, R36, R37, R38, R39, R40, R41, R42, R43, R44, R45, R46, R47, R48, R49, R50, R51, R52, R53 | 6-0805_N | Cap, Res1 | 140
860010373010 | Capacitor Polarised | C16, C29, C54, C57 | CAPPRD250W52D630H1250 | 860010373010 | 4
UFW1V472MHD | Capacitor Polarised | C70, C71, C76, C86, C87 | CAPPRD750W80D1825H3750 | UFW1V472MHD | 5
B320A-13-F | DIODE SCHOTTKY 20V 3A SMA | D1, D2 | FP-SMA-MFG | CMP-12790-000001-1 | 2
61301611821 | THT Vertical Socket Header WR-PHD, Pitch 2.54 mm, Single Row, 16 pins | Display Header | 61301611821 | CMP-1502-01343-1 | 1
1845040000 | OMNIMATE Signal - series LM | E1 | LM_3_5_90_04 | CMP-1559-01732-1 | 1
ATS-TI1OP-521-C1-R1 | Hardware | H1, H2 | ATSTI1OP521C1R1 | ATS-TI1OP-521-C1-R1 | 2
ATTINY828-AU | Integrated Circuit | IC1 | QFP80P900X900X120-32N | ATTINY828-AU | 1
TDA7439DS13TR | Integrated Circuit | IC2 | SOIC127P1032X265-28N | TDA7439DS13TR | 1
TPA3116D2QDADRQ1 | Integrated Circuit | IC3, IC5 | SOP65P810X120-33N | TPA3116D2QDADRQ1 | 2
TMUX1134PWR | Integrated Circuit | IC4 | SOP65P640X120-20N | TMUX1134PWR | 1
TPS54332DDA | Integrated Circuit | IC6, IC7 | SOIC127P600X170-9N | TPS54332DDA | 2
61300611121 | THT Vertical Pin Header WR-PHD, Pitch 2.54 mm, Single Row, 6 pins | ICSP | 61300611121 | CMP-1502-01070-1 | 1
Inductor | Inductor | L1 | 2220 | Inductor | 1
10uH | Inductor | L2, L3, L4, L5, L6, L7 | INDPM110100X400N | SRP1038A-4R7M | 6
2.5uF | SMD | L8, L9 | 710-74437346025 | 710-74437346025 | 2
ELM70303GD | LED | LED1, LED2, LED3, LED4, LED5, LED6, LED7, LED8, LED9, LED10 | ELM70303GD | ELM70303GD | 10
61300511121 | THT Vertical Pin Header WR-PHD, Pitch 2.54 mm, Single Row, 5 pins | MUX, Volume | 61300511121 | CMP-1502-01068-1 | 2
3386P-1-103LF | Resistor | R9 | 3386P_1 | 3386P-1-103LF | 1
5D2-18LCS | Thermistor | RT1 | 5D218LCS | 5D2-18LCS | 1
0402 | Resistor | SB1, SB2, SB3, SB4, SB5, SB6, SB7, SB8, SB_5V, SB_9V, SB_15V, SB_15V2 | 0402 | Res1 | 12
