WilliamVanRaemdonck/Project_Practise_Enterprise_2_Amplifier/(list of files, cad)

Other CAD files:
1. Hardware/frontpanel/frontpanel_with_guides.FCStd
1. Hardware/frontpanel/frontpanel_with_guides - empty .FCStd
1. Hardware/frontpanel/frontpanel_with_guides - Copy.FCStd
1. Hardware/frontpanel/frontpanel_with_guides - Copy (2).FCStd
1. Hardware/frontpanel/frontpanel_with_guides - Copy (2).dxf
