WilliamVanRaemdonck/Project_Practise_Enterprise_2_Amplifier/1. Hardware/PPE2/PPE2.pdf

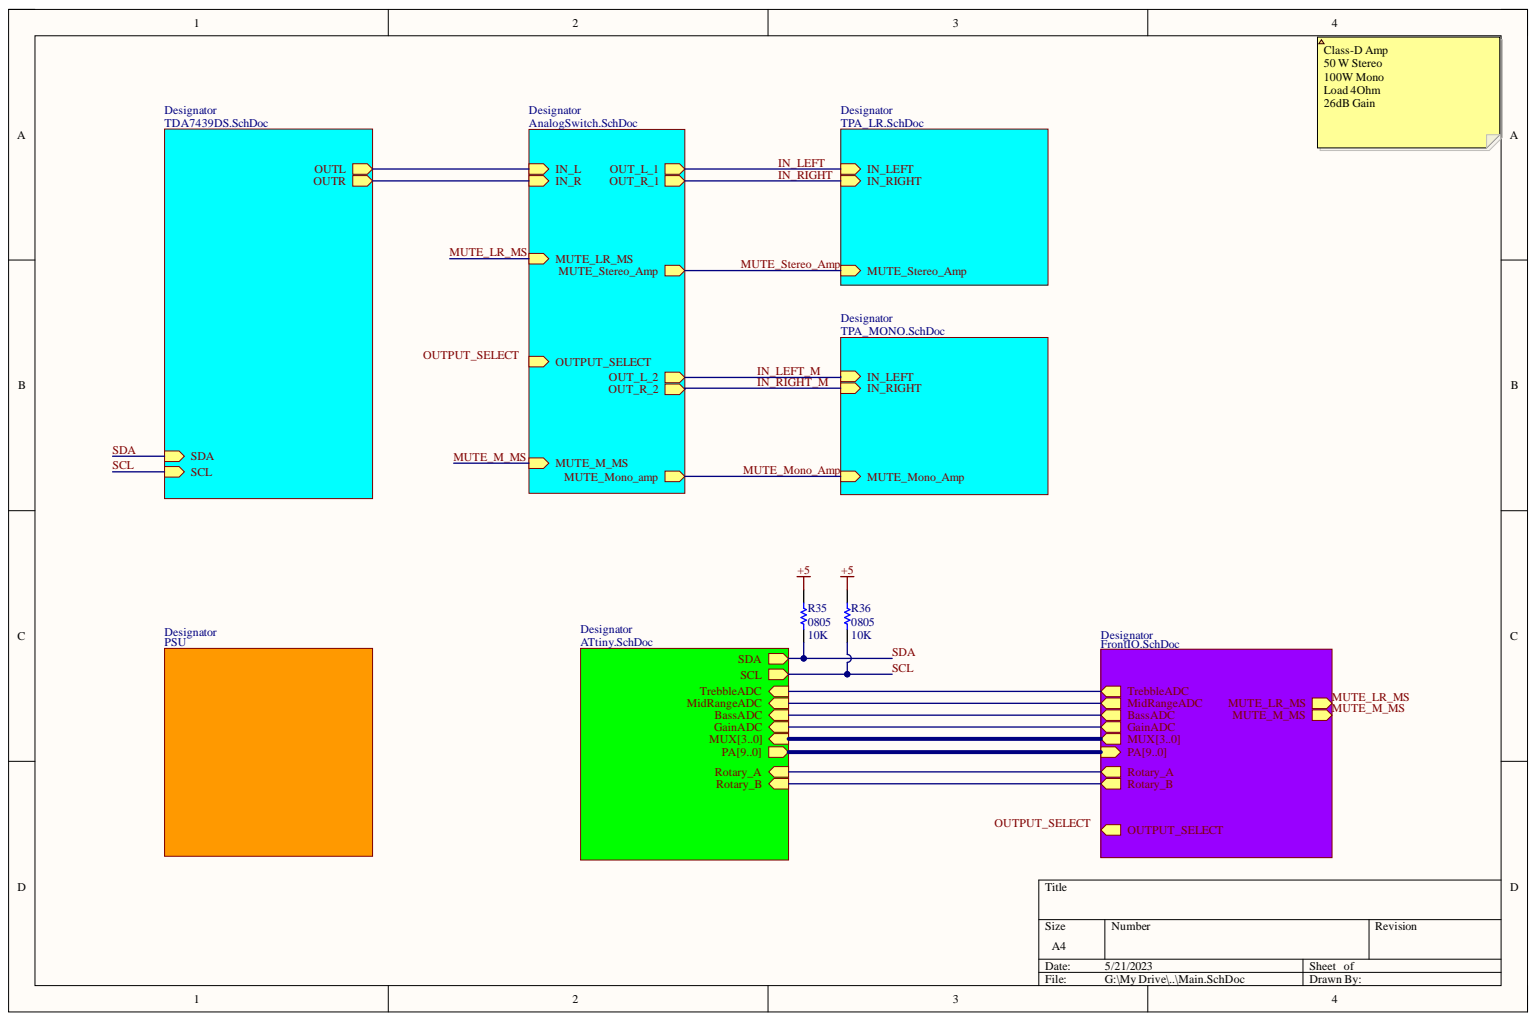
[picture p61: page 1]

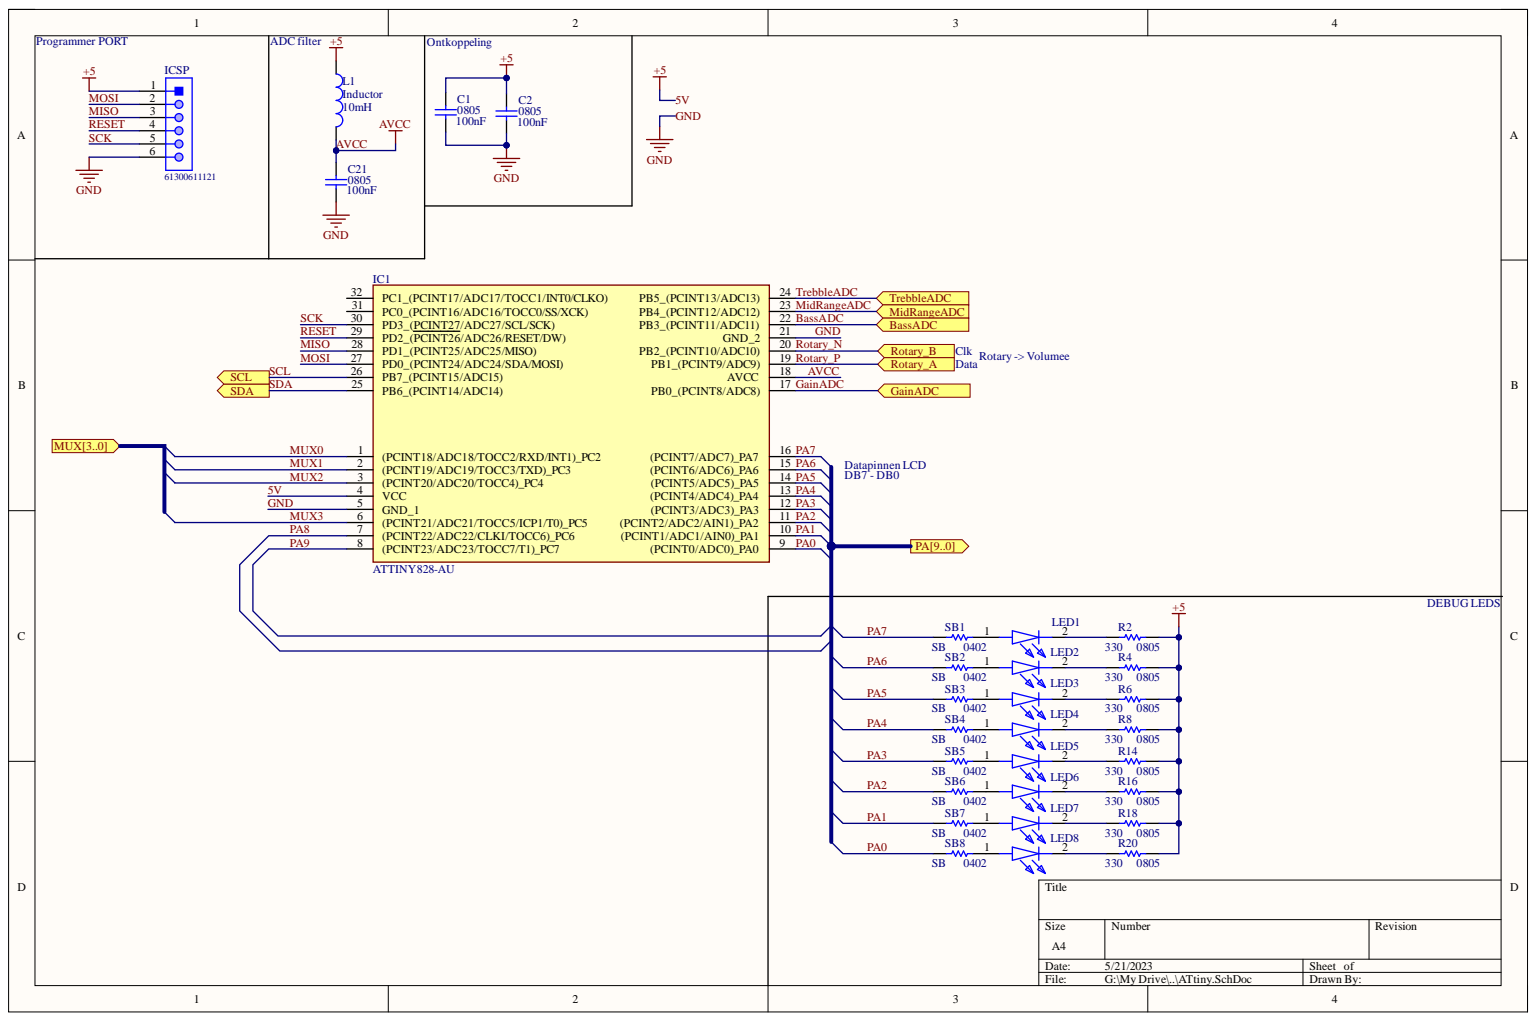
[picture p62: page 2]

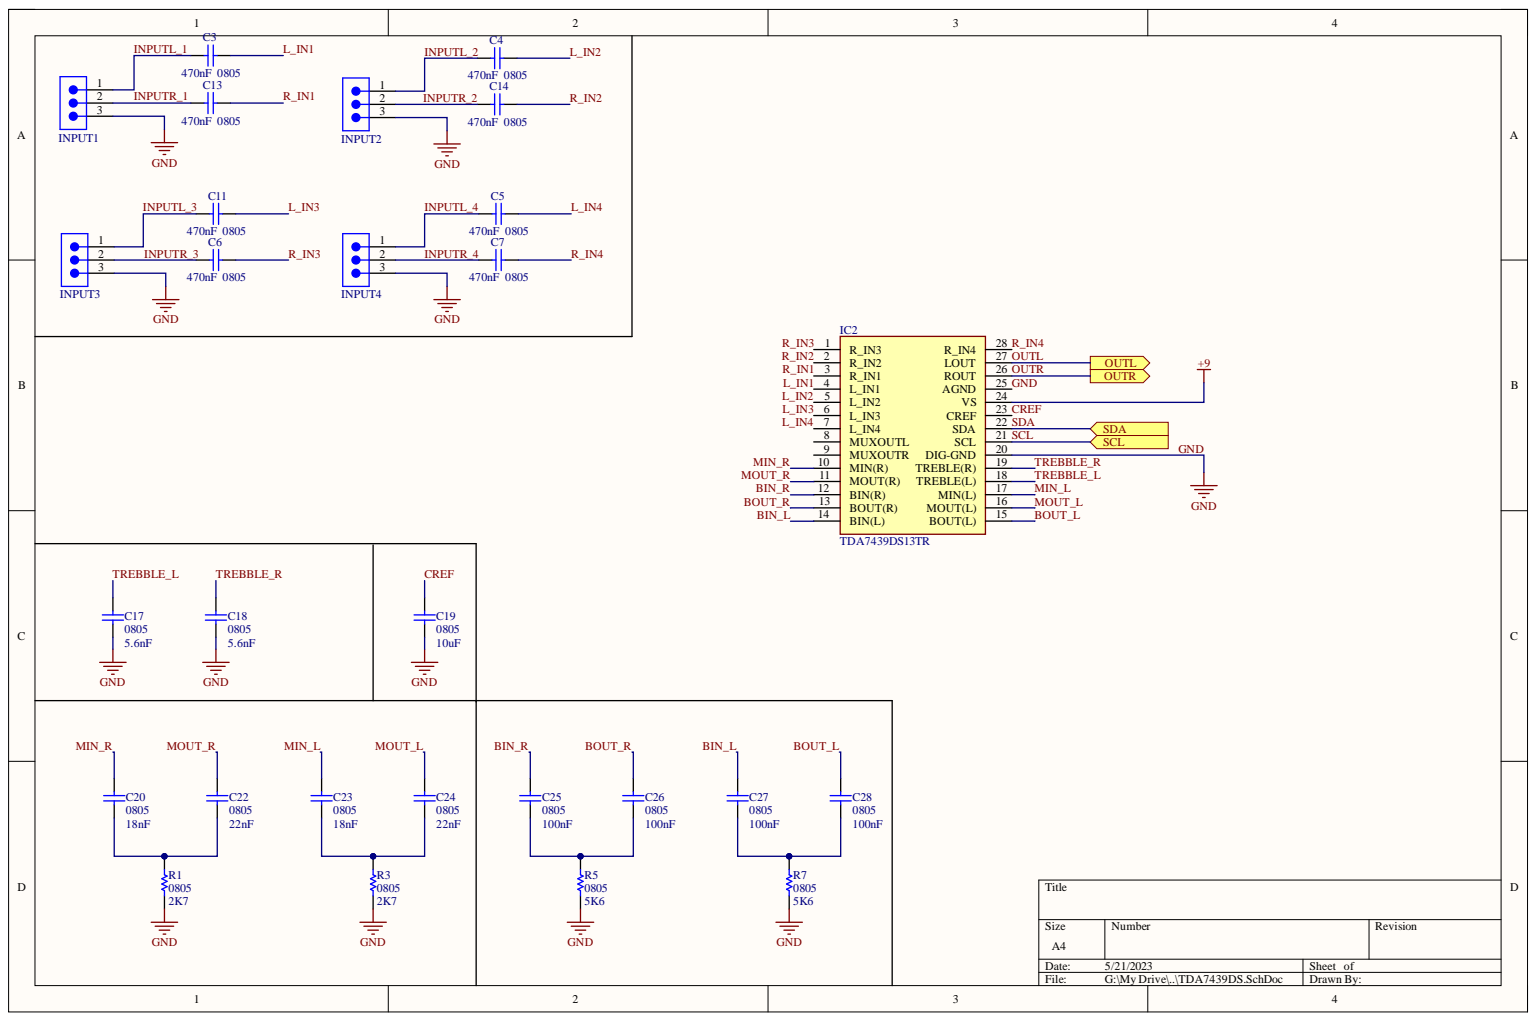
[picture p63: page 3]

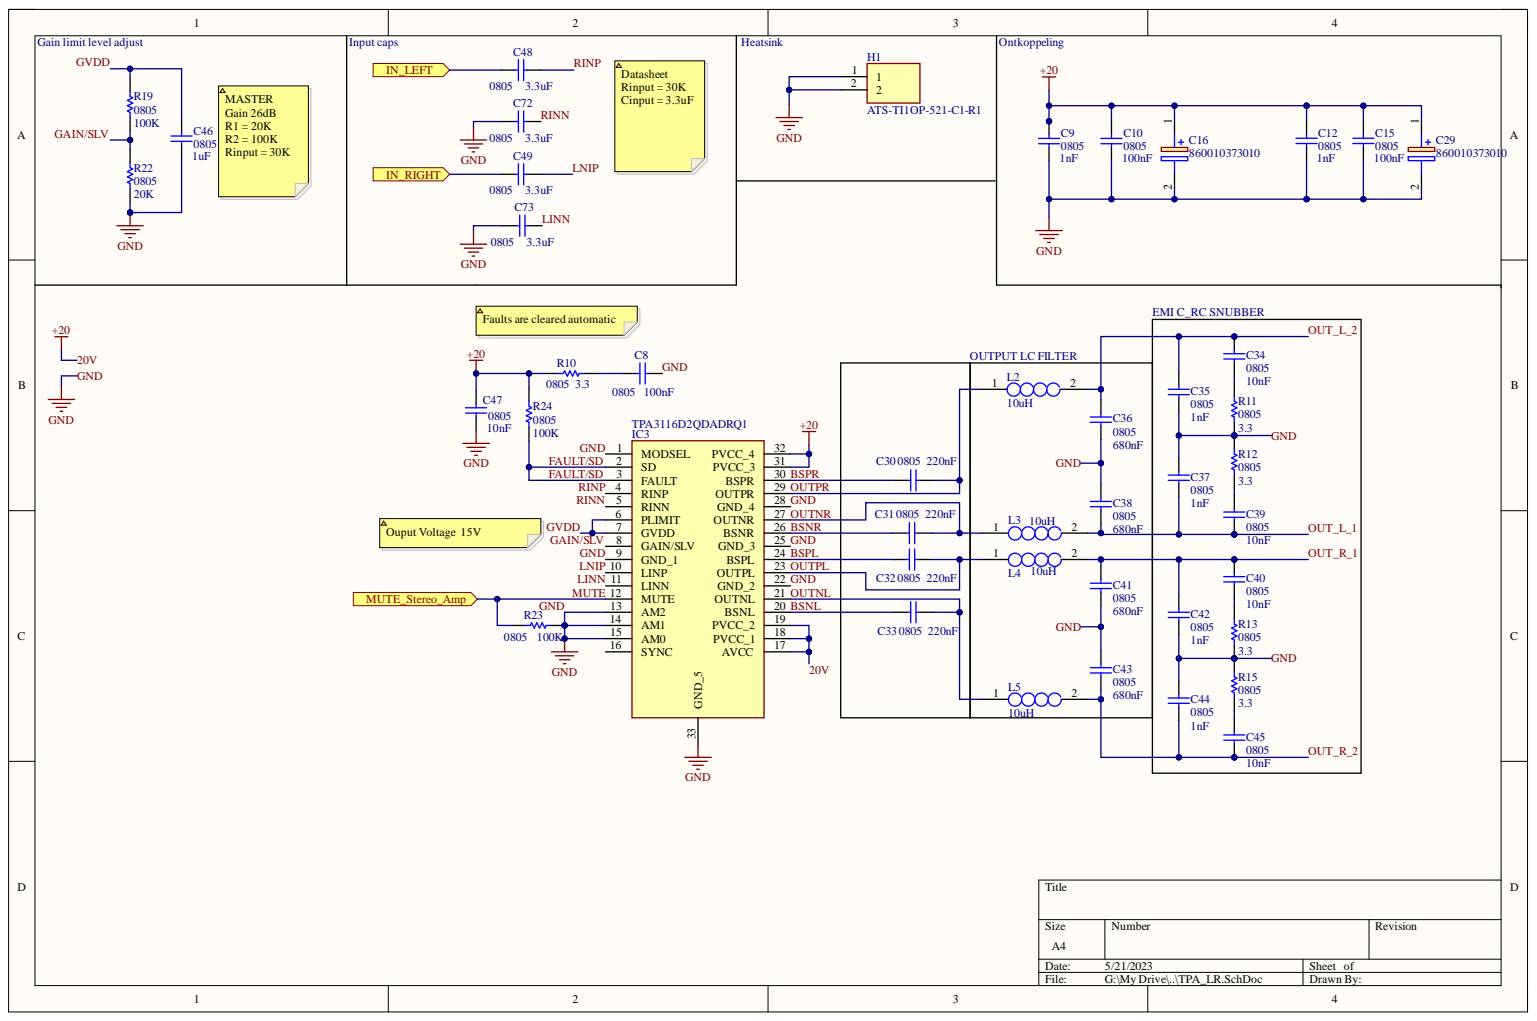
[picture p64: page 4]

/SLV GND LNIP LINN

BSPL OUTPL OUTNL 2 3

G N D | 1 3 | 2 0 | BSN L

1 4 | 1 9
1 5 | 1 8

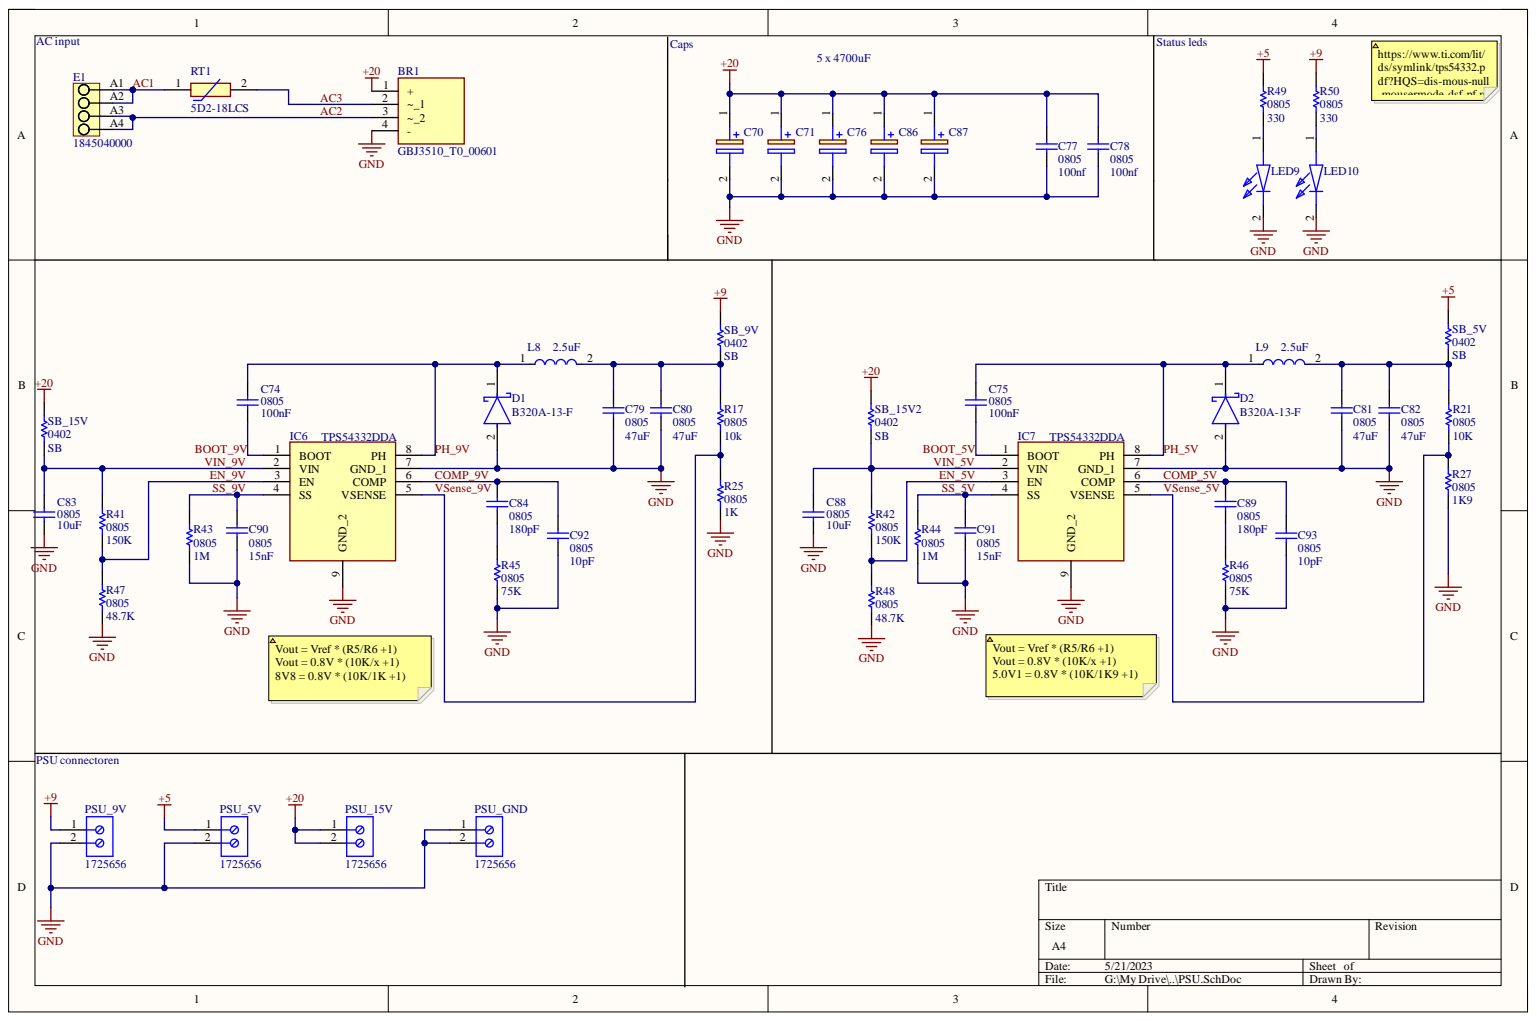
[picture p65: page 5]

ds/symlink/tps54332.p
df?HQS=dis-mous-null
-mousermode-dsf-pf-n

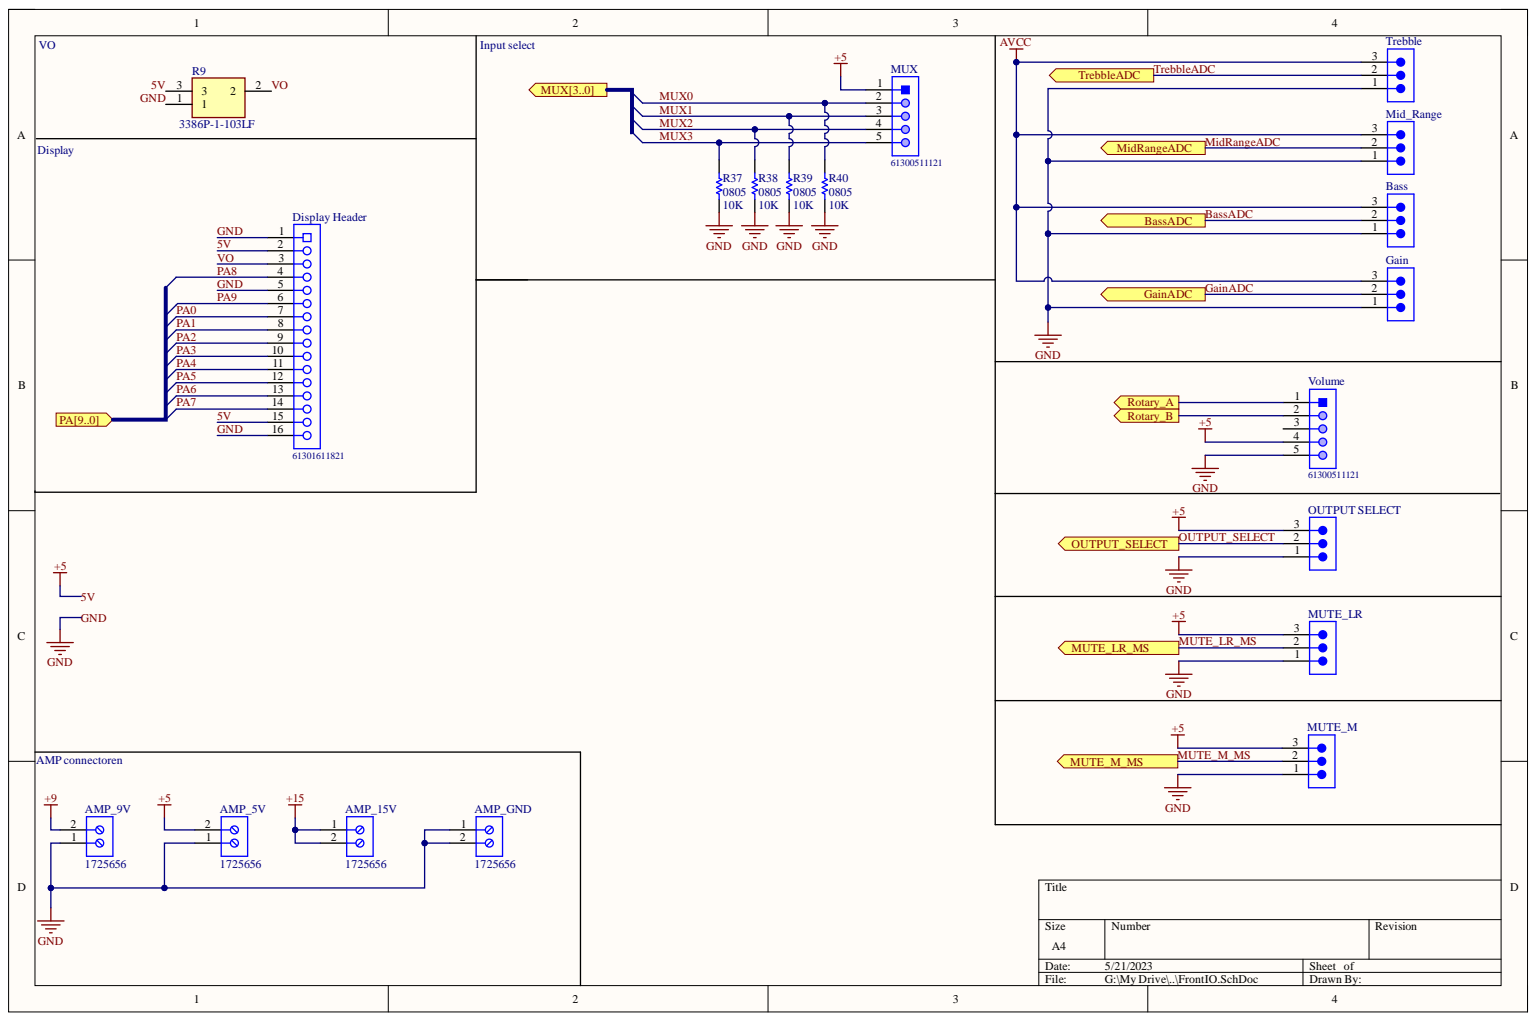
[picture p66: page 6]

GND GND

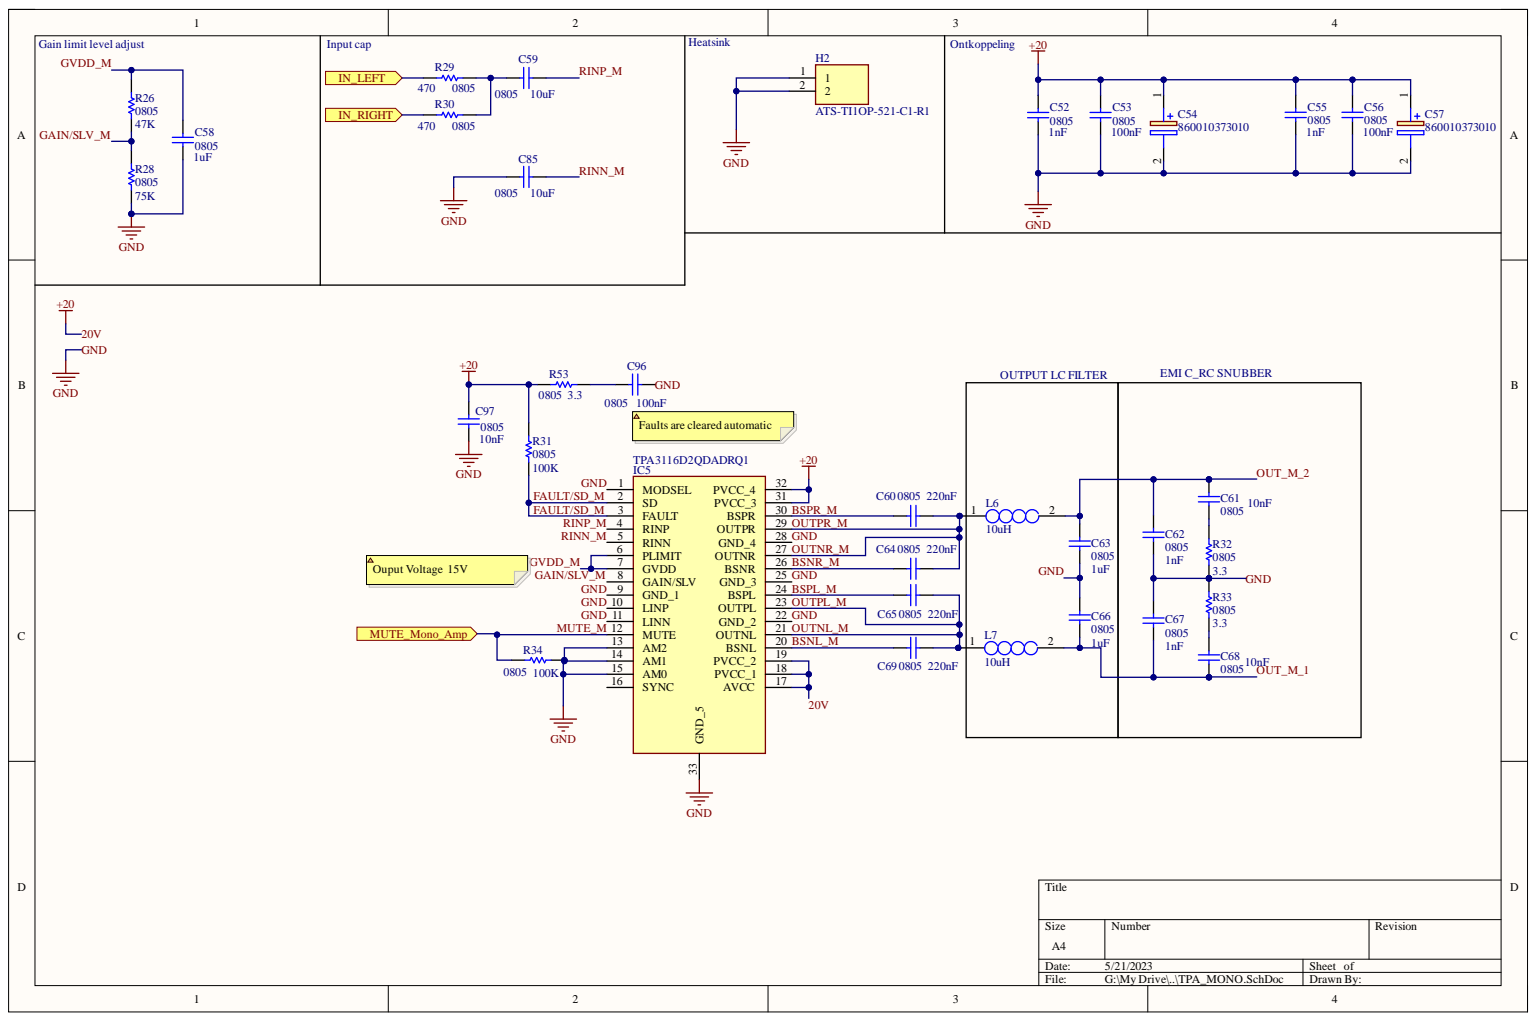
[picture p67: page 7]

FA U LT /SD _M | 3 | | 3 0 BSPR_

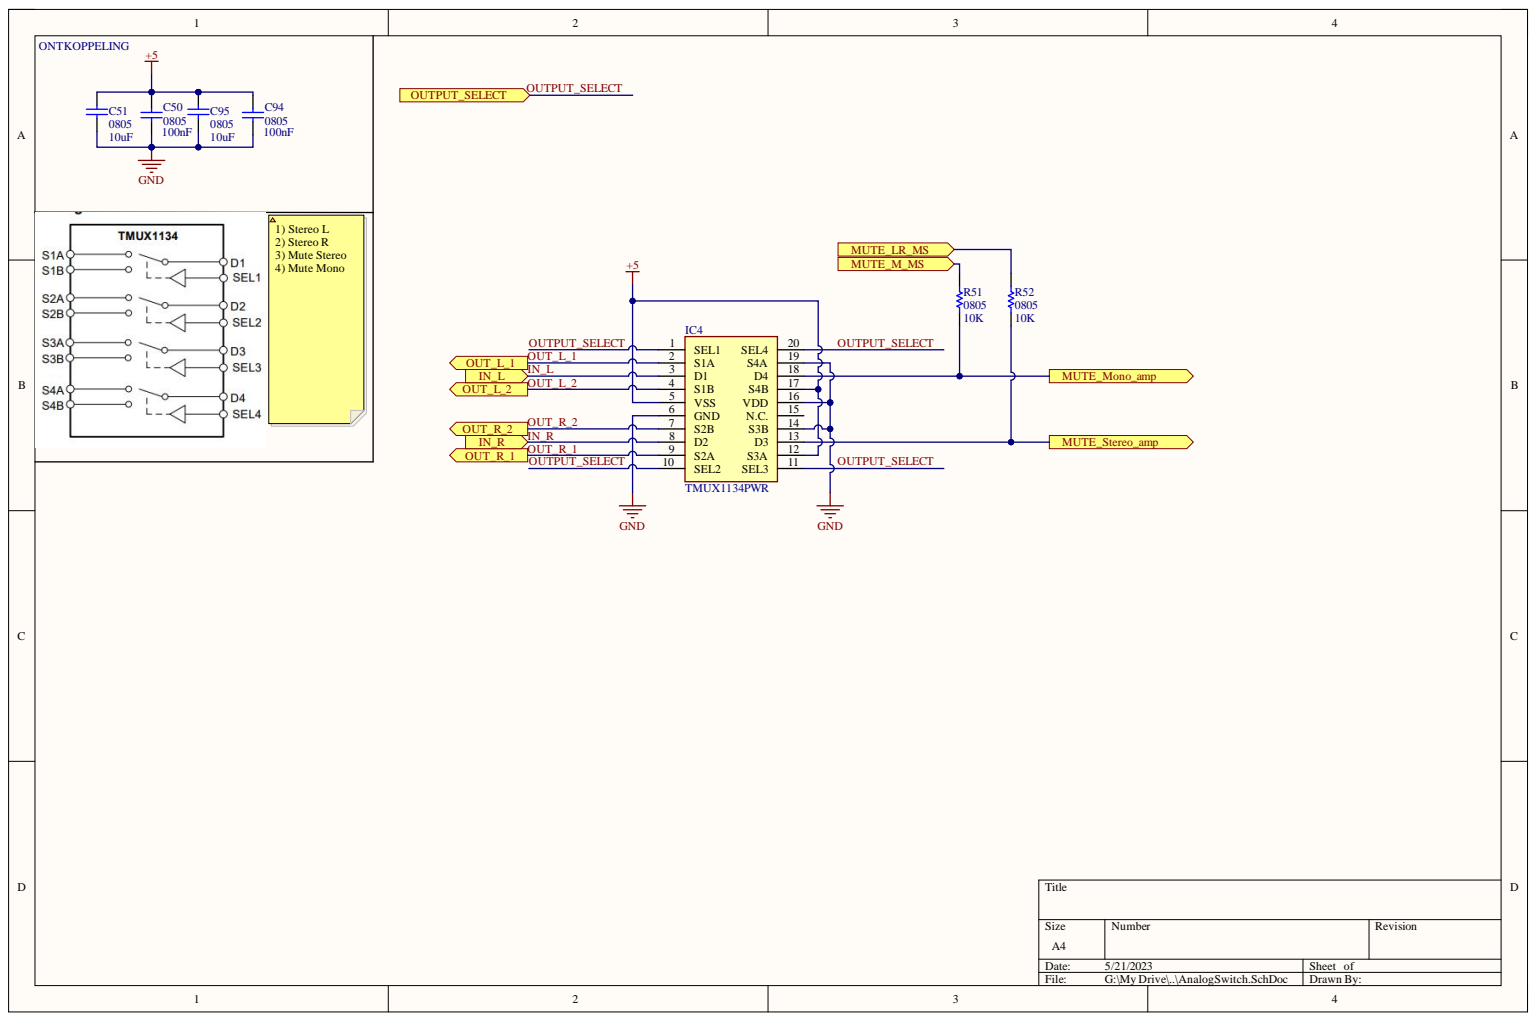
[picture p68: page 8]

S1A 2 S4A N.C. | 19
D1 3
S1B 4
VSS 5
GND 6 | 15
S2B 7
D2 8
S2A 9
SEL2 10

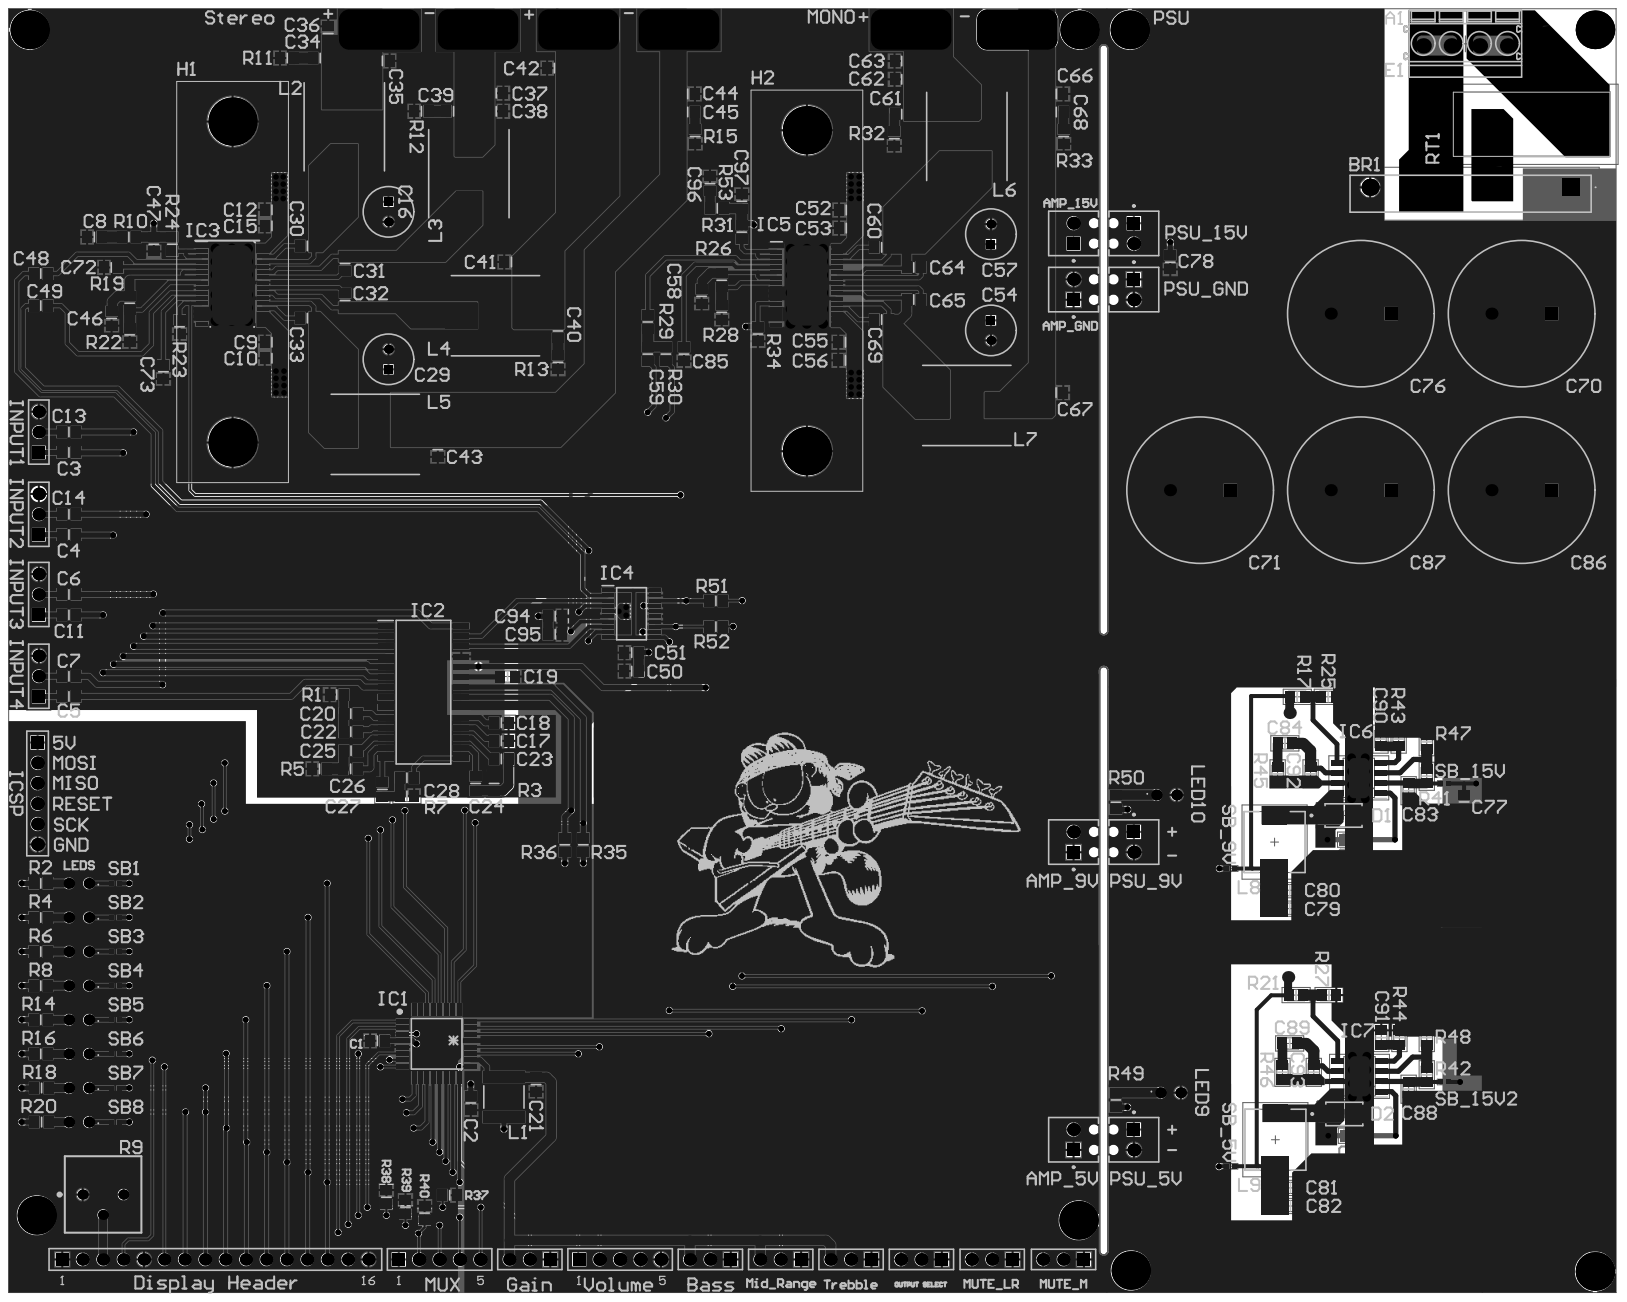
[picture p69: page 9]
