WilliamVanRaemdonck/Project_Practise_Enterprise_2_Amplifier/3. Documents/Altium_Schema.pdf

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

# Programmer Port

# ADC filter


Audio controle | Input


# Ontkoppeling

# Gain limit level adjust


Faults are cleared automatic

# AC input

C86 ¹ 2

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

# Display

VO

Title; Size; Number; Revision; File:; G:\My Drive\..\FrontIO.SchDoc; Drawn By:; Trebble; Mid_Range; Bass; TrebbleADC; MidRangeADC; BassADC; GainADC GainADC; Gain; Rotary_A Rotary_B PA[9..0]; Volume; MUX[3..0]; Display Header; 5V GND; GND 5V VO; PA8 GND; OUTPUT SELECT; OUTPUT_SELECT; MUTE_LR; MUTE_LR_MS; MUTE_M; MUTE_M_MS; GND; MUX0 MUX1 MUX2 MUX3; MUX; Input select; AMP_5V; AMP_9V; AMP_15V; AMP_GND; AVCC; AMP connectoren; POT; Rotary Encoder

GND GND

# Ontkoppeling Gain limit level adjust


# ONTKOPPELING

# Audio Switch
