WilliamVanRaemdonck/Project_Practise_Enterprise_2_Amplifier/(list of files, drawings)

Other design files:
1. Hardware/PPE2/AMP.PcbLib
1. Hardware/PPE2/AMP.SchLib
1. Hardware/PPE2/AnalogSwitch.SchDoc
1. Hardware/PPE2/ATtiny.SchDoc
1. Hardware/PPE2/FrontIO.SchDoc
1. Hardware/PPE2/Main.SchDoc
1. Hardware/PPE2/PPE2.PcbDoc
1. Hardware/PPE2/PPE2.PrjPcb
1. Hardware/PPE2/PSU.SchDoc
1. Hardware/PPE2/Schlib1.SchLib
1. Hardware/PPE2/TDA7439DS.SchDoc
1. Hardware/PPE2/TPA_LR.SchDoc
1. Hardware/PPE2/TPA_MONO.SchDoc
