WilliamVanRaemdonck/Project_Practise_Enterprise_2_Amplifier/1. Hardware/Fan_PSU/12V_PSU_Linear/12V_PSU_Linear.kicad_pcb

## KiCad design pcb/heli/heli.kicad_pcb

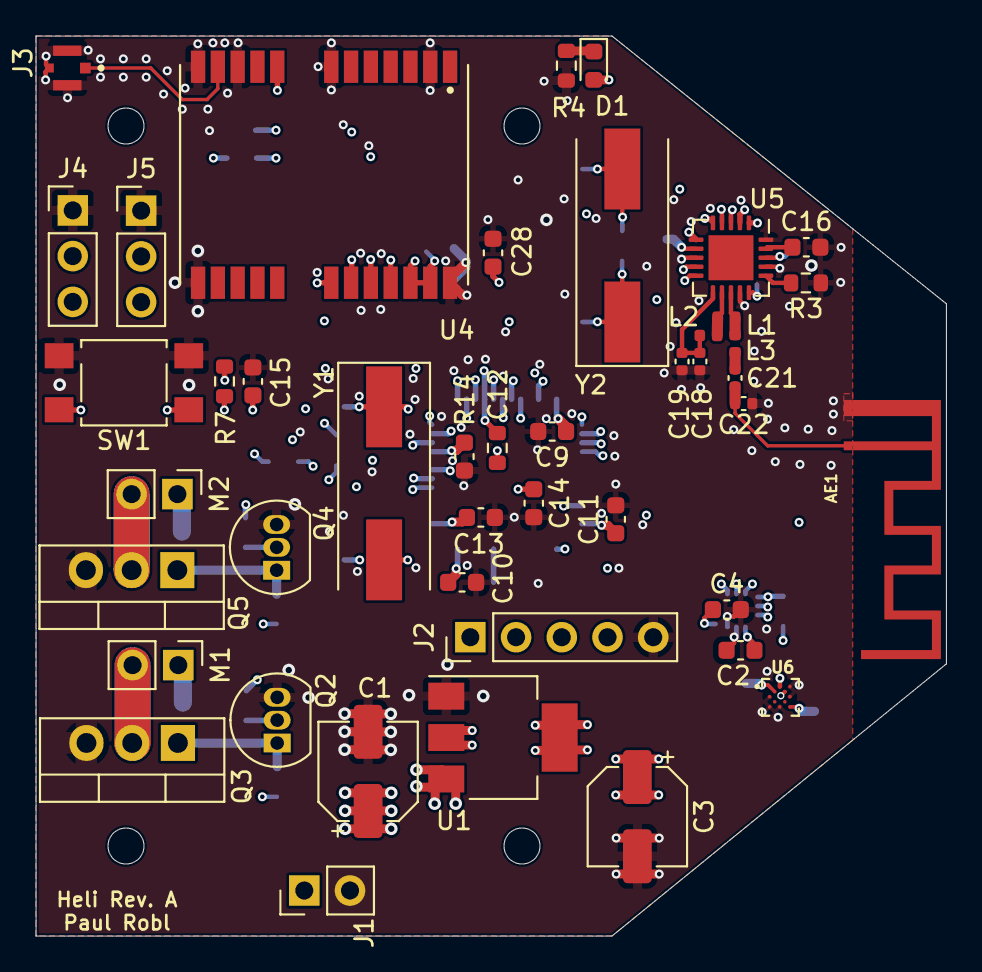
[picture p70: board heli.kicad_pcb from above]

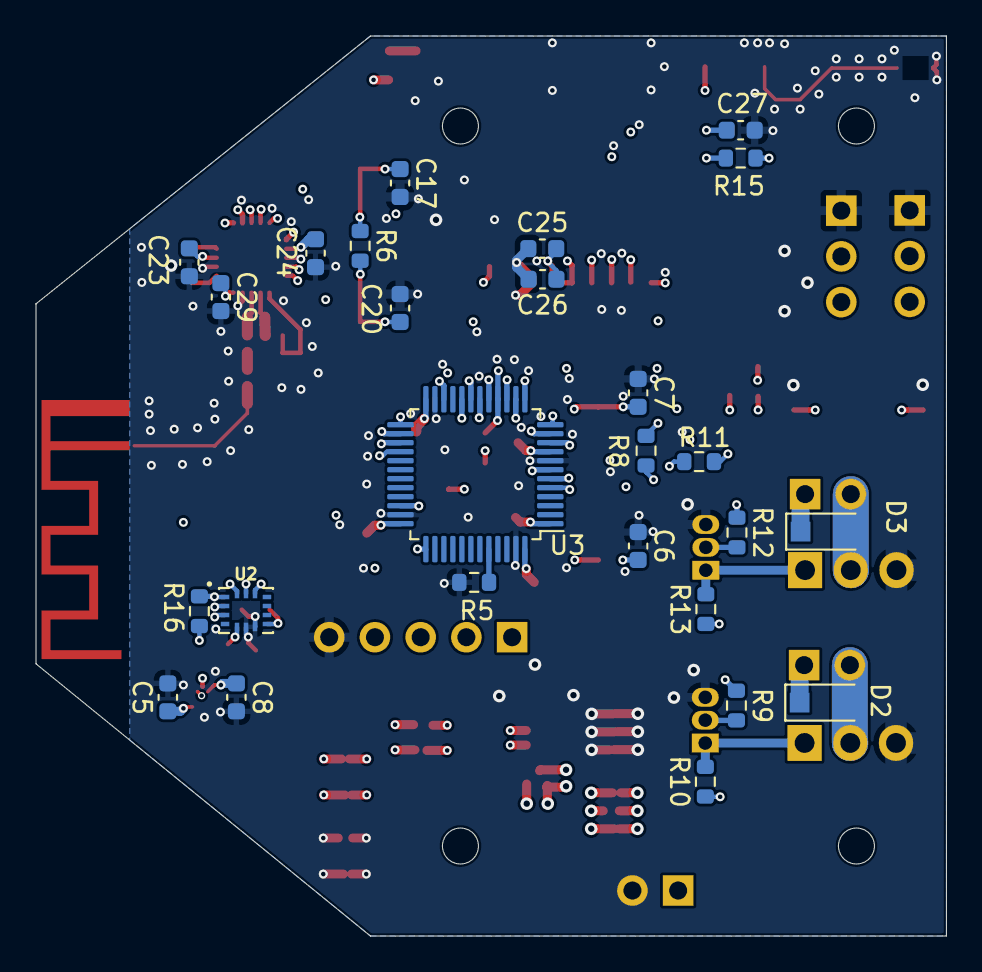
[picture p71: board heli.kicad_pcb from below]

Board: 4 copper layers, 50.6 x 50.0 mm, 72 parts (26 on the bottom side), 44 nets.

Parts:
**REF: MountingHole_2mm
**REF#2: MountingHole_2mm
AE1: Antenna_Shield; TRACE_ANTENNA_2.4GHZ_15.2MM
C1: 10uF; CP_Elec_5x5.4
C2, C4, C5, C8, C9, C10, C11, C12, C13, C15, C25, C26, C27, C29: 100nF; C_0603_1608Metric
C3: 22uF; CP_Elec_5x5.4
C6, C7, C17, C20: 30pF; C_0603_1608Metric
C14, C28: 10uF; C_0603_1608Metric
C16: 33nF; C_0603_1608Metric
C18: 2.2nF; C_0402_1005Metric
C19: 4.7pF; C_0402_1005Metric
C21: 1.5pF; C_0402_1005Metric
C22: 1.0pF; C_0402_1005Metric
C23: 10nF; C_0603_1608Metric
C24: 1nF; C_0603_1608Metric
D1: LED; LED_0603_1608Metric
D2, D3: 1N5819; D_SOD-123F
J1: Batterie; PinHeader_1x02_P2.54mm_Vertical
J2: Debug; PinHeader_1x05_P2.54mm_Vertical
J3: CONMHF4-SMD-G-T; LINX_CONMHF4-SMD-G-T
J4, J5: Servo; PinHeader_1x03_P2.54mm_Vertical
L1: 8.2nH; L_0402_1005Metric
L2: 2.7nH; L_0402_1005Metric
L3: 3.9nH; L_0402_1005Metric
M1, M2: Motor_DC; PinHeader_1x02_P2.54mm_Vertical
Q2, Q4: BC547; TO-92_Inline
Q3, Q5: IRLZ44N; TO-220-3_Vertical
R3: 22k; R_0603_1608Metric
R4: 70; R_0603_1608Metric
R5, R7, R10, R13, R15: 10k; R_0603_1608Metric
R6, R8, R11, R14, R16: 1M; R_0603_1608Metric
R9, R12: 20k; R_0603_1608Metric
SW1: SW_MEC_5E; SW_SPST_TL3305A
U1: AZ1117-3.3; SOT-223-3_TabPin2
U2: BMI270; XDCR_BMI270
U3: STM32F103CBTx; LQFP-48_7x7mm_P0.5mm
U4: NEO-M9N-00B; XCVR_NEO-M9N-00B
U5: NRF24L01; QFN-20-1EP_4x4mm_P0.5mm_EP2.5x2.5mm
U6: BMM150; XDCR_BMM150
Y1: 8MHz; Crystal_SMD_HC49-SD
Y2: 16MHz; Crystal_SMD_HC49-SD

Connections:
3.3V: C2.1, C3.1, C4.1, C5.1, C8.1, C9.1, C10.1, C11.1, C12.1, C13.1, C14.1, C23.1, C24.1, C25.1, C26.1, C28.1, C29.1, D1.2 (A), J2.1, J4.2, J5.2, R7.1, R8.1, R11.1, R14.1, R15.1, R16.1, U1.2 (VO), U2.5 (VDDIO), U2.8 (VDD), U3.1 (VBAT), U3.9 (VDDA), U3.24 (VDD), U3.36 (VDD), U3.48 (VDD), U4.22 (V_BCKP), U4.23 (VCC), U5.7 (VDD), U5.15 (VDD), U5.18 (VDD), U6.A1 (PS), U6.B2 (VDDIO), U6.E5 (VDD)
7.4V: C1.1, D2.1 (K), D3.1 (K), J1.1, M1.1 (+), M2.1 (+), R10.1, R13.1, U1.3 (VI)
/Back Motor/M-: D3.2 (A), M2.2 (-), Q5.2 (D)
/GPS/GPS50ohms: J3.1, U4.11 (RF_IN)
/IMU/SCL: U2.3 (ASCX), U6.A3 (SCK)
/IMU/SDA: U2.2 (ASDX), U6.B4 (SDI)
/Main Motor/M-: D2.2 (A), M1.2 (-), Q3.2 (D)
/PWM1: R8.2, R9.1, U3.10 (PA0)
/PWM2: R11.2, R12.1, U3.11 (PA1)
/Radio/RADIO50ohm: AE1.1 (A), C21.2, C22.2
/SERVO1: J4.3, U3.12 (PA2)
/SERVO2: J5.3, U3.13 (PA3)
GND: AE1.2 (Shield), C1.2, C2.2, C3.2, C4.2, C5.2, C6.1, C7.1, C8.2, C9.2, C10.2, C11.2, C12.2, C13.2, C14.2, C15.1, C16.2, C17.2, C18.1, C19.1, C20.2, C22.1, C23.2, C24.2, C25.2, C26.2, C27.1, C28.2, C29.2, J1.2, J2.5, J3.S1, J3.S2, J3.S3, J4.1, J5.1, Q2.3 (E), Q3.3 (S), Q4.3 (E), Q5.3 (S), R3.1, R4.2, R5.1, SW1.2, U1.1 (GND), U2.6 (GNDIO), U2.7 (GND), U3.8 (VSSA), U3.23 (VSS), U3.35 (VSS), U3.47 (VSS), U4.2 (D_SEL), U4.7 (V_USB), U4.10 (GND), U4.12 (GND), U4.13 (GND), U4.24 (GND), U5.8 (VSS), U5.14 (VSS), U5.17 (VSS), U5.20 (VSS), U6.A5 (CSB), U6.C1 (SDO), U6.C5 (GND), U6.E1 (GND), U6.E3 (GND)
GPS_CSN: U3.22 (PB11), U4.18 (SDA/SPI_CS_N)
GPS_NRST: C27.2, R15.2, U3.14 (PA4), U4.8 (RESET_N)
IMU_CSN: U2.12 (CSB), U3.25 (PB12)
unnamed: C6.2, U3.5 (PD0), Y1.2
unnamed: C7.2, U3.6 (PD1), Y1.1
unnamed: C16.1, U5.19 (DVDD)
unnamed: C17.1, R6.1, U5.9 (XC2), Y2.2
unnamed: C18.2, C19.2, L2.2, U5.11 (VDD_PA)
unnamed: C20.1, R6.2, U5.10 (XC1), Y2.1
unnamed: C21.1, L3.2
unnamed: D1.1 (K), R4.1
unnamed: L1.1, L2.1, U5.12 (ANT1)
unnamed: L1.2, L3.1, U5.13 (ANT2)
unnamed: Q2.1 (C), Q3.1 (G), R10.2
unnamed: Q2.2 (B), R9.2
unnamed: Q4.1 (C), Q5.1 (G), R13.2
unnamed: Q4.2 (B), R12.2
unnamed: R3.2, U5.16 (IREF)
unnamed: R5.2, U3.44 (BOOT0)
RADIO_CE: U3.18 (PB0), U5.1 (CE)
RADIO_CSN: U3.19 (PB1), U5.2 (CSN)
RADIO_IRQ: U3.20 (PB2), U5.6 (IRQ)
RESET: C15.2, J2.4, R7.2, SW1.1, U3.7 (NRST)
SPI2_MISO: R16.2, U2.1 (SDO), U3.27 (PB14)
SPI2_MOSI: U2.14 (SDX), U3.28 (PB15)
SPI2_SCK: U2.13 (SCX), U3.26 (PB13)
SPI_MISO: R14.2, U3.16 (PA6), U4.20 (TXD/SPI_MISO), U5.5 (MISO)
SPI_MOSI: U3.17 (PA7), U4.21 (RXD/SPI_MOSI), U5.4 (MOSI)
SPI_SCK: U3.15 (PA5), U4.19 (SCL/SPI_CLK), U5.3 (SCK)
SWCLK: J2.2, U3.37 (PA14)
SWDIO: J2.3, U3.34 (PA13)
