WilliamVanRaemdonck/Project_Practise_Enterprise_2_Amplifier/(commit log)

2023-03-04 fixt project layout
    [AMP.PcbLib, AMP.SchLib, ATtiny.SchDoc, AnalogSwitch.SchDoc, Main.SchDoc, PPE2.PcbDoc, PPE2.PrjPcb, TDA7439DS.SchDoc]
2023-03-06 display start
    [FrontIO.SchDoc, PPE2.PcbDoc, PSU.SchDoc]
2023-03-09 PCB cleanup
    [ATtiny.SchDoc, Main.SchDoc, PPE2.PcbDoc, PSU.SchDoc, TPA_LR.SchDoc, TPA_MONO.SchDoc]
2023-03-13 PCB cleanup start
    [ATtiny.SchDoc, AnalogSwitch.SchDoc, FrontIO.SchDoc, Main.SchDoc, PSU.SchDoc, TDA7439DS.SchDoc, TPA_LR.SchDoc, TPA_MONO.SchDoc]
2023-03-14 pcb clean up done
    [AnalogSwitch.SchDoc, PPE2.PcbDoc, PSU.SchDoc]
2023-03-16 PCB final
    [AnalogSwitch.SchDoc, FrontIO.SchDoc, Main.SchDoc, TPA_LR.SchDoc, TPA_MONO.SchDoc]
2023-03-19 PCB done
    [AnalogSwitch.SchDoc, Main.SchDoc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]
2023-03-27 I2C fixed
2023-04-08 Display code done
    [ATtiny.SchDoc]
2023-04-14 start rotary encoder
2023-04-14 rotary encoder fix & blok ipv X
    [Display.c, main.c]
2023-04-17 EEPROM added
    [PSU.SchDoc]
2023-04-24 20V fix
    [ATtiny.SchDoc, FrontIO.SchDoc, Main.SchDoc, PSU.SchDoc, TPA_LR.SchDoc, TPA_MONO.SchDoc]
2023-05-02 clk = 8Mhz
    [PPE2.xlsx]
2023-06-20 EEPROM fix
    [ATtiny.SchDoc, AnalogSwitch.SchDoc, BOM.xlsx, FrontIO.SchDoc, PPE2.PrjPcb, PSU.SchDoc, TDA7439DS.SchDoc, TPA_LR.SchDoc]
